smprather/janestreet-blog-serial-protocol-emulator/wiki/concepts/factored-hardware-blocks.md

---
title: Factored Hardware Blocks
created: 2026-09-17
updated: 2026-09-17
type: concept
tags: [architecture, area-budget, protocol]
sources: [raw/transcripts/gemini-asic-competition-discussion-2026-09.md]
confidence: medium
---

# Factored Hardware Blocks
> **What you'll learn here:** which hardware primitives are shared between protocols instead of written once per protocol, and why no line-coding scheme beyond NRZI/Manchester is needed
>
> **You can verify this by:** `tb/tb_pe_crc.v` proves the CRC engine across widths, and `python3 tools/gen/crc_config.py --check` regenerates the constant table this page refers to.

Keep the programmable core small by factoring shared, parameterized primitives between the execution engine and the pin matrix (TX/RX FIFOs + interrupts decouple them). Firmware then works at byte/packet level; bit-level timing lives in hardware. Area figures below are transcript estimates (~130 nm cells) to confirm after first synthesis per [[concepts/competition-overview]].

## Blocks to factor out

- 8x/16x oversampling CDR engine ([[concepts/cdr-oversampling]]): edge-triggered phase counter, majority-vote filtering, clean data-strobe/bit-clock out. Serves 10BASE-T and PS/2. IMPLEMENTED as rtl/pe_dru.v: **116 cells / 2.1k um2** mapped, vs the ~60-cell estimate. Serves 10BASE-T and PS/2 receive; it is NOT needed by UART (which tracks its own start bit from a free-running tick, in firmware — see firmware/uart_echo.pe) and not by USB-LS or CAN (NRZ with stuffing, no guaranteed transition rate to lock a phase counter to).
- Parametric SerDes shift registers (8-32 b, MSB/LSB-first, configurable shift edge): serves every listed protocol; avoids per-bit pin toggling in microcode. IMPLEMENTED as rtl/pe_serdes.v (runtime order/length, bit-placer RX): 539 cells / 11.2k um2 mapped, 17.2k um2 routed @78% util, iverilog PASS + verilator clean.
- Framing/transcoding: NRZI/Manchester transcoder, bit-stuffer/unstuffer (USB: 6 ones; CAN: 5 equal bits), OE/tri-state direction control for I2C ACKs, SWD turnaround, USB SE0. (~15-40 cells each.) IMPLEMENTED as rtl/pe_nrzi.v + rtl/pe_manch.v + rtl/pe_bitstuff.v + rtl/pe_codec_mux.v: nrzi 15 cells, manch 7, bitstuff 99 (runtime run_cfg 1-15), mux 130 — the four files are one tier, one module per file. Config byte muxes any SUBSET of stages in/out; pipeline order fixed (stuff -> line code) as that is the physically correct composition.
- Configurable CRC LFSR (polynomial/seed/bit-reversal masks): CRC-5/16 (USB), CRC-15 (CAN), CRC-32/FCS (Ethernet), CRC-8 (SMBus). ~30 instructions/bit in firmware, i.e. **240 per byte**, against the **48 clocks (and therefore 48 instructions) per byte** that a 10BASE-T byte costs at the locked 60 MHz operating point — so **5.0x** over budget, and this one is hardware by necessity. Both halves of that arithmetic are tabulated in [[concepts/ethernet-scope]] (6 clocks/bit at 60 MHz x 8 bits = 48; 240/48 = 5.0), and the clock is locked by [[decisions/adr-005-60mhz-turbo]]. The 60 MHz choice is what improved it from 7.5x at 40 MHz, so the older 7.5x figure is the pre-turbo number, not a second reading of the same one. IMPLEMENTED as rtl/pe_crc.v: **209 cells / 3.4k um2** mapped, vs the ~120-cell estimate. The overrun is the price of supporting BOTH CRC families without a mode bit — one 32-bit shift-right register serves every polynomial from CRC-5 to CRC-32, so the cell count does not grow with CRC width. Constants for every target: [[reference/crc-config]] (generated, checked against the RevEng catalogue).

## 8b/10b explicitly not needed

None of the targets use it: 10BASE-T is Manchester (8b/10b arrived with 100BASE-TX/1000BASE-T); USB LS is NRZI + stuffing; CAN is NRZ + stuffing; UART/SPI/I2C/JTAG/SWD/PS/2 are raw NRZ with clocks or start/stop framing. Revisit only if chasing gigabit-class protocols.
