smprather/janestreet-blog-serial-protocol-emulator/COLD-START.md

# Cold-start instructions

## Message to the next manager

You are the **Pi Harness & RTL Hardening Steward** for
`/home/mylesp/janestreet-blog-serial-protocol-emulator`.

Start by reading `HANDOFF.md`, `reviews/2026-09-23/PROJECT-REVIEW.md`, and
`wiki/STATUS.md`. Continue the user's persistent task: check the live Pi harness
in the shared tmux window `pi-protocol-worker` every 15 minutes (use window
names, not pane IDs — names survive an OOM or terminal loss), review completed
RTL/hardening work,
and keep the project review and handoff current. The user allows occasional
synthesis and STA screens to catch RTL that cannot be hardened. Slow corner is
also a hold-check corner. Never run physical flow, DRC, or LVS.

The default tmux server and worktree are shared live state. Never kill the tmux
server. Inspect `git status` before editing; substantial uncommitted work is
present. Do not reset, revert, or clean it. Leave Pi at its prompt after each
task. The user delegated ALL project decisions to the manager (2026-09-24):
nothing is waiting on user choices; implement the tasks the manager assigns.
The one boundary: host-controller GUI/bridge work waits for the user's plan
from their separate session.

Interrupt protocol (2026-09-24): as your LAST action before ending any turn,
write `/tmp/pi-worker-interrupt` containing a concise summary of what you did
and its evidence. Mid-task, write `QUESTION: <text>` there (and keep working)
or `BLOCKED: <text>` (and stop at your prompt). The manager deletes the file
before each dispatch and wakes on its appearance.

**WORKLOG rotation + concision (manager ruling 2026-09-25):** the shared log
rotates to `logs/worklog/YYYY-MM-DD[-NN].md` at ~10 MB or day boundaries (the
manager rotates; archives are committed and greppable - the trail never dies).
Log LINES are concise entries (≤ ~500 chars); full reports/evidence live in
`reviews/` and interrupt files - link, do not inline. This rule exists because
the log hit 58 MB and GitHub warned on every push.

## DOCS AUTHORITY (manager ruling 2026-09-26): maps are the ARCHITECTURE
## authority; figures cite the RTL, never a map
`diagrams/project-plan.puml` and `diagrams/project-progress.puml` are the
architecture authority and live on **main**. Two rules follow, and they exist
because the branches began merging into each other and a figure drawn from a map
that later moved becomes a stale claim wearing a figure's clothes:

1. **A protocol figure must cite the RTL, the frozen contracts, or the frozen
   reviews DIRECTLY — and must not restate a map claim as its source. A figure
   quoting a map is a defect in the figure.** Maps may LINK figures; never the
   reverse. So a figure's `Sources:` line points at `firmware/*.pe`, `rtl/*.v` or
   a `reviews/` contract — never at `project-plan`/`project-progress`.
2. **MAP-TRIGGER for the rolling docs review.** When the maps change on **main**,
   re-grep the whole figure set for any claim that PARALLELS map content (the C1
   class: a figure restating a number the map also states) and re-verify each
   against the RTL. A map move then costs a re-grep instead of a rediscovery.

The trigger baseline as of this ruling, so the next reviewer can tell in one
command whether the trigger has fired:

```sh
git rev-parse --short main:diagrams/project-plan.puml      # was aa2554c
git rev-parse --short main:diagrams/project-progress.puml  # was 42d4acc
```

Both were last moved by `3a2fd6a` ("refresh both maps to current reality, and
take the three accuracy corrections"). Checked against this ruling at the time:
**no figure on either docs branch cites a map as its source** — all five
`proto-*.puml` source lines point at the firmware (`firmware/dmx512.pe`,
`i2c_adv.pe`, `midi_xfer.pe`, `spi_mode3.pe`, `uart_flow.pe`), which is exactly
the pattern the ruling wants. The single grep hit, `proto-freqmeter-timing.puml`
saying "the map uses all sixteen bytes", is a MEMORY map and not `project-plan` —
a false positive from the reviewer's own check, recorded because the next
reviewer will hit it too.

**THE TRIGGER HAS FIRED, and its semantics were SHARPENED at the same time
(manager ruling, later on 2026-09-26) — the sharpened form is the one to use:**

1. **A measured ACT result is the FIGURE's claim.** The map **LINKS the owning
   figure and drops its own copy.** The six that triggered this: sr04's 5816 µs
   and 1160 µs, DMX's 12.38 µs mark and 88.06 µs break, the freqmeter's 158 Hz
   and 10 kHz endpoints. The map is architecture and indexes; it is not a second
   data store.
2. **Universal architecture constants MAY stay in the maps** — `I2CTICK` = 1 µs
   and the 260-clock / 4.3333 µs UART half-bit. They are not act measurements,
   and every act that uses or avoids that tick states it independently.
3. **The trigger now checks FIGURES-against-RTL only.** A map-vs-figure overlap on
   a *measured* number is a **DEFECT (a restatement)**, not a candidate to
   triage — which is what pass 9's sweep had to treat as a candidate, by hand,
   with a method it twice got wrong.

The map edit is diag-proto's. The trigger's job on its next fire is therefore
narrower and sharper: re-verify each act figure's measured numbers against the
RTL and its testbench, and report any measured number that also appears in a map
as a defect, with the figure named.

## THE MERGE GATE (manager standing order, 2026-09-25). A merge is not pushed
until `regress/verify_merge.sh` is green, and its output is quoted in the
interrupt. This exists because 5b4731f was pushed with six RED timing acts and
every gate the project owns had been green a minute earlier: R3's new
`dbg_hold`/`dbg_step` inputs never reached the fw branch's testbenches, so their
ports floated to Z, the execute gate went X and six unrelated programs sat at
reset. No gate could catch it — until the merge, the two states did not coexist.
`./regress/verify_merge.sh --list` prints the affected set and runs nothing;
`--self-test` runs the mapper's own 27 checks; exit 1 is red WITH a named case,
3 is a gate error, and **4 is inconclusive (the run died) — which is not a pass
and must not be reported as one**. Full evidence:
`reviews/2026-09-25/MERGE-FORENSICS-5B4731F.md` §5-§6.

**The mutation suites are MAPPED, not skipped** (manager ruling 2026-09-25). A
narrowed gate runs a suite only if one of its `MUTABLE` targets intersects the
merge's changed set, and it PRINTS every suite as RUN or SKIP with the reason —
so a green gate says what it covered and what it did not. Anything unmappable
(no `MUTABLE` line) or an empty selection runs ALL suites; a suite with an EMPTY
`MUTABLE` mutates nothing in the repo and is never narrowed away. The
`MUTATE_ONLY` selector travels as an environment variable, so an ordinary
`./regress/run_all.sh` — the master/nightly gate — is untouched and always runs
everything. `regress/check_mutation_lists.sh` proves each `MUTABLE` list still
covers every file its harness writes, and runs inside the full gate too: a
stale list would make the mapper skip the suite guarding a changed file.

## Continuous work protocol (user standing order 2026-09-25: "I don't want
to come back and find nobody working")

- The queue is the source of work: `wiki/STATUS.md` "Next steps (ordered)",
  the current checkpoint queue in this file, and any dispatch message.
- **CHAIN TASKS — WITHIN THE SAME TURN.** A pi session cannot start its own
  next turn, so chaining MUST happen before you end the turn: when a task is
  done and the queue holds a clearly-scoped next task (inside the
  manager-adopted plans, no new design decision needed), rewrite the
  interrupt file for the finished task and IMMEDIATELY start the next task
  in the same turn, logging `TASK-START` in `WORKLOG.md`. The interrupt file
  is the manager's async review trigger — it is NOT the end of your work.
  ENDING YOUR TURN MEANS STOPPING: only end the turn when the queue is
  empty (`IDLE-QUEUE-EMPTY` in WORKLOG), the next step is ambiguous or
  needs a ruling (`QUESTION:`), or it touches the host-controller boundary
  (`BLOCKED:`). (Root cause, 2026-09-25: workers wrote the interrupt as
  their last action and ended the turn — chaining then never triggered and
  the user found idle TUIs. Same-turn continuation is the fix.)
- STOP chaining and wait for the manager only when: the next step is
  ambiguous or needs a design/ruling decision, it touches the host-controller
  boundary (write `BLOCKED:`), the queue is empty, or the dispatch explicitly
  says stop.
- If your input box contains unexpected text when a turn ends, treat it as a
  possibly-mangled mid-turn dispatch from the manager: surface it in your
  interrupt (`QUESTION:`) instead of ignoring it.
- **BEFORE REPORTING AN ITEM OPEN, CHECK THE OWNER'S LOG (manager rule,
  2026-09-25).** Never report another actor's work as open from your own
  picture of the tree: `grep 'actor | TASK-DONE' WORKLOG.md` for the owning
  actor first. The trap is real and it bit me — I wrote "memory reads are
  EXPECTED to fail until the host fixes B1" into the bring-up runbook, and the
  gui-worker had already fixed B1 and pushed it minutes earlier. A stale
  warning is as harmful as a missing one: it sends a board operator down the
  wrong path and invents work that is already finished.
- Throughput discipline: prefer whole plan tasks per dispatch; keep the tree
  green at every task boundary (mutation harnesses must restore and
  `cmp`-verify before you move on); never reset/revert/clean the shared
  uncommitted worktree.
- **ONE RUN AT A TIME (single-run lock, 2026-09-25).** This worktree is shared,
  so only one mutation-capable run may be in it at once. `regress/run_all.sh`,
  every `regress/mutate_*.sh` and `regress/run_firmware_tests.sh` take
  `flock` on `/tmp/chip-run-all.lock` (via `regress/run_lock.sh`) and **fail
  fast** with exit 75 and a message naming the current holder. The lock is
  process-based, so a killed run releases it automatically — there is no stale
  lock to clear by hand. It is reentrant through `CHIP_RUN_LOCK_HELD`, because
  `run_all.sh` invokes the mutation harnesses as its own children; those skip
  the lock rather than deadlocking their parent. The hazard it closes is real:
  on 2026-09-25 the manager's `run_all_merge` and the worker's `run_all` ran
  CONCURRENTLY, so two harnesses were mutating and restoring the same RTL at
  once. The per-case `cmp` restores held and nothing was corrupted, but a run
  can read a file another run has mutated — precisely the "nonsense result"
  failure the harnesses exist to detect. If you see `REFUSING TO START`, wait
  for the other run; do not retry in a loop.
- **Shared worklog (user standing order 2026-09-25):** append EVERY state
  change to `WORKLOG.md` in the repo root — one line,
  `YYYY-MM-DD HH:MM TZ | protocol-worker | EVENT | detail`, newest at the
  bottom, append-only. Events: `TASK-START`, `TASK-DONE`, `CHAIN`,
  `QUESTION`, `BLOCKED`, `RULING`, `STALL` (+ the exact reason),
  `CONTEXT-NEW` (after a `/new`). The log is the manager's debugging paper
  trail: when work stops, the manager back-traces it here and fixes the
  cause. Log the START of a task the moment you begin it — not only the
  finish — so a stall mid-task is visible.

## Current checkpoint — 2026-09-24 evening (supersedes the checkpoints below)

- The user delegated every project decision to the manager ("no pending my
  authorization at all; drive the project to completion without my
  intervention"). Decisions made and executed: E2-6 fix (CLOSED), readback =
  A1 (verified), SERDES+codec integration = the recorded recommended defaults
  (Task 3, verified), closeout hardening (Task 4, verified), squarer diagram
  layout (Task 5a, verified), hold-screen attribution (Task 5b, verified).
  GUI planning is the user's in a separate session.
- The worker runs in the shared tmux window **`pi-protocol-worker`** (created
  2026-09-24 after a wezterm OOM killed the old `%46` pane). Use window
  names, not pane IDs — names survive an OOM or terminal loss, pane IDs do
  not. Target the worker as `tmux ... -t 0:pi-protocol-worker`.
- Task 1 (E2-6 + R3 checker fixes): DONE and manager-verified — macro harness
  26/26 re-run, identity-logic code review, full regression exit 0. E2-6 and
  R3 are CLOSED; R1/R4/R5 remain recorded observations.
- Task 2 (A1 readback, `uio[4]` echo): DONE and manager-verified —
  `./regress/run_all.sh --fast -j8` 29/29 + 20/20 exit 0; mapped `pe_ctrl` STA
  screen worst setup +8.71/+8.80/+8.86 ns, worst hold −0.12/−0.16/−0.19 ns
  (unchanged from pre-A1), new echo/`spi_miso` max-path groups
  +12.09/+12.19/+12.23 ns. Evidence: `reviews/2026-09-24/`
  (`PE-CTRL-READBACK-REVIEW.md`, `manager-a1-sta/`). Baselines now: `pe_ctrl`
  463 cells / 8,661.30 µm², `pe_soc` 3,571 / 56,816.88 µm², `tt_um_top`
  4,038 / 65,686.27 µm².
- Task 3 (SERDES + codec integration, STATUS item 7): DONE and
  manager-verified (30/30 RTL, 21/21 firmware, ten mutation suites;
  `pe_soc` 4,961 cells / 82,893.77 µm², `tt_um_top` 5,363 / 91,268.06 µm²).
- Task 4 (closeout hardening: SERDES mapped STA refresh + codec mutation
  suite): DONE and manager-verified —
  `reviews/2026-09-24/CLOSEOUT-HARDENING-REVIEW.md`.
- Task 5a (squarer diagram layout, both maps): DONE — plan 3194×2476
  (1.29:1), progress 3681×2493 (1.48:1);
  `reviews/2026-09-24/DIAGRAM-SQUARER-LAYOUT.md`.
- Task 5b (hold-screen attribution + BOARD-assumption STA variants): DONE —
  `reviews/2026-09-24/HOLD-SCREEN-ATTRIBUTION.md`.
- Post-restart progress (2026-09-24 evening): Task 6 (5a/5b docs catch-up)
  DONE; Task 7 (eth-tx plan `wiki/plans/eth-tx-frame-path.md`, eight scope
  groups with defaults) DONE and the manager ADOPTED G1-G8; Tasks 8-9
  reconciled and verified the unrecorded chip-side host-protocol phase R1
  from the separate host-controller session (audited against its
  `HOST-CONTROLLER-PLAN-REVIEW` in the read-only
  `/tmp/opencode/host-controller-gui`; the A1 `uio[4]` echo is retired per
  the R0 pad ruling, its commit-latched/abort semantics live in the framed
  LOAD response; R1 pad map = `uio[4:7]` host row, `uo_out[1]` IRQ_N,
  `ui_in[3:5]` freed, 19/24 committed); lint, full regression (30/30 RTL,
  21/21 firmware, ten mutation suites), the 29/29 ctrl suite and synth are
  green after two manager-authorized behavior-preserving `pe_ctrl` fixes.
  Queue status (manager update 2026-09-25 ~01:55 CDT): plan Tasks 1-5 are
  LANDED and recorded (Manager Tasks 10-11; see the manager section in
  `reviews/2026-09-23/PROJECT-REVIEW.md`). The tree is GREEN (33/33 RTL,
  26/26 firmware, ten mutation suites). The 2026-09-24 18:43 kernel OOM
  (runaway python3, 22 GB) killed sessions mid-task and left an unrestored
  `mutate_i2c_tb.sh` m1 mutant in `rtl/pe_pinmux.v` — restored byte-exact
  from the harness snapshot. Next: plan Task 6 (eth_tx mutation suites),
  then plan Task 7 (STA + closeout), then final closeout. A RAM watchdog
  (`tools/manager/mem_monitor.sh` -> `/tmp/pi-mem-interrupt`) now guards the
  box; manager standing orders: always stay in the interrupt loop, and on a
  MEM interrupt debug and fix. The SDD ledger
  .superpowers/sdd/eth-tx-frame-path/progress.md is the task-level record.
  OPEN FINDING (a): the P3 heartbeat
  liveness gap — the heartbeat pad is gone and the R1 STATUS layout omits
  timer/pc/a/x/y, so nothing shows liveness until the R2 read path. STATUS
  item 8 GUI implementation awaits the user's plan.

## Checkpoint archive — 2026-09-23 evening (historical, superseded above)

- Pi pane `%46` returned to its prompt; last checked at 22:55 CDT, with the
  next 15-minute check due around 23:10 CDT. `wiki/STATUS.md` has no ungated
  implementation task: item 8 awaits acceptance; the readback and SERDES plans
  still need the user's choices; E2-6 awaits a decision to authorize its fix.
- Pi's draft for the Linux demo-host GUI is in `wiki/plans/demo-host-gui.md`
  (STATUS item 8 remains TODO pending user acceptance). It describes the Linux
  PC → RP2040 Pico on the Tiny Tapeout dev board → ASIC path. The Pico/RP2040 is
  the user's selected controller. PC-to-board USB/serial/HID transport remains
  hypothetical until verified. The loader SCLK cap follows `clk/6`, so 10 MHz
  is valid only at the 60 MHz operating point; the plan retains the
  sky130-framed clock-spec caveat. The seven generated-document checks passed
  explicitly by name in this session. The source/claim audit is complete and
  recorded in `reviews/2026-09-23/PROJECT-REVIEW.md` and `HANDOFF.md`.
- Pi independently exercised the E2 macro-flow checker with synthetic
  fixtures. The mutation harness reports 20/20, but this does not close the
  residual observations R1–R5 in the project review. The false pass is tracked
  as **E2-6 / R2**:
  macro type `RM_IHPSG_FAKE_B` has a 100×100 LEF and is placed at (20, 0) in a
  50×50 die, but its config points to type A's 10×10 LEF. The checker measures
  the configured file's `SIZE` without verifying that its `MACRO` declaration
  matches the configured macro type, so it accepts the invalid placement.
  Other confirmed gaps: stale PDN entries for absent instances are ignored
  (R1); wildcard liberty coverage and corner-key/file mismatches pass (R3);
  supply-pin names are hard-coded (R4); and legal alternate instance regex
  spellings are rejected (R5, fail-closed). A `-grid stdcell` PDN-connect
  probe is correctly rejected. No E2 fix was applied.
- Do **not** report E2 as fully closed. Pi recorded the GUI-plan audit and E2
  findings in `HANDOFF.md` and `reviews/2026-09-23/PROJECT-REVIEW.md`. A
  suggested next fix is to match each LEF's `MACRO` name to its configured type
  and add a regression mutation. Keep all E2 findings open until corrected and
  independently verified.
- Existing E1 evidence is recorded in
  `reviews/2026-09-23/E1-PUBLISHED-OWNERSHIP-REVIEW.md` and
  `reviews/2026-09-23/e1-published-ownership/`. Prior notes report the full fast
  regression and 30/30 MAC mutation results, plus mapped Yosys/OpenSTA screens;
  these are not physical signoff. At 22:53 CDT, mapped synthesis and three
  corner OpenSTA were rerun: synthesis counts unchanged, setup 0.00 ns, hold
  −0.87/−0.61/−0.48 ns slow/typ/fast. Fresh STA output was byte-identical to the
  recorded exact-source reports. Logs: `/tmp/e1-refresh-20260923/`.

## Pasteable short prompt

> Continue as the Pi Harness & RTL Hardening Steward. Read `COLD-START.md`,
> `HANDOFF.md`, `reviews/2026-09-23/PROJECT-REVIEW.md`, and `wiki/STATUS.md`.
> The user delegated all project decisions to the manager; implement the tasks
> the manager assigns and CHAIN into the next scoped queue item without
> idling (see the Continuous work protocol below), and
> write `/tmp/pi-worker-interrupt` (summary, or
> `QUESTION:`/`BLOCKED:` + text) as your last action before ending a turn.
> Preserve the shared uncommitted worktree. You run in the tmux window
> `pi-protocol-worker` (use window names, not pane IDs). Tasks 1-5b are
> landed and manager-verified (E2-6/R3 fixes, A1 readback, SERDES+codec
> integration, closeout hardening, diagram layout, hold attribution); the
> current queue is in `COLD-START.md`'s checkpoint. Synthesis/STA screens are
> allowed; physical flow, DRC and LVS are prohibited.
