smprather/janestreet-blog-serial-protocol-emulator/diagrams/proto-dht11-frame.png

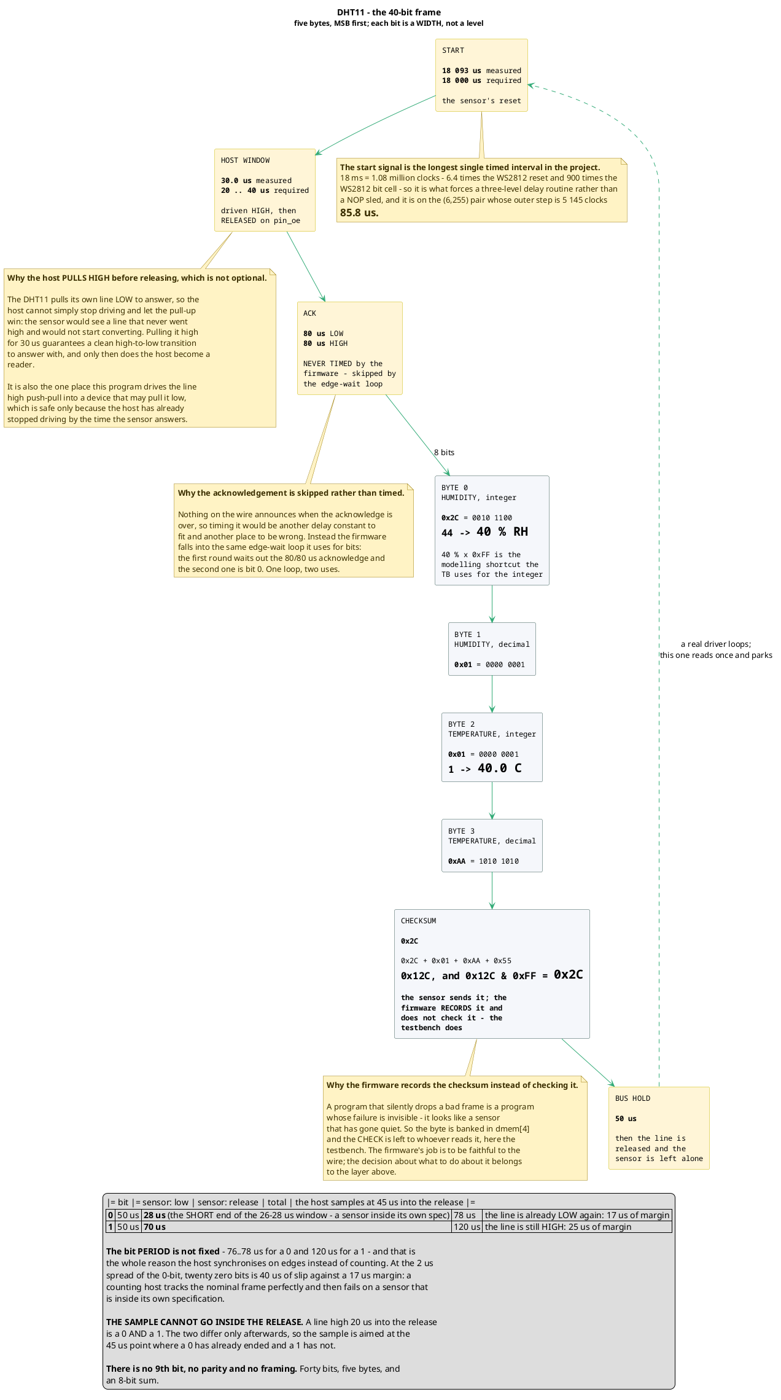
diagrams/proto-dht11-frame.png
