smprather/janestreet-blog-serial-protocol-emulator/diagrams/proto-dht11-timing.png

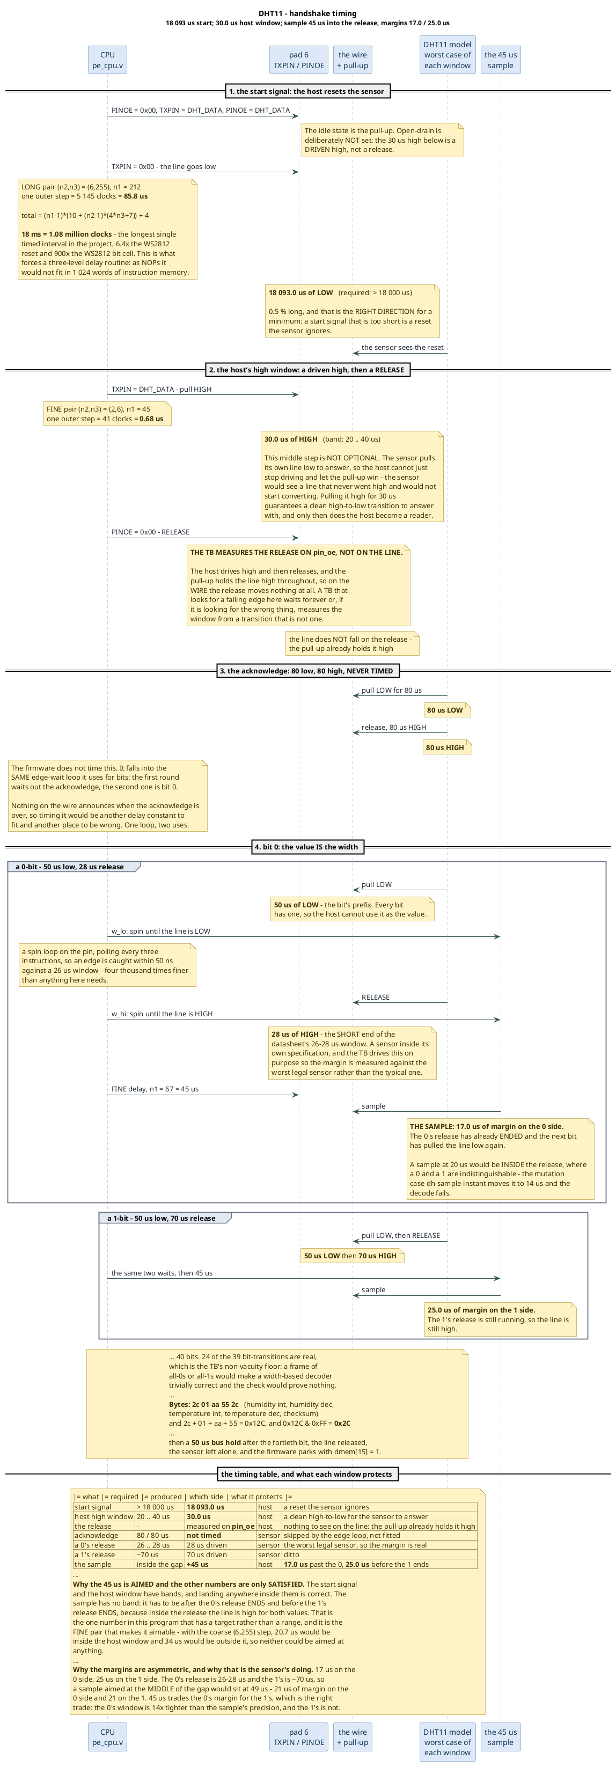
diagrams/proto-dht11-timing.png
