smprather/janestreet-blog-serial-protocol-emulator/diagrams/proto-dht11.png

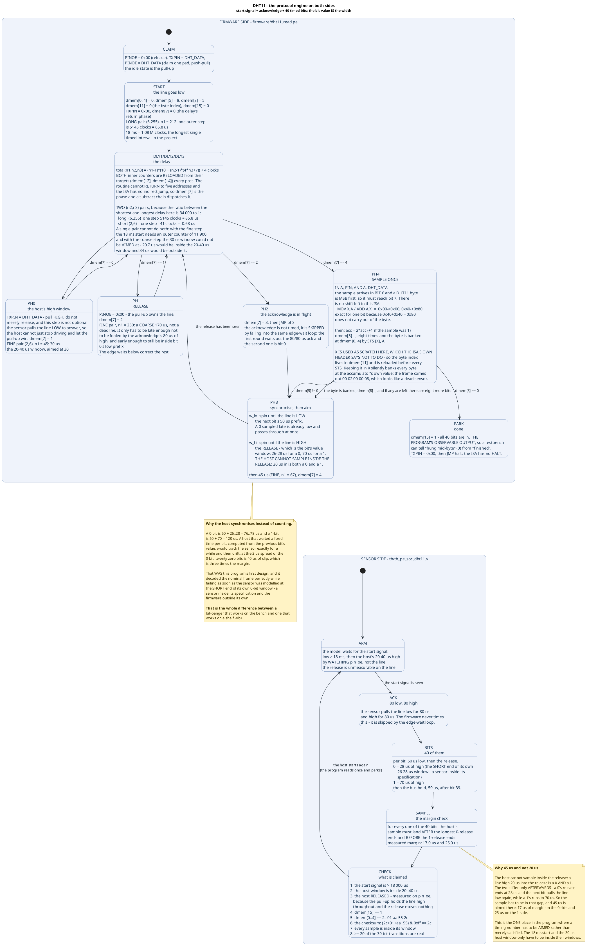
diagrams/proto-dht11.png
