smprather/janestreet-blog-serial-protocol-emulator/diagrams/proto-dmx512.png

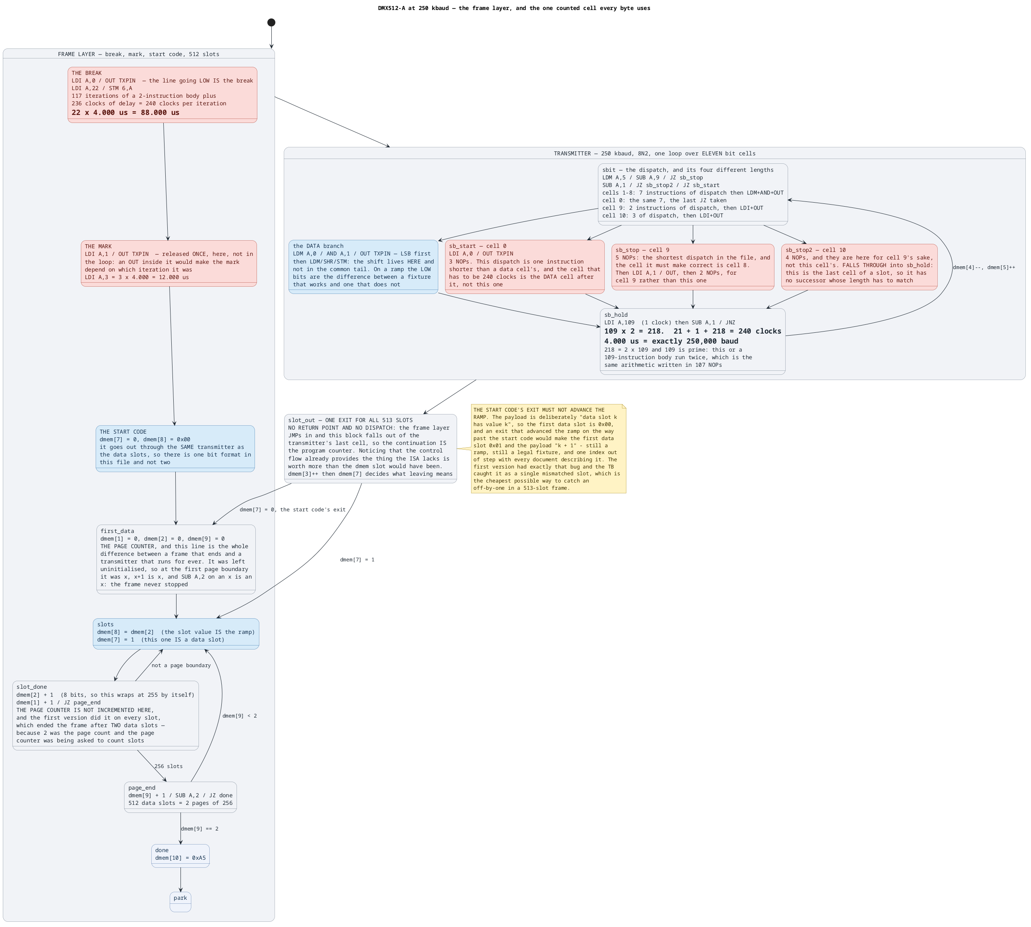
diagrams/proto-dmx512.png
