smprather/janestreet-blog-serial-protocol-emulator/diagrams/proto-dmx512_001.png

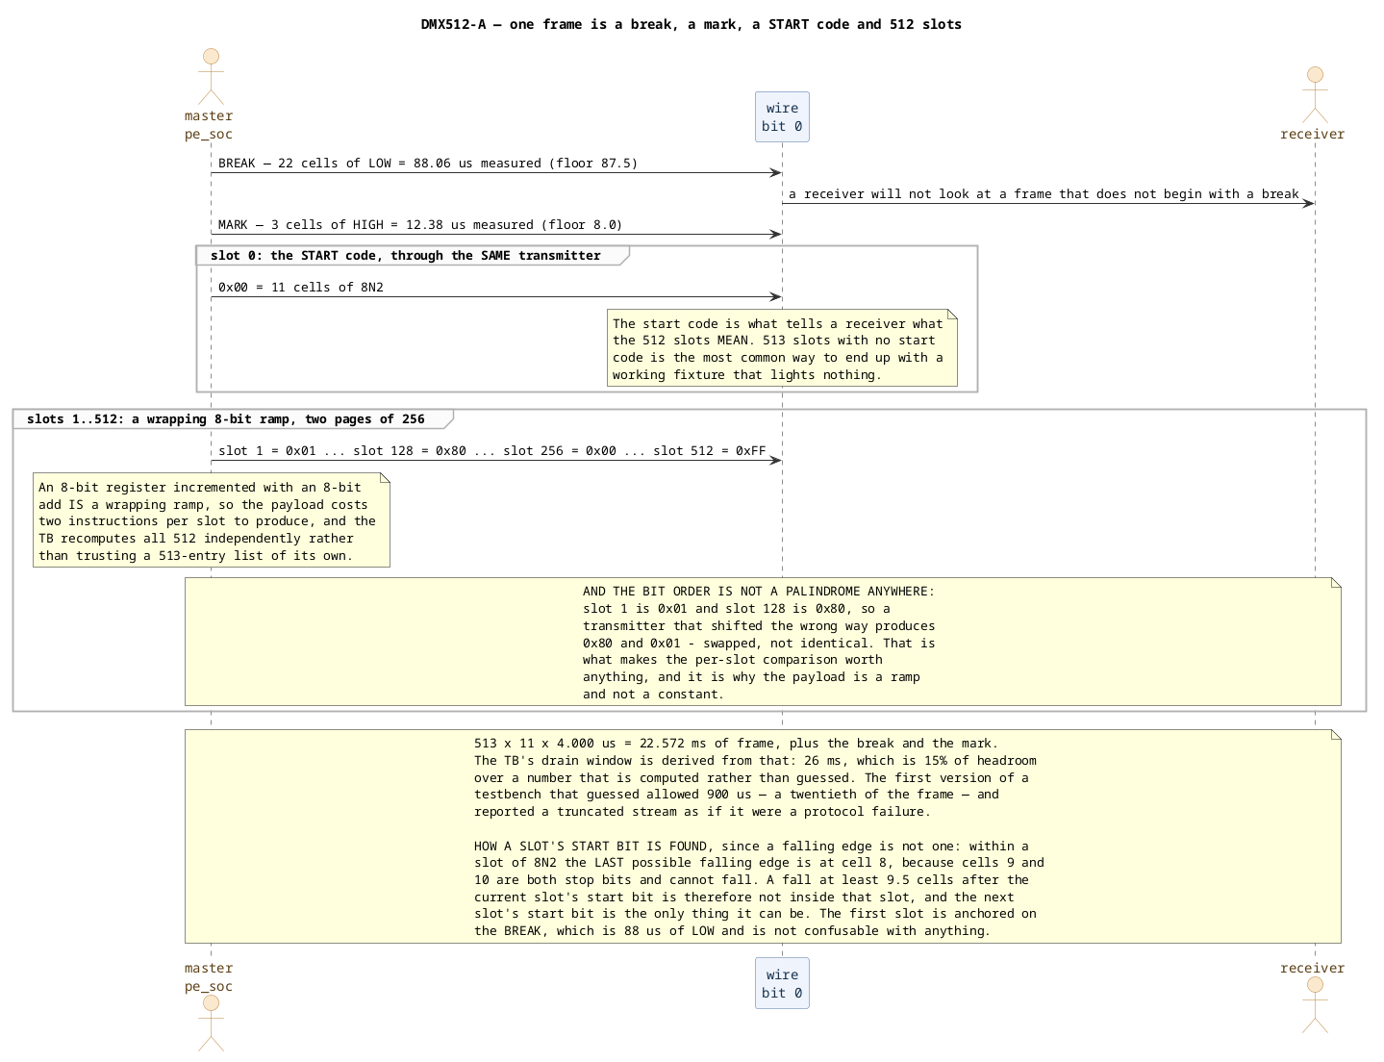
diagrams/proto-dmx512_001.png
