smprather/janestreet-blog-serial-protocol-emulator/diagrams/proto-dmx512_002.png

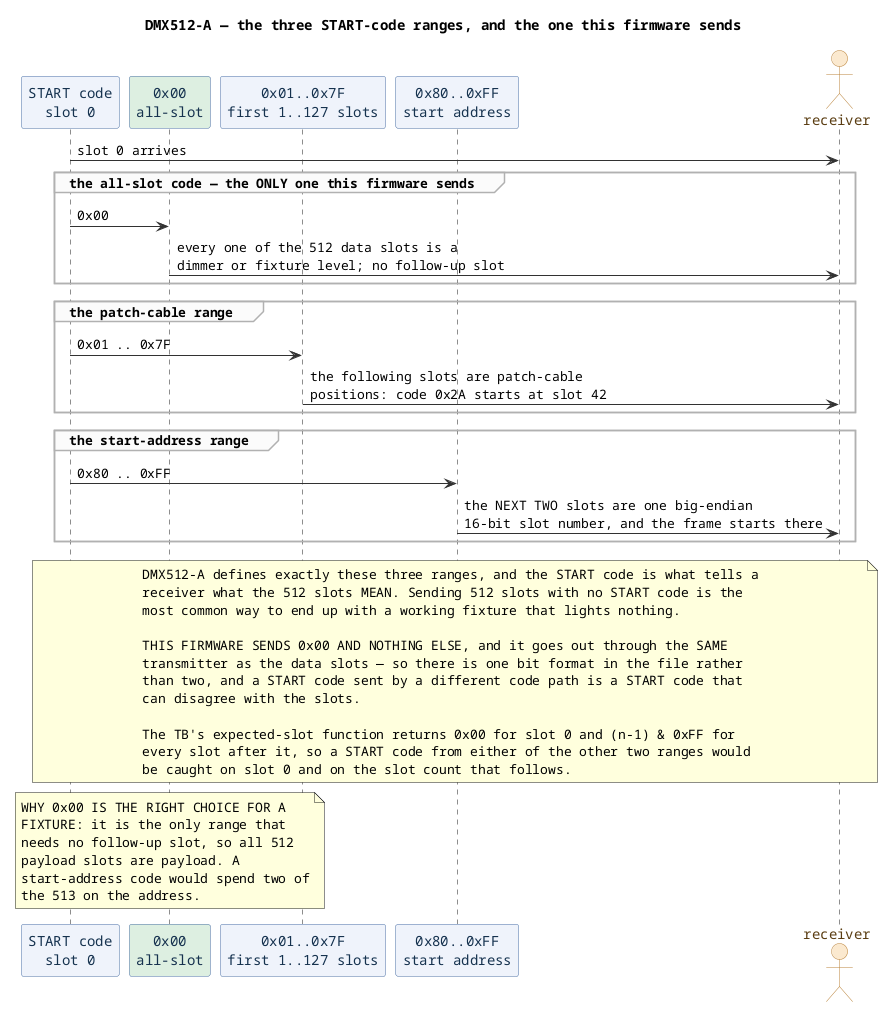
diagrams/proto-dmx512_002.png
