smprather/janestreet-blog-serial-protocol-emulator/diagrams/proto-dmx512_003.png

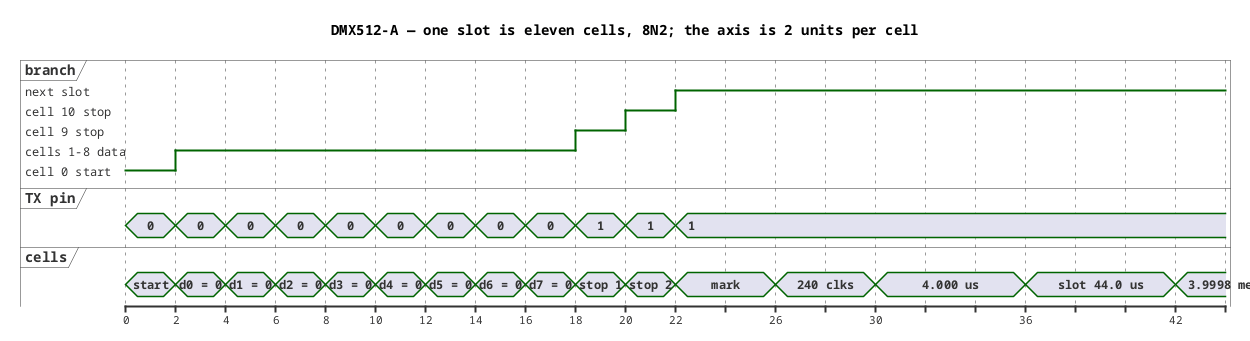
diagrams/proto-dmx512_003.png
