smprather/janestreet-blog-serial-protocol-emulator/diagrams/proto-dmx512_004.png

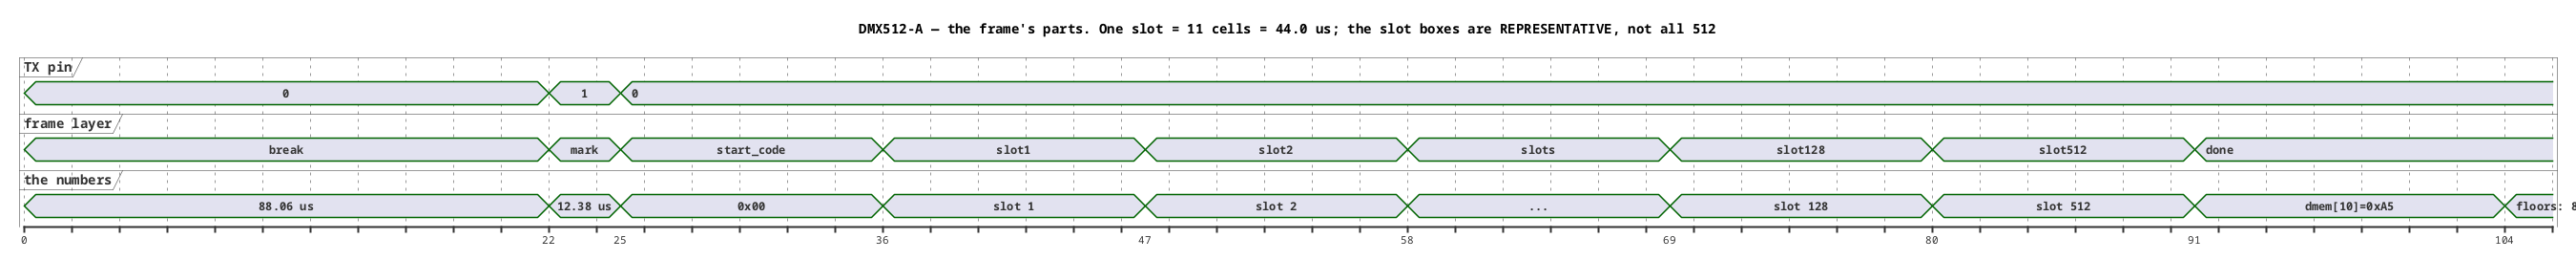
diagrams/proto-dmx512_004.png
