smprather/janestreet-blog-serial-protocol-emulator/diagrams/proto-ds18b20-frame.png

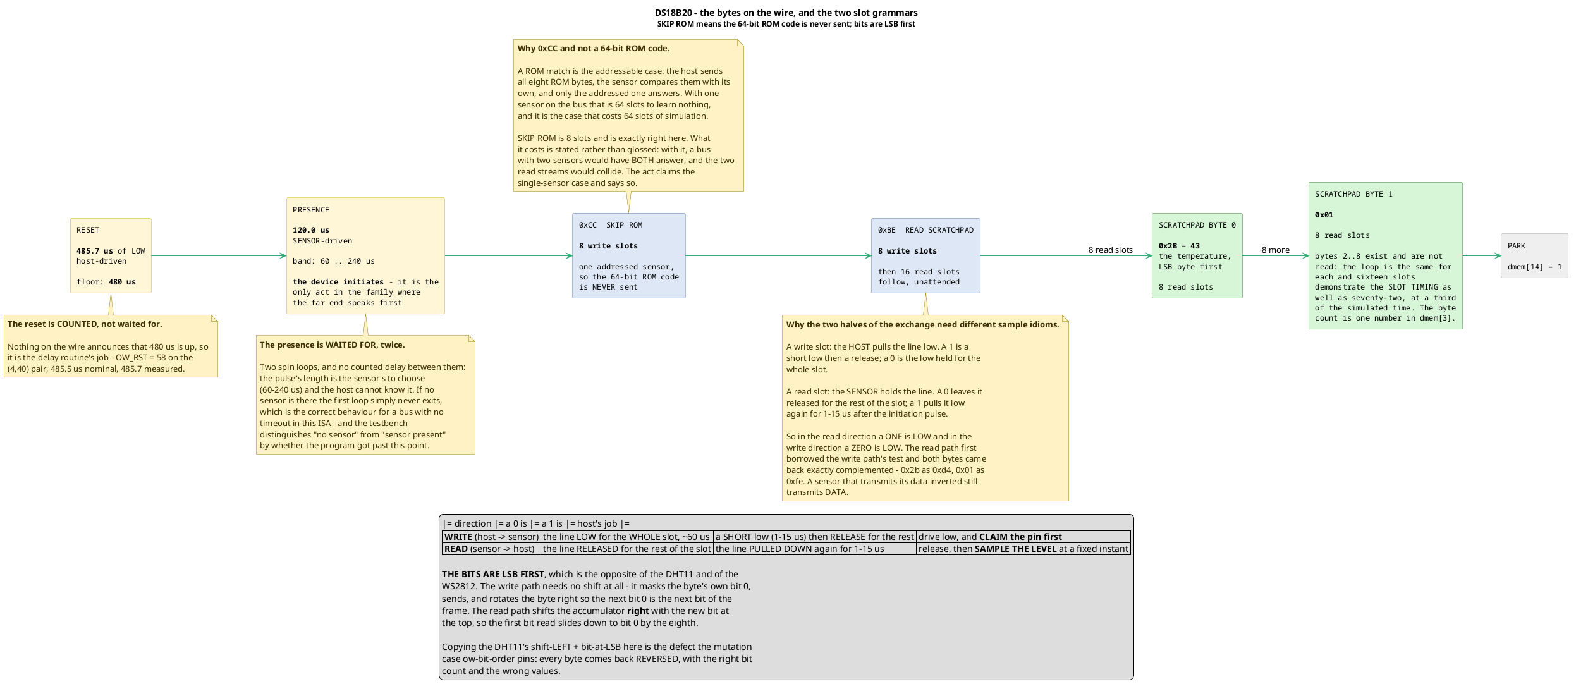
diagrams/proto-ds18b20-frame.png
