smprather/janestreet-blog-serial-protocol-emulator/diagrams/proto-ds18b20-timing.png

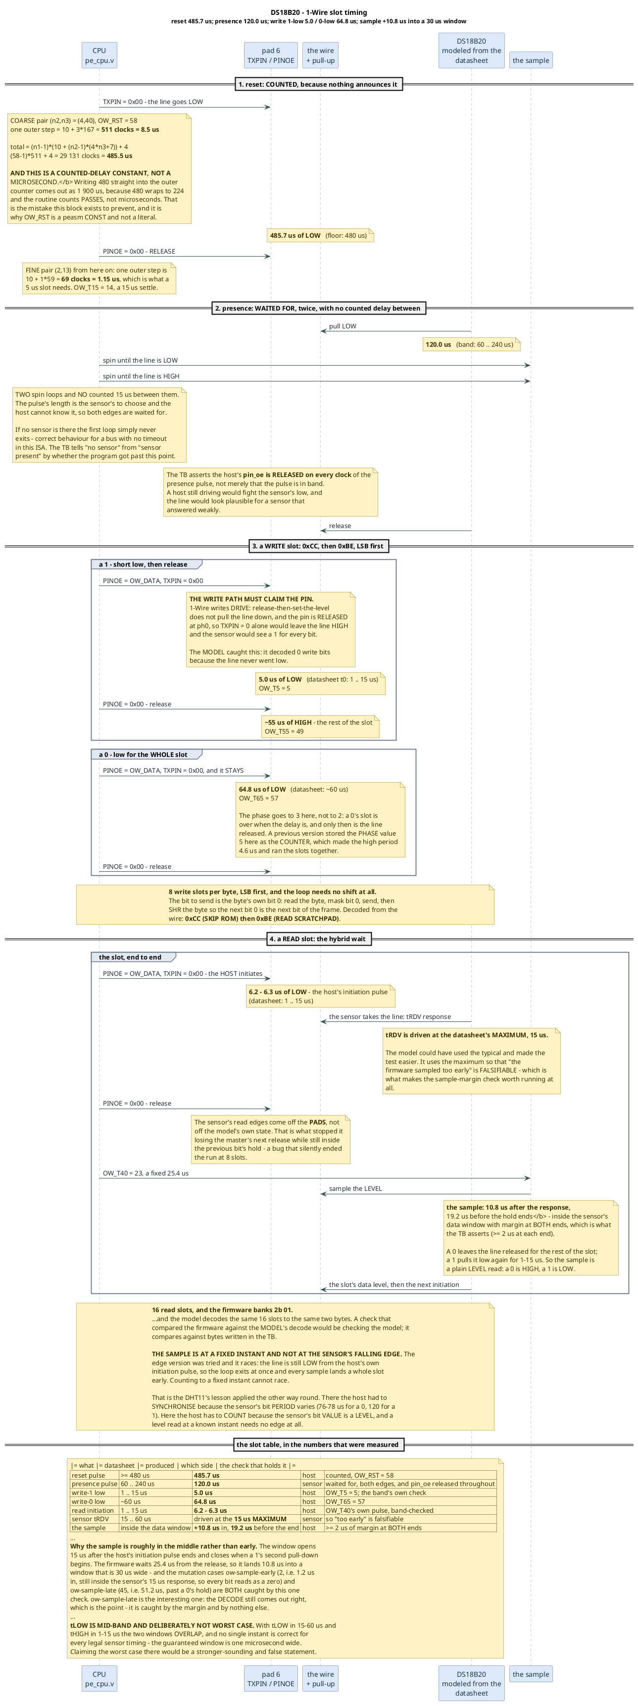
diagrams/proto-ds18b20-timing.png
