smprather/janestreet-blog-serial-protocol-emulator/diagrams/proto-fm-biphase-frame.png

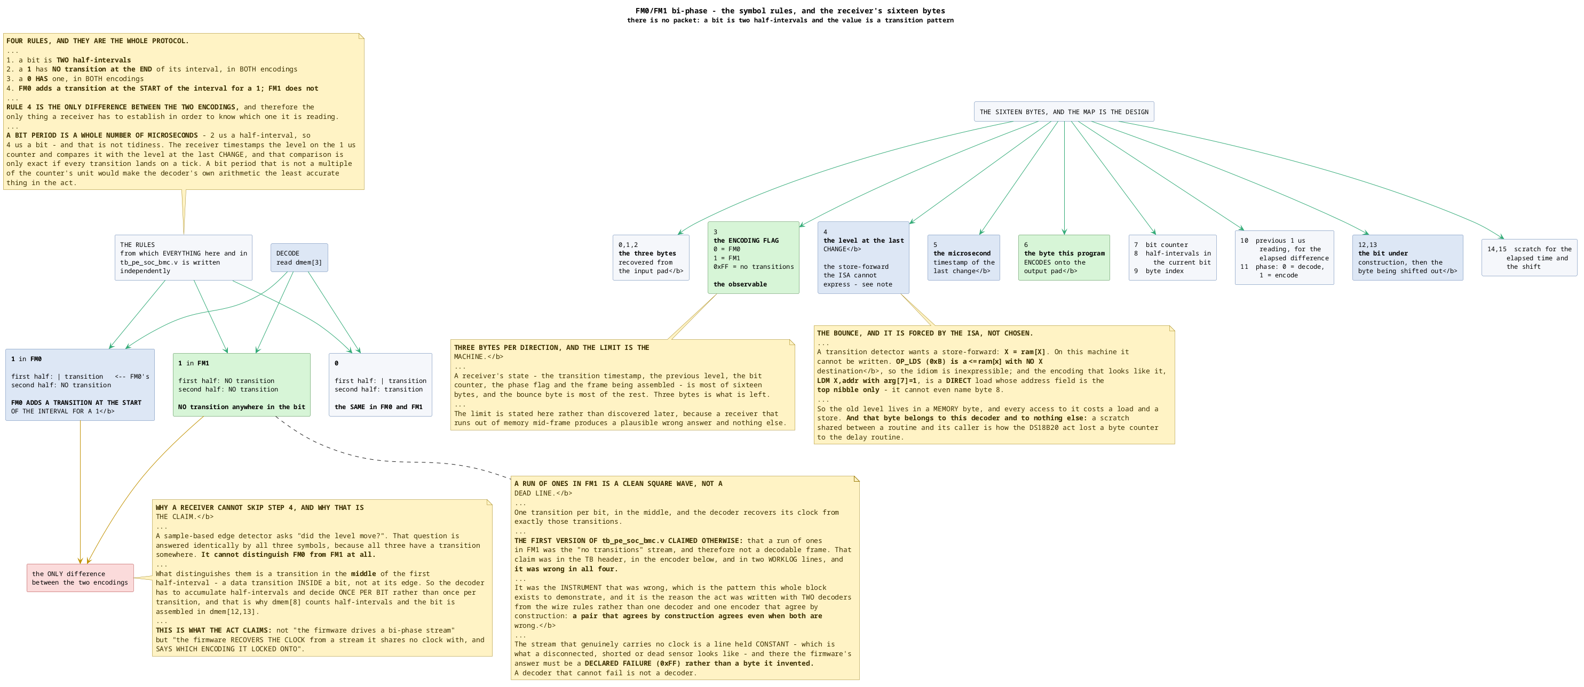
diagrams/proto-fm-biphase-frame.png
