smprather/janestreet-blog-serial-protocol-emulator/diagrams/proto-fm-biphase-timing.png

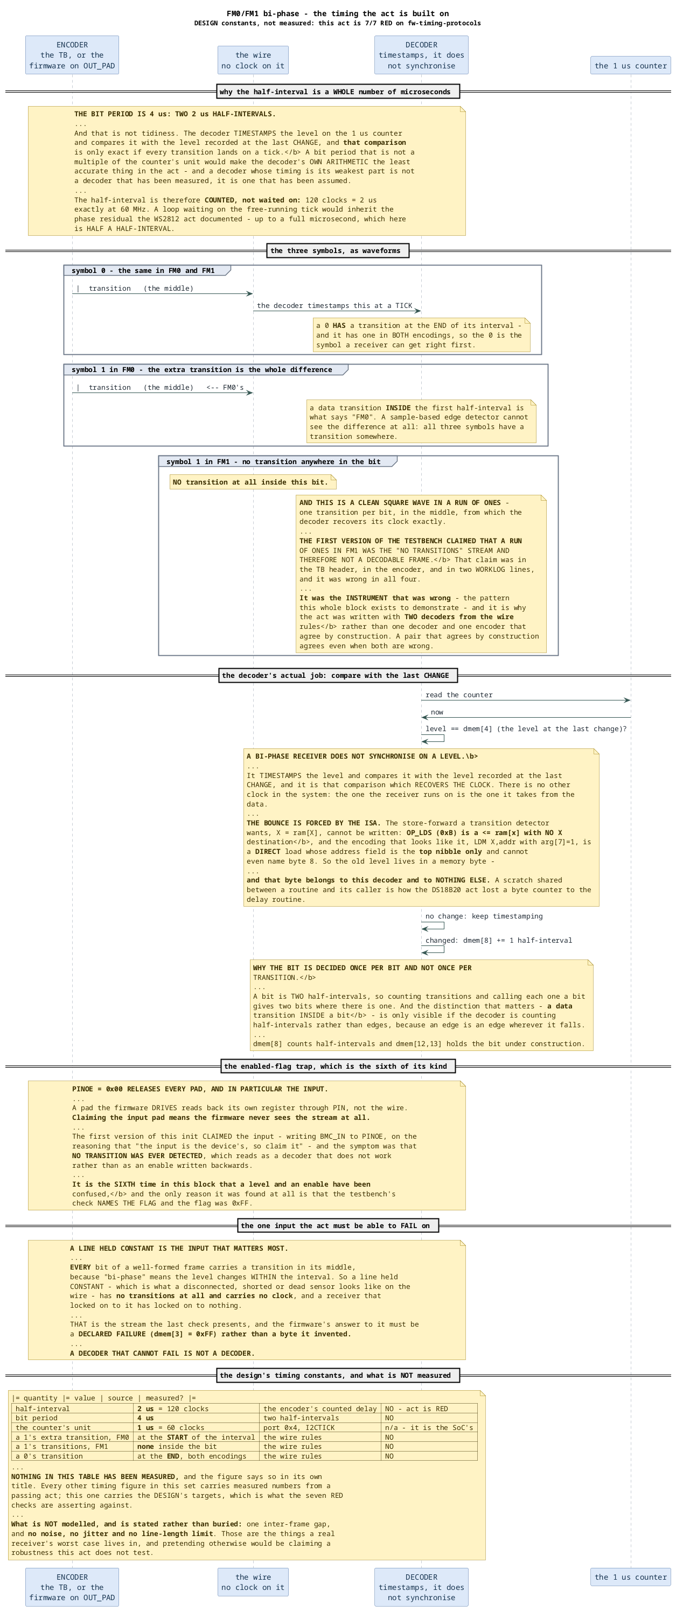
diagrams/proto-fm-biphase-timing.png
