smprather/janestreet-blog-serial-protocol-emulator/diagrams/proto-fm-biphase.png

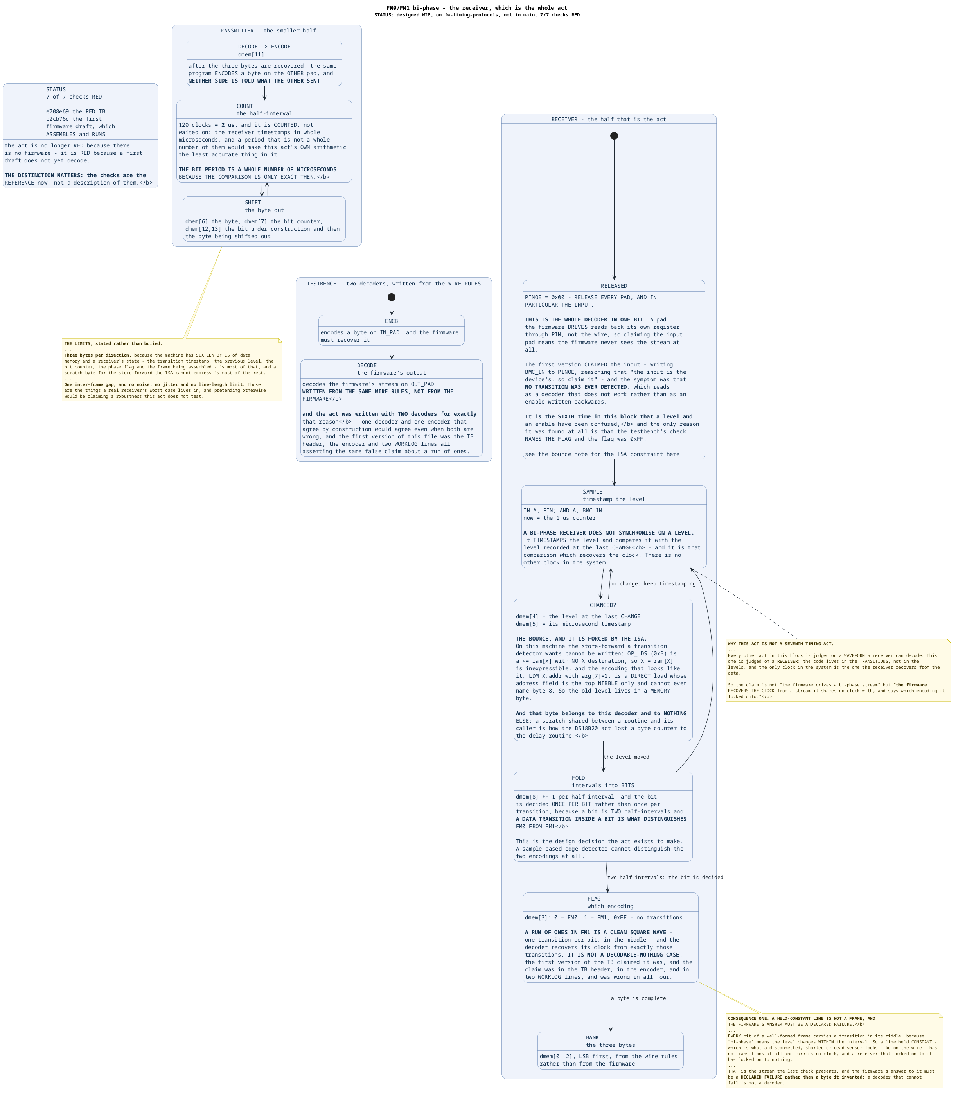
diagrams/proto-fm-biphase.png
