smprather/janestreet-blog-serial-protocol-emulator/diagrams/proto-freqmeter-frame.png

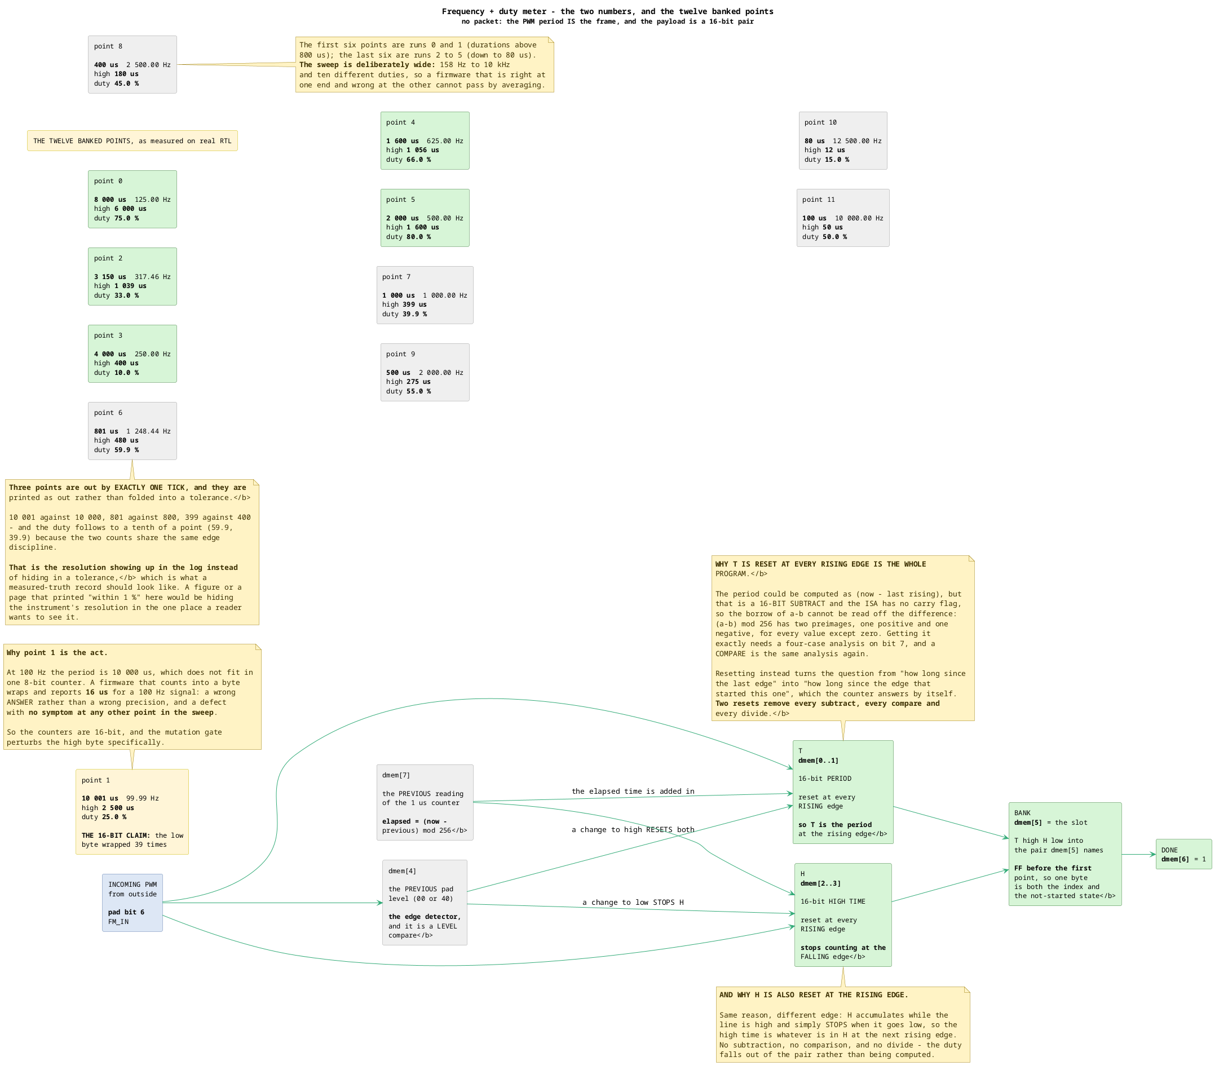
diagrams/proto-freqmeter-frame.png
