smprather/janestreet-blog-serial-protocol-emulator/diagrams/proto-freqmeter-timing.png

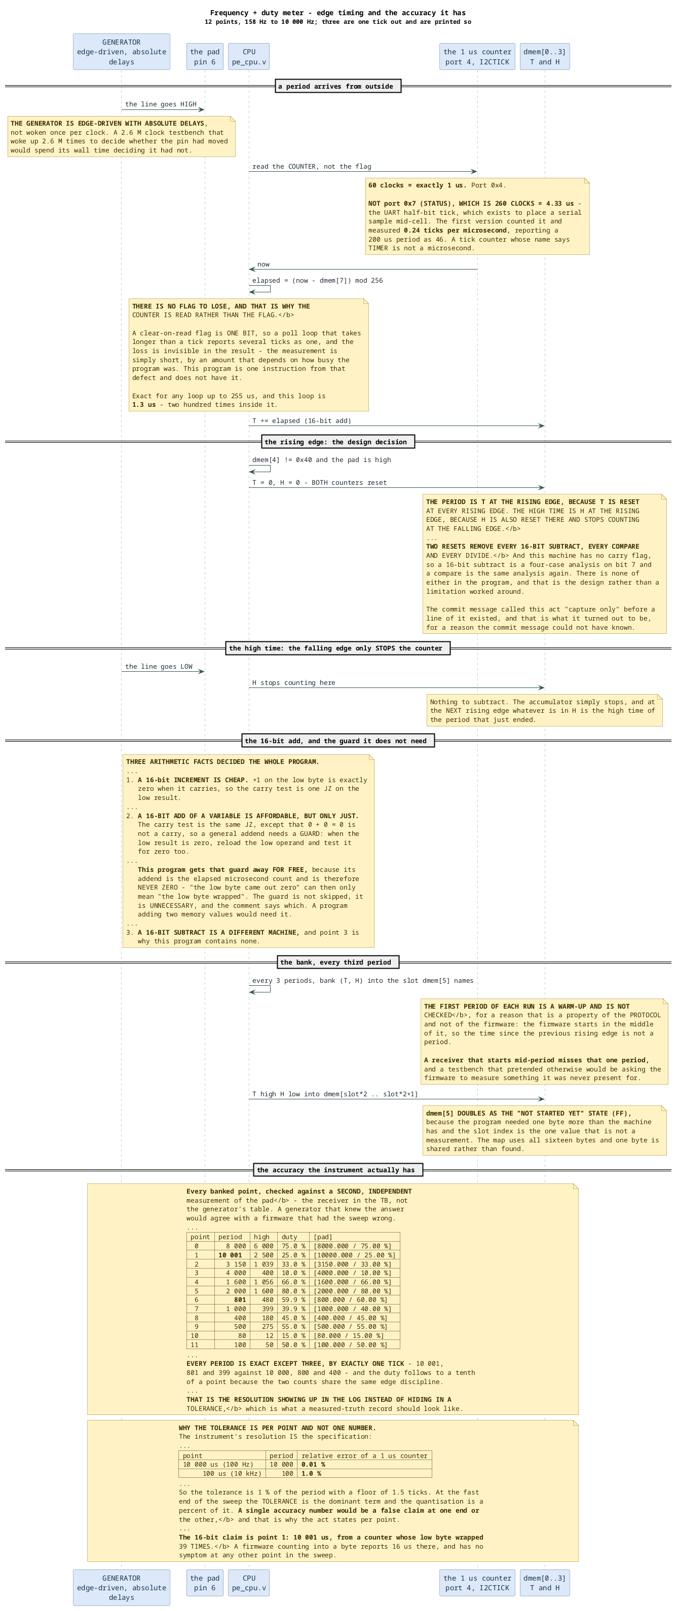
diagrams/proto-freqmeter-timing.png
