smprather/janestreet-blog-serial-protocol-emulator/diagrams/proto-freqmeter.png

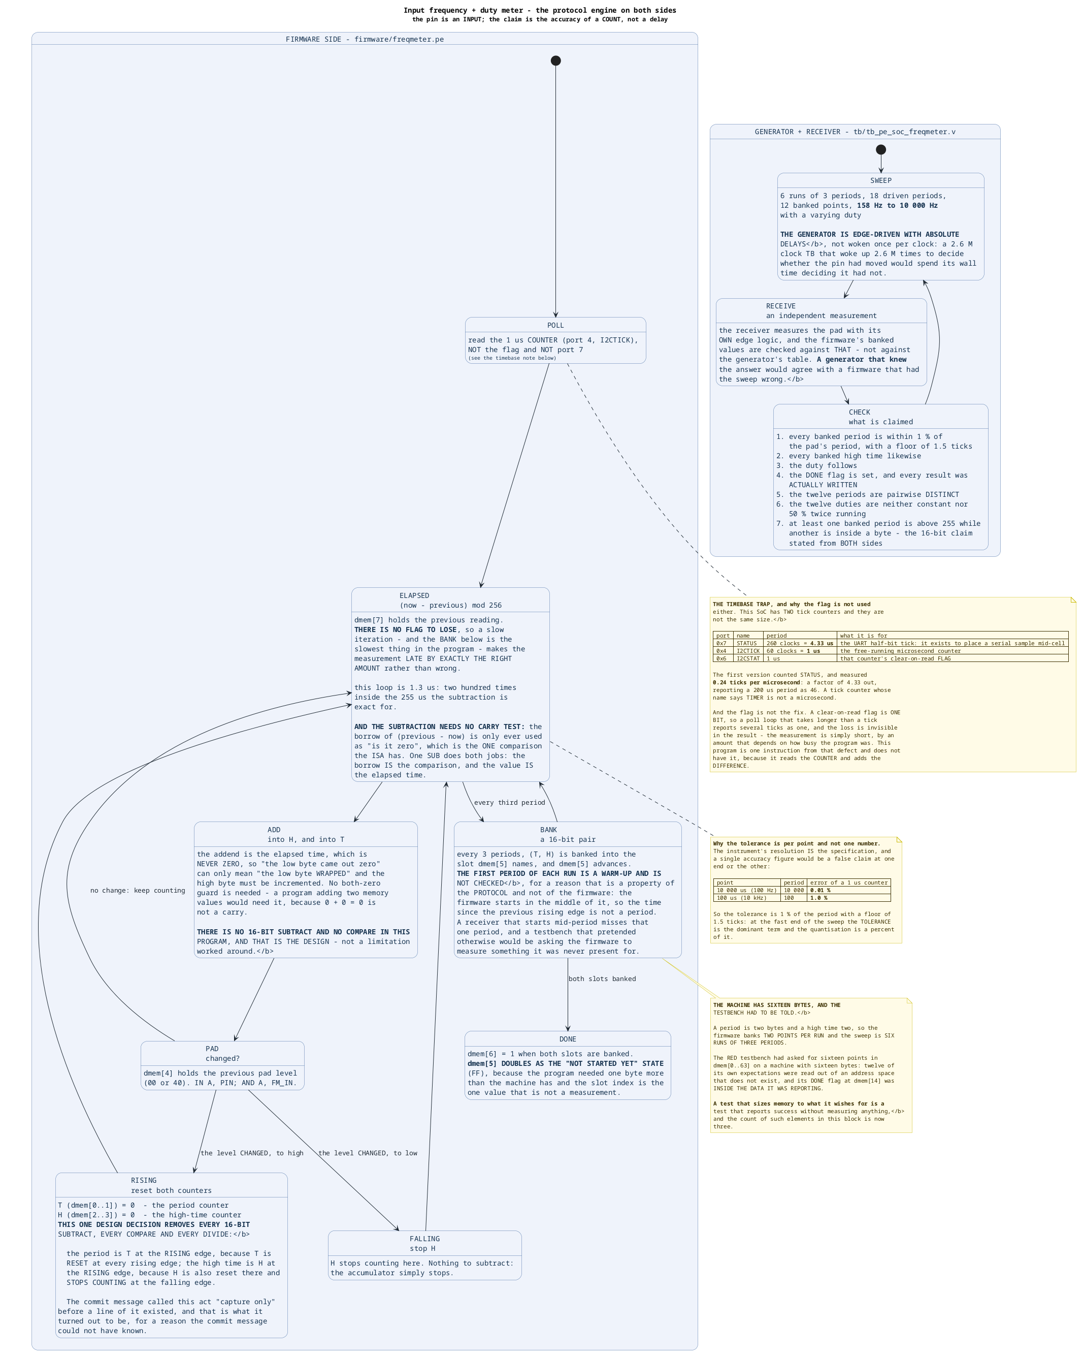
diagrams/proto-freqmeter.png
