smprather/janestreet-blog-serial-protocol-emulator/diagrams/proto-i2c-adv.png

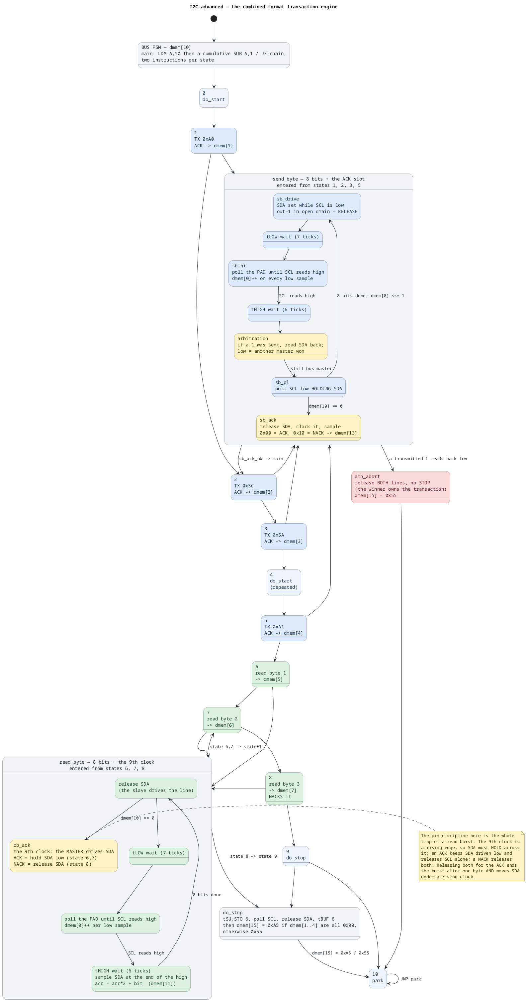
diagrams/proto-i2c-adv.png
