smprather/janestreet-blog-serial-protocol-emulator/diagrams/proto-i2c-adv_004.png

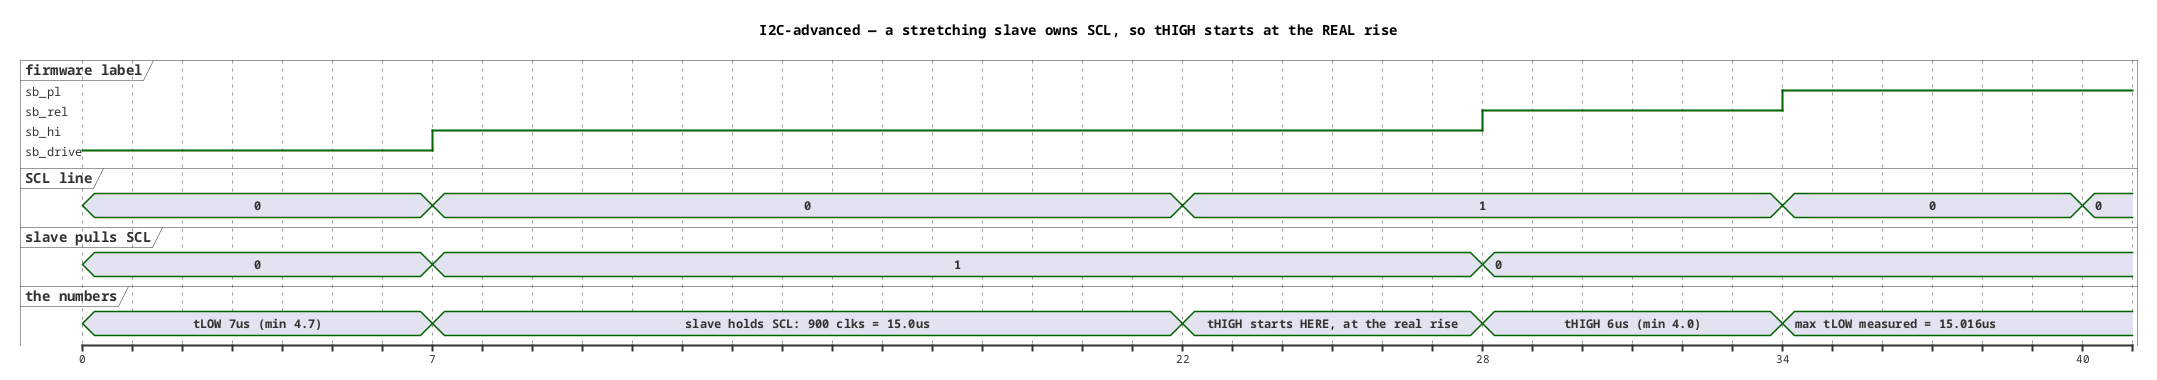
diagrams/proto-i2c-adv_004.png
