smprather/janestreet-blog-serial-protocol-emulator/diagrams/proto-midi.png

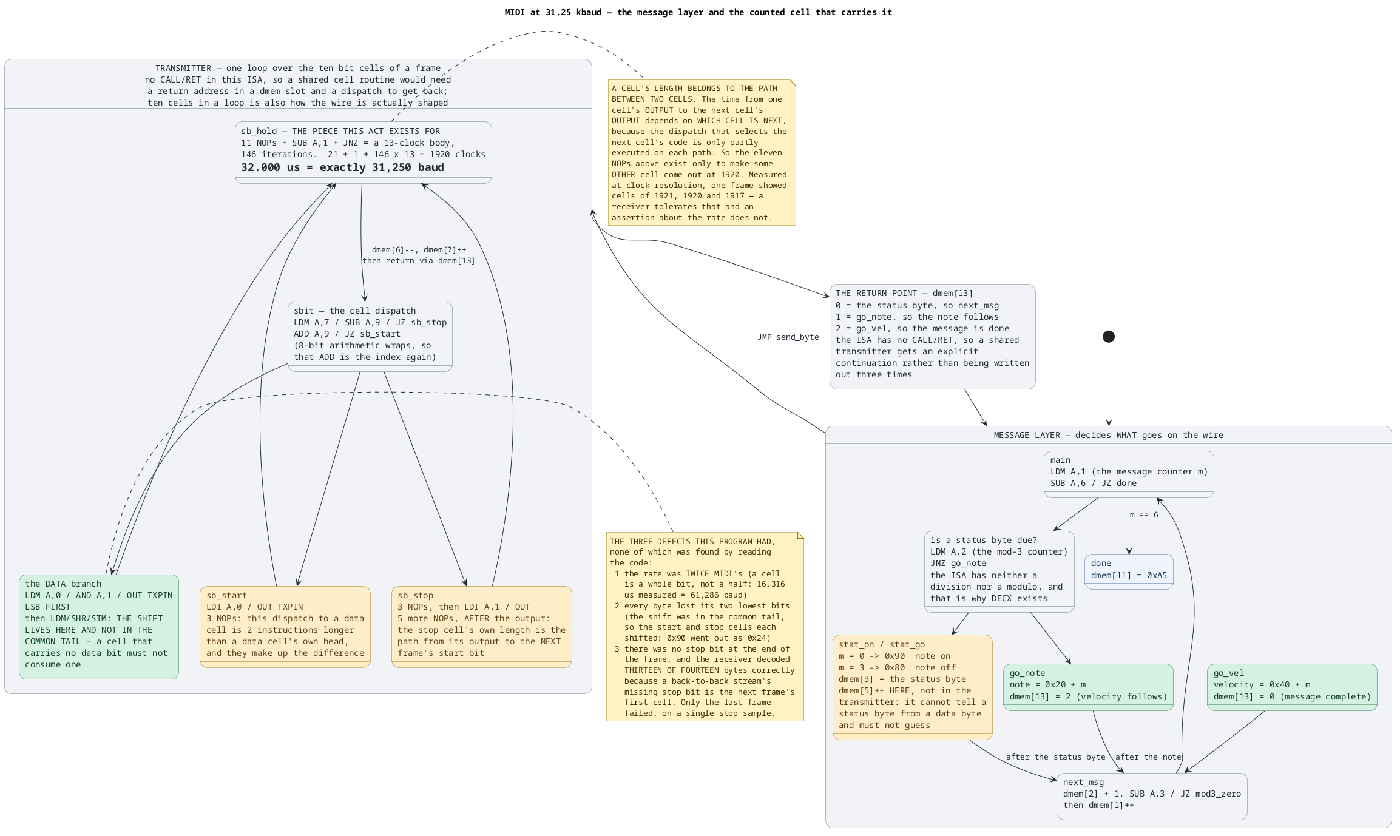
diagrams/proto-midi.png
