smprather/janestreet-blog-serial-protocol-emulator/diagrams/proto-midi_001.png

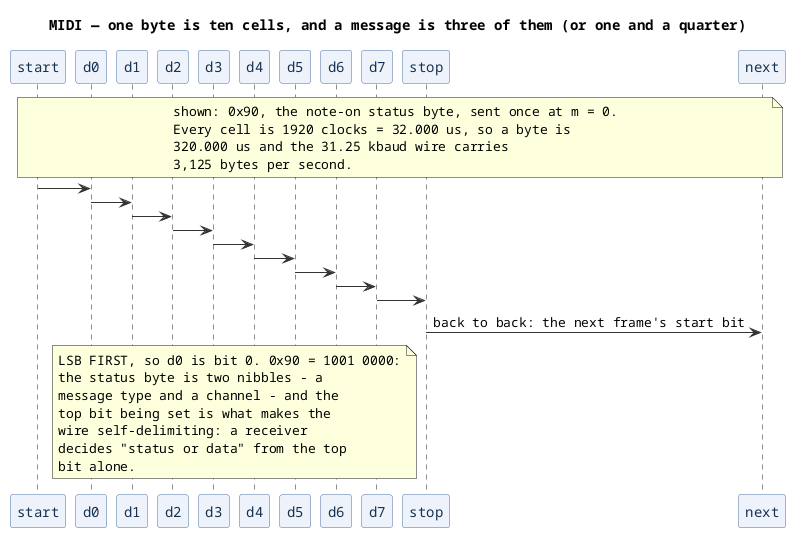
diagrams/proto-midi_001.png
