smprather/janestreet-blog-serial-protocol-emulator/diagrams/proto-midi_002.png

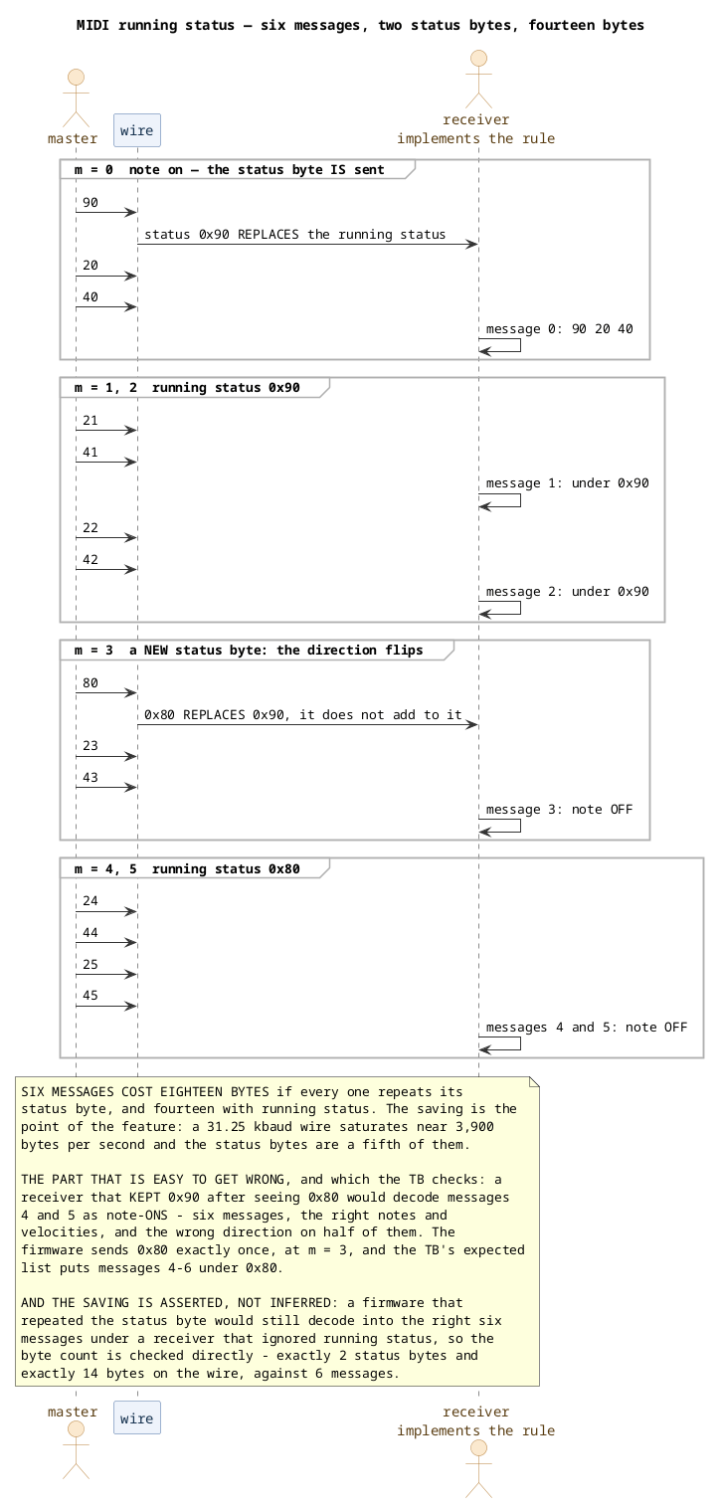
diagrams/proto-midi_002.png
