smprather/janestreet-blog-serial-protocol-emulator/diagrams/proto-midi_003.png

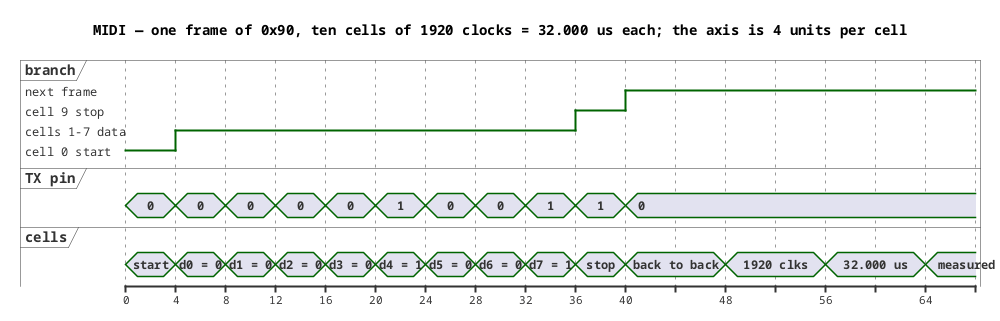
diagrams/proto-midi_003.png
