smprather/janestreet-blog-serial-protocol-emulator/diagrams/proto-midi_004.png

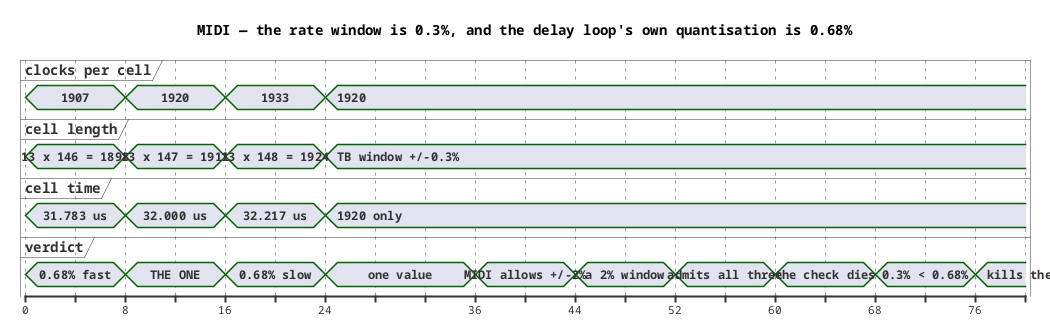
diagrams/proto-midi_004.png
