smprather/janestreet-blog-serial-protocol-emulator/diagrams/proto-nec-ir-frame.png

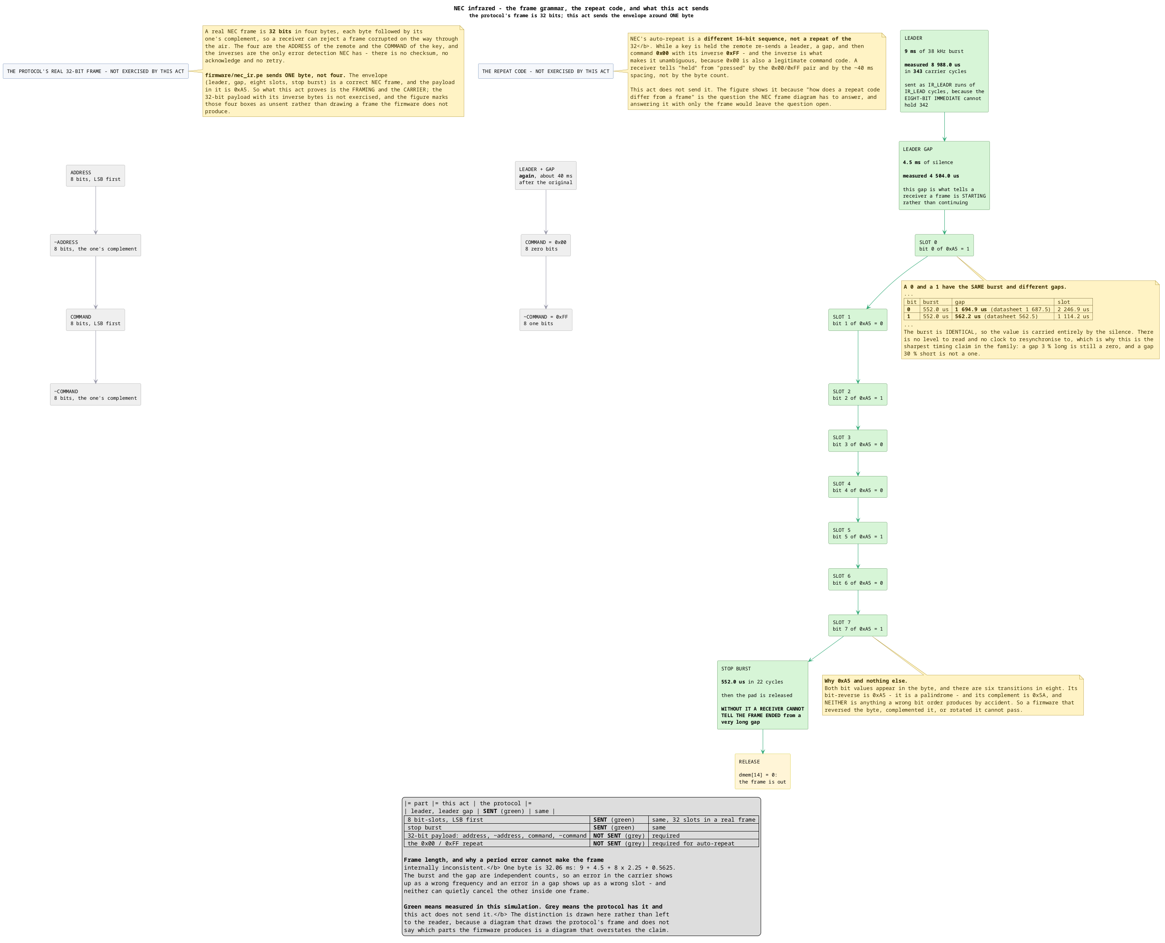
diagrams/proto-nec-ir-frame.png
