smprather/janestreet-blog-serial-protocol-emulator/diagrams/proto-nec-ir-timing.png

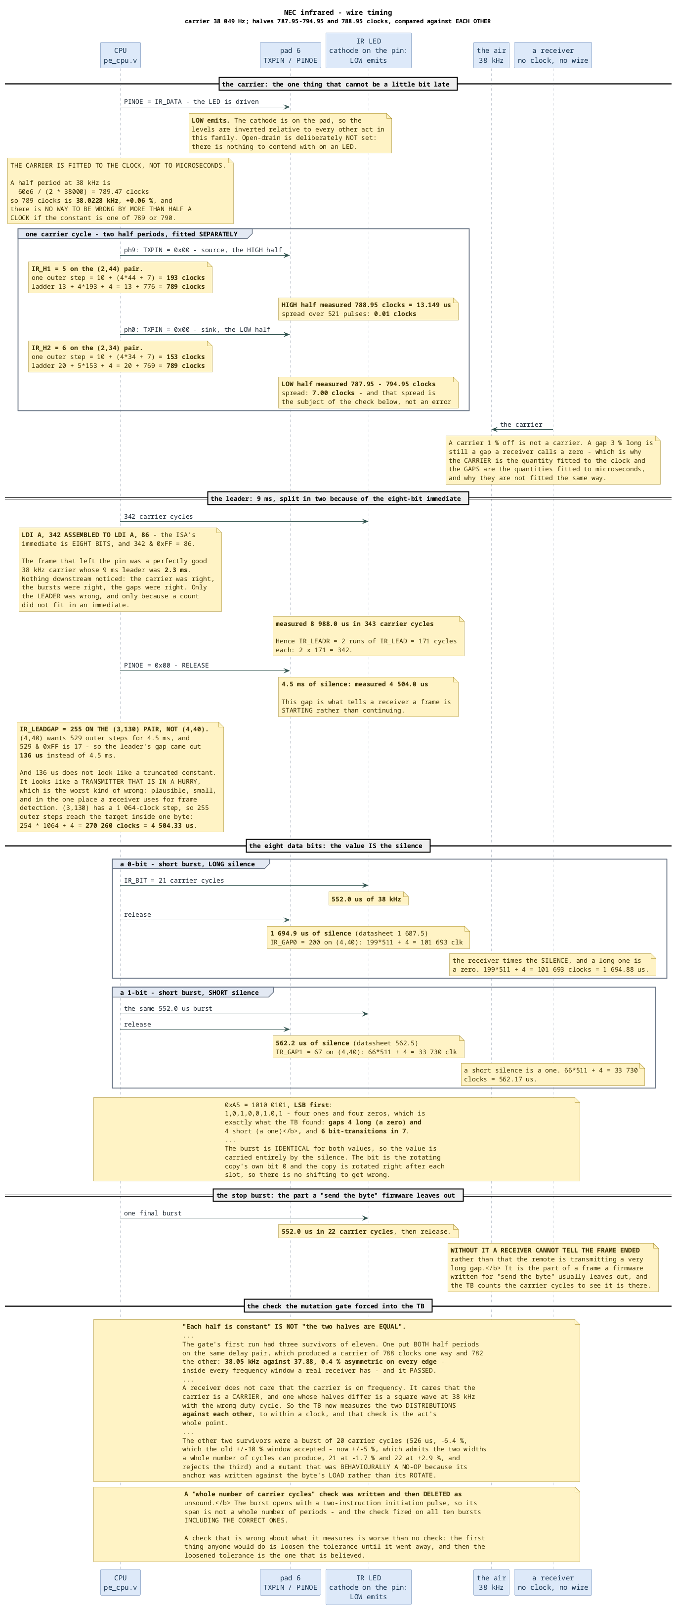
diagrams/proto-nec-ir-timing.png
