smprather/janestreet-blog-serial-protocol-emulator/diagrams/proto-nec-ir.png

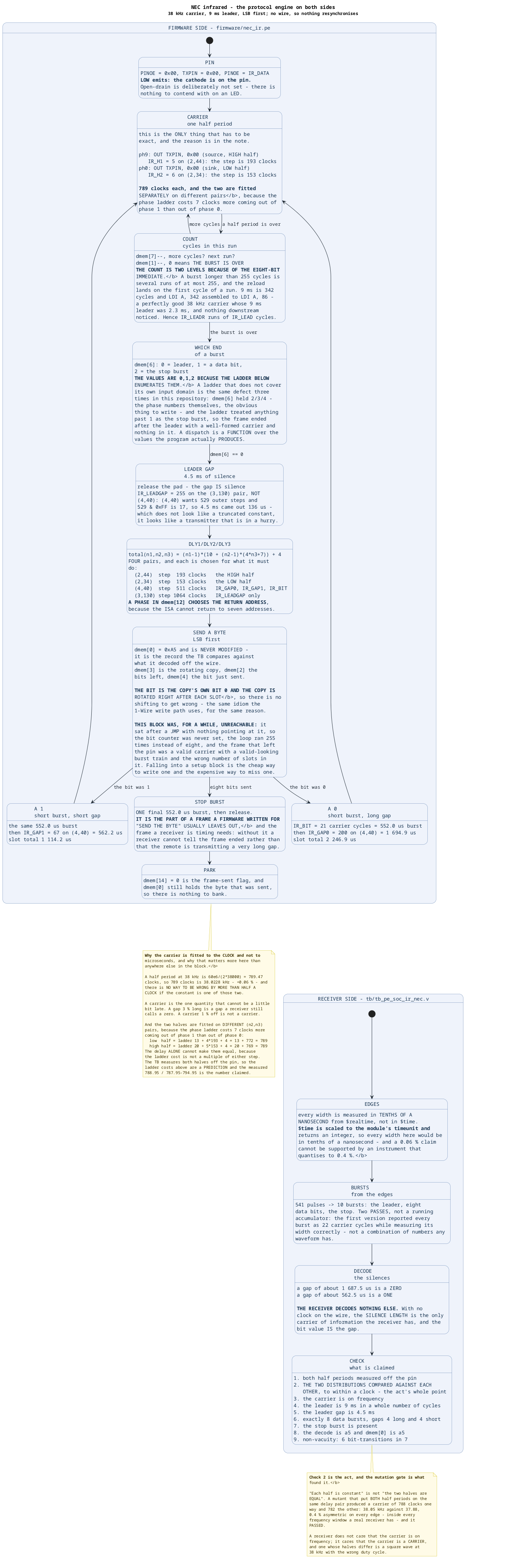
diagrams/proto-nec-ir.png
