smprather/janestreet-blog-serial-protocol-emulator/diagrams/proto-servo-frame.png

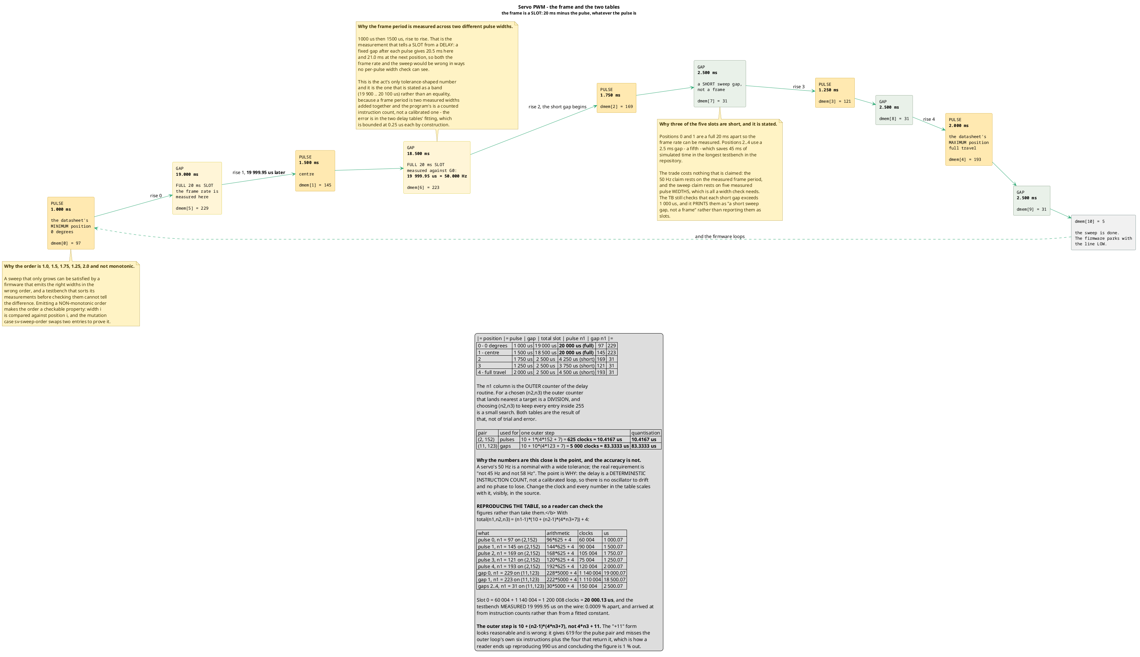
diagrams/proto-servo-frame.png
