smprather/janestreet-blog-serial-protocol-emulator/diagrams/proto-servo-timing.png

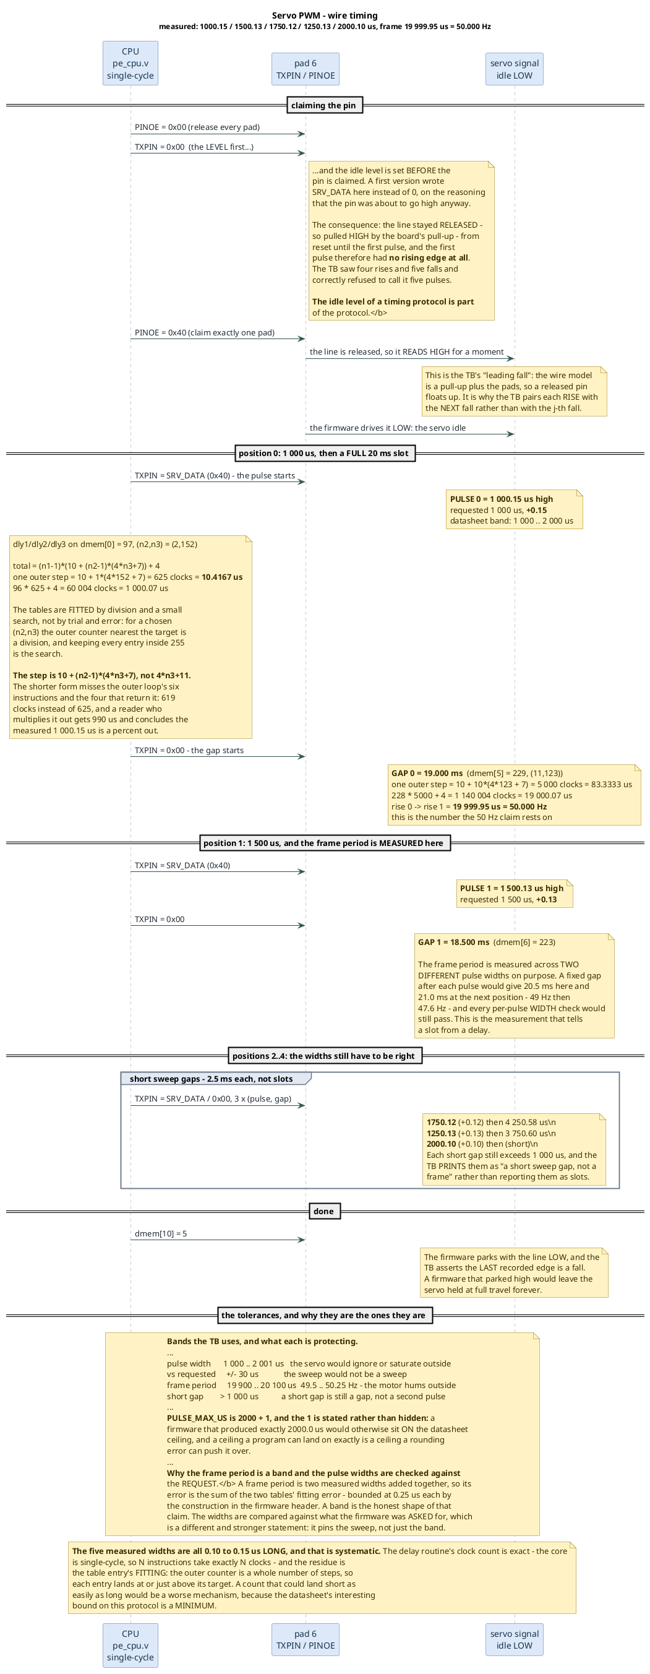
diagrams/proto-servo-timing.png
