smprather/janestreet-blog-serial-protocol-emulator/diagrams/proto-servo.png

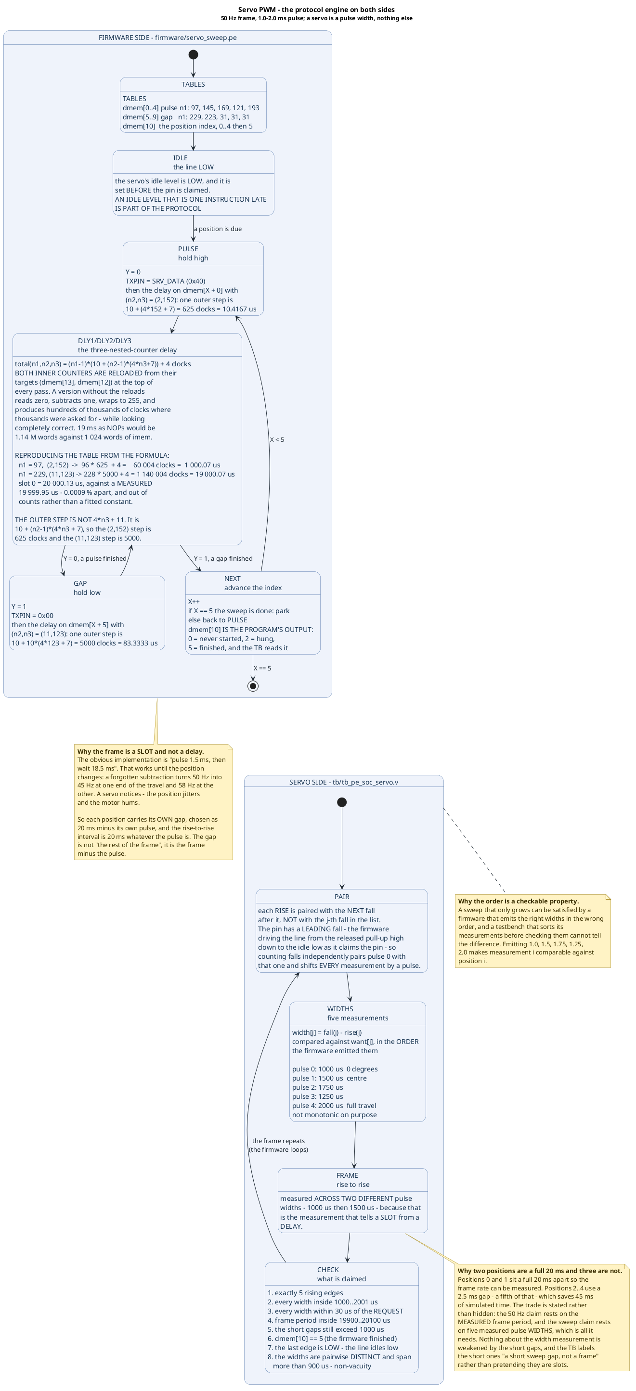
diagrams/proto-servo.png
