smprather/janestreet-blog-serial-protocol-emulator/diagrams/proto-spi3-crc.png

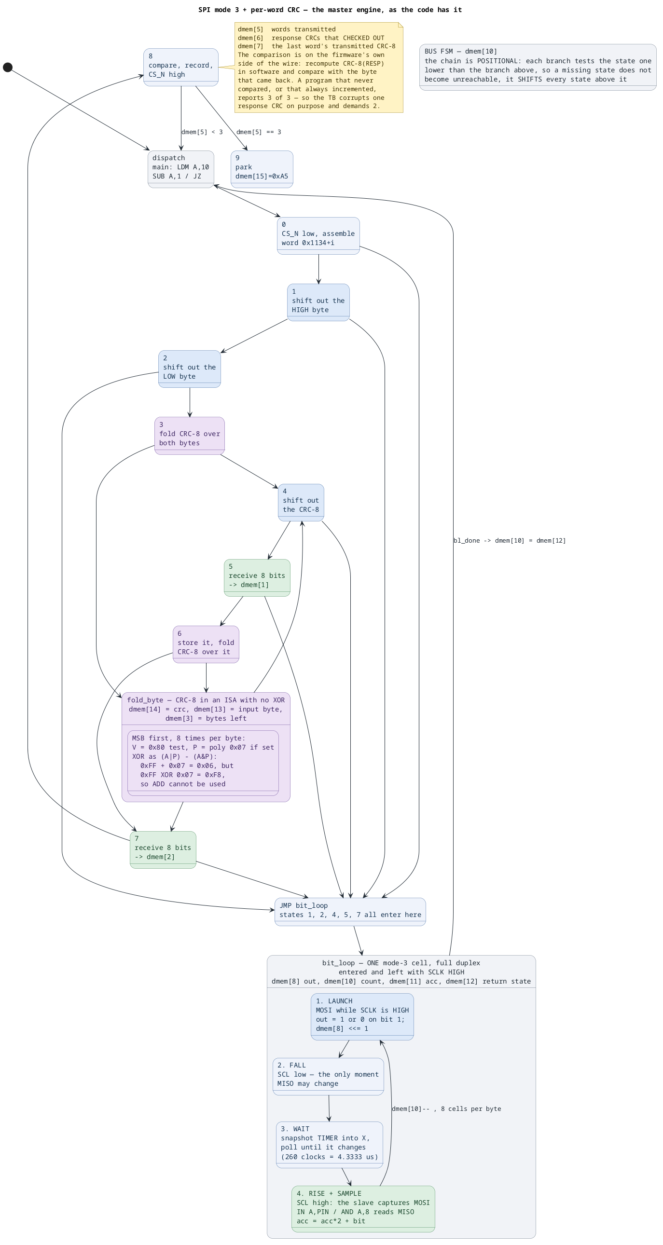
diagrams/proto-spi3-crc.png
