smprather/janestreet-blog-serial-protocol-emulator/diagrams/proto-spi3-crc_001.png

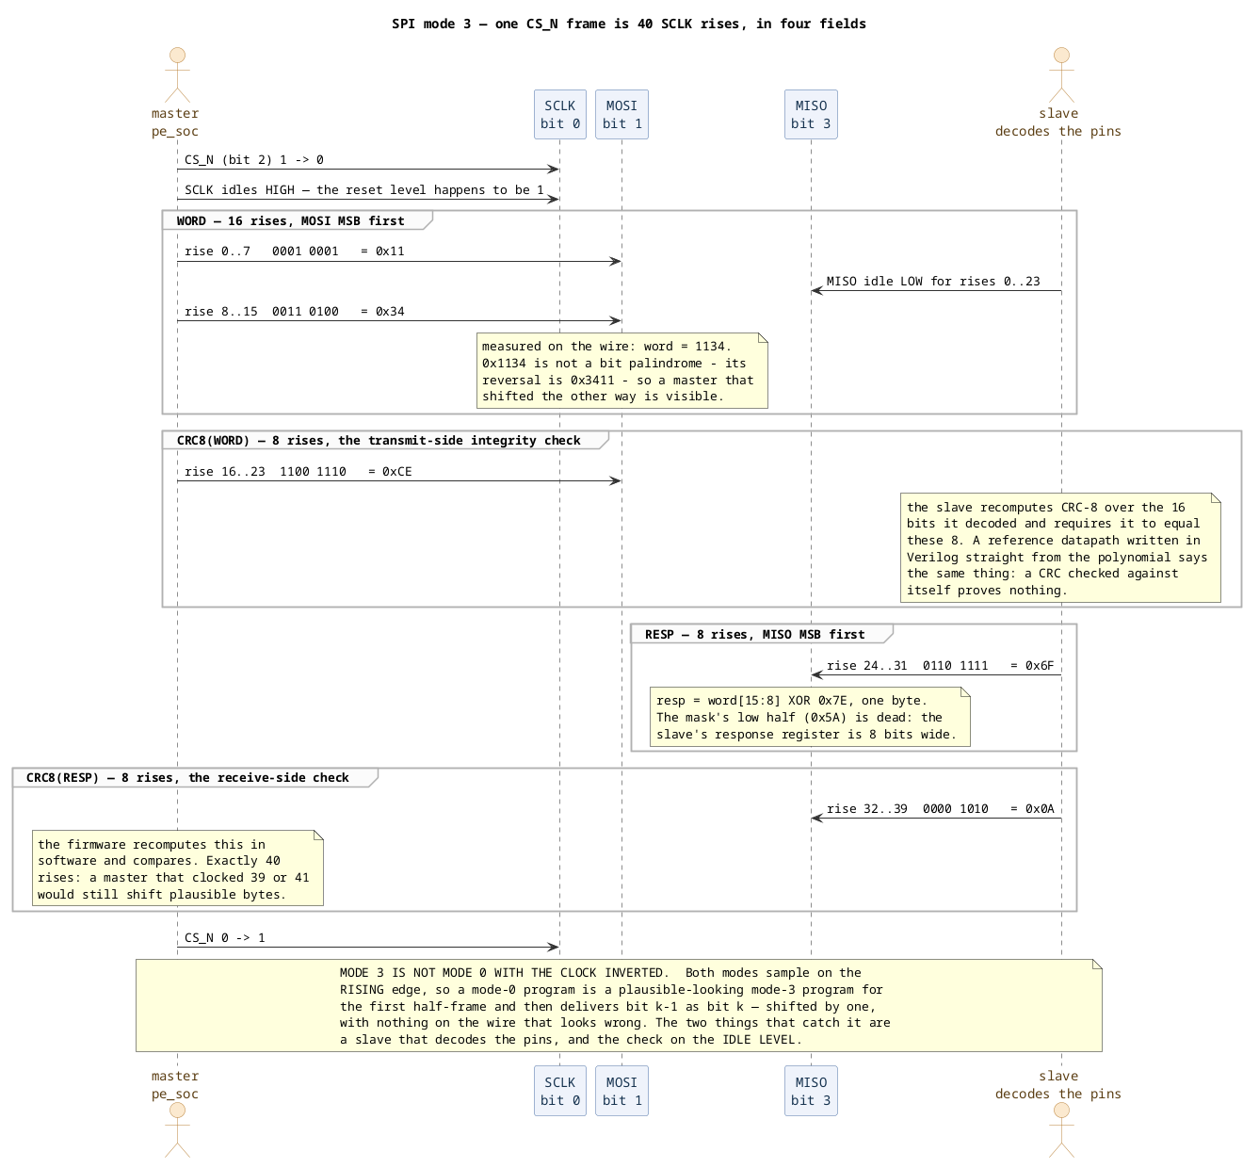
diagrams/proto-spi3-crc_001.png
