smprather/janestreet-blog-serial-protocol-emulator/diagrams/proto-spi3-crc_004.png

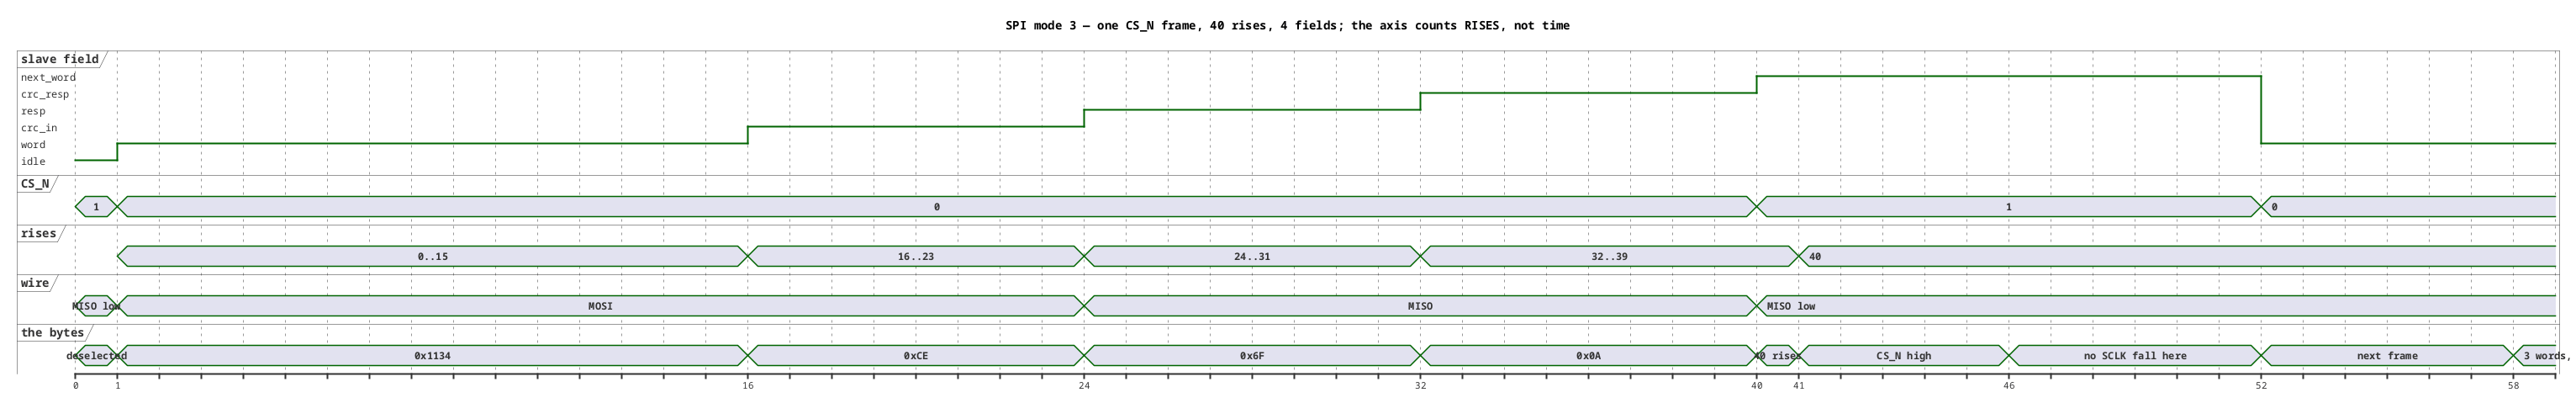
diagrams/proto-spi3-crc_004.png
