smprather/janestreet-blog-serial-protocol-emulator/diagrams/proto-sr04-frame.png

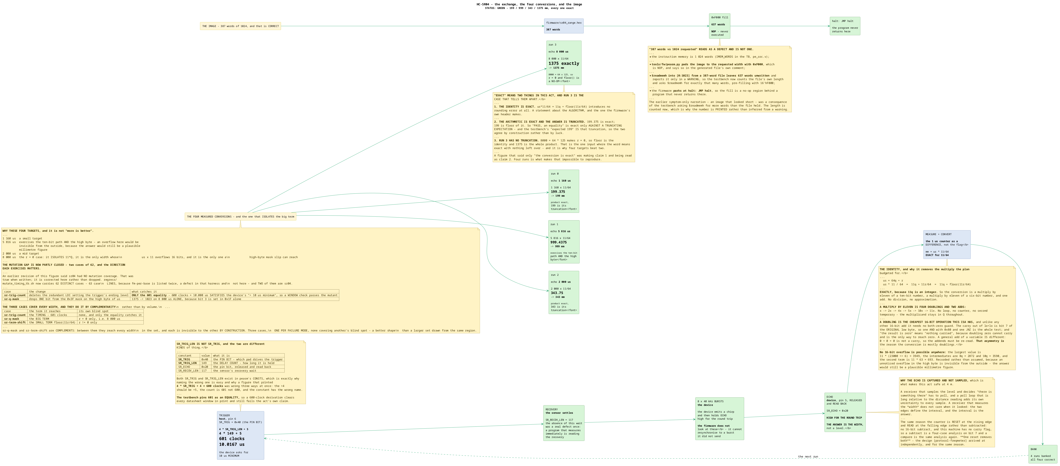
diagrams/proto-sr04-frame.png
