smprather/janestreet-blog-serial-protocol-emulator/diagrams/proto-sr04-timing.png

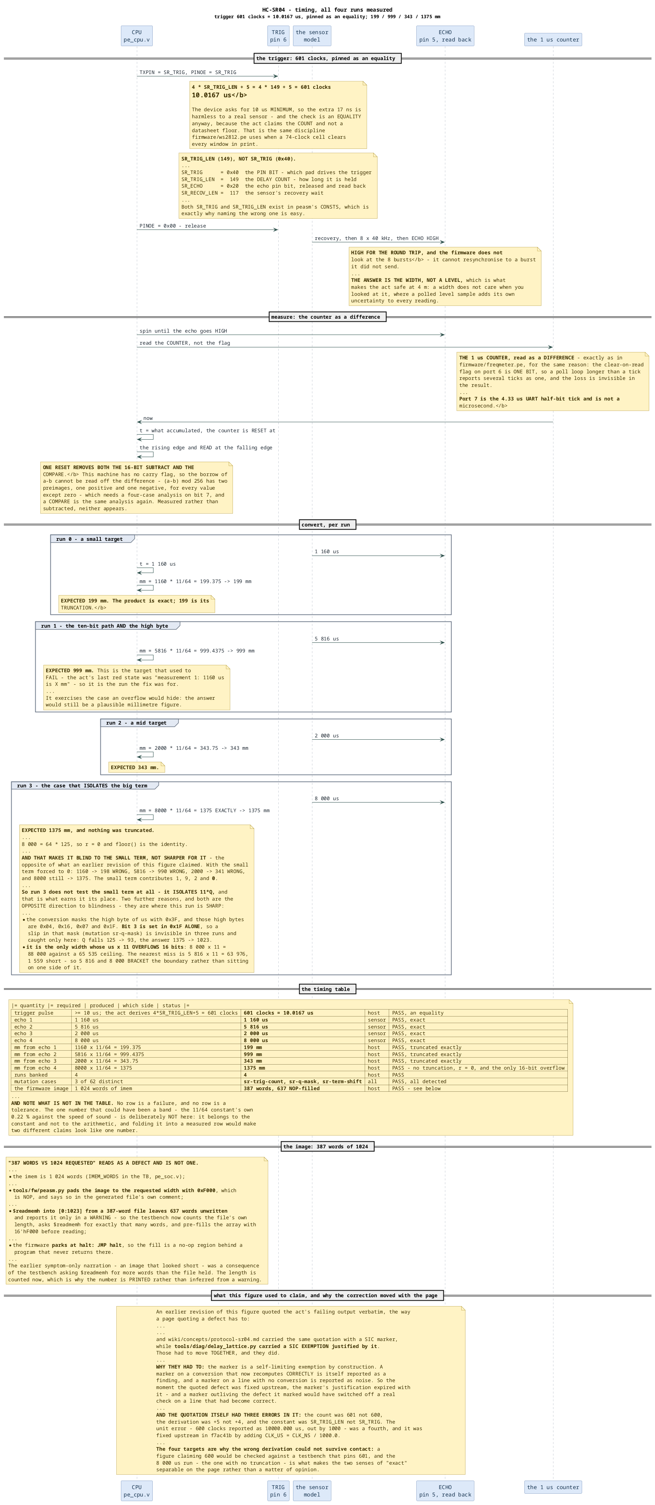
diagrams/proto-sr04-timing.png
