smprather/janestreet-blog-serial-protocol-emulator/diagrams/proto-sr04.png

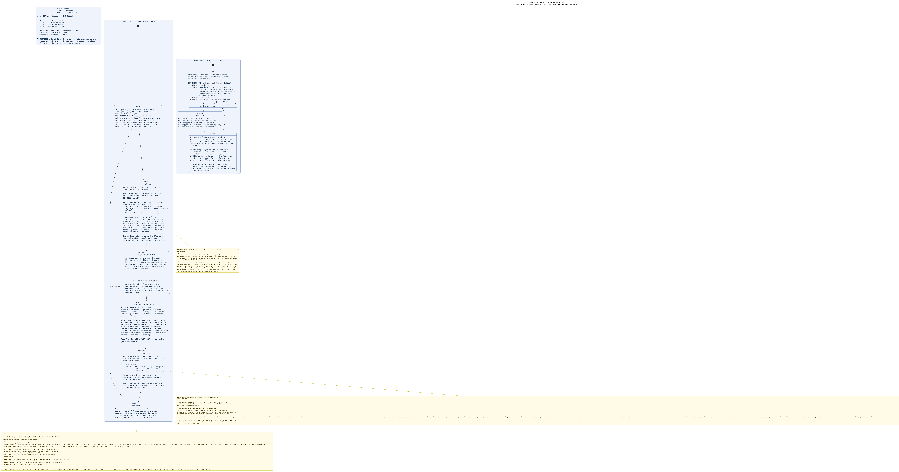
diagrams/proto-sr04.png
