smprather/janestreet-blog-serial-protocol-emulator/diagrams/proto-uart-flow.png

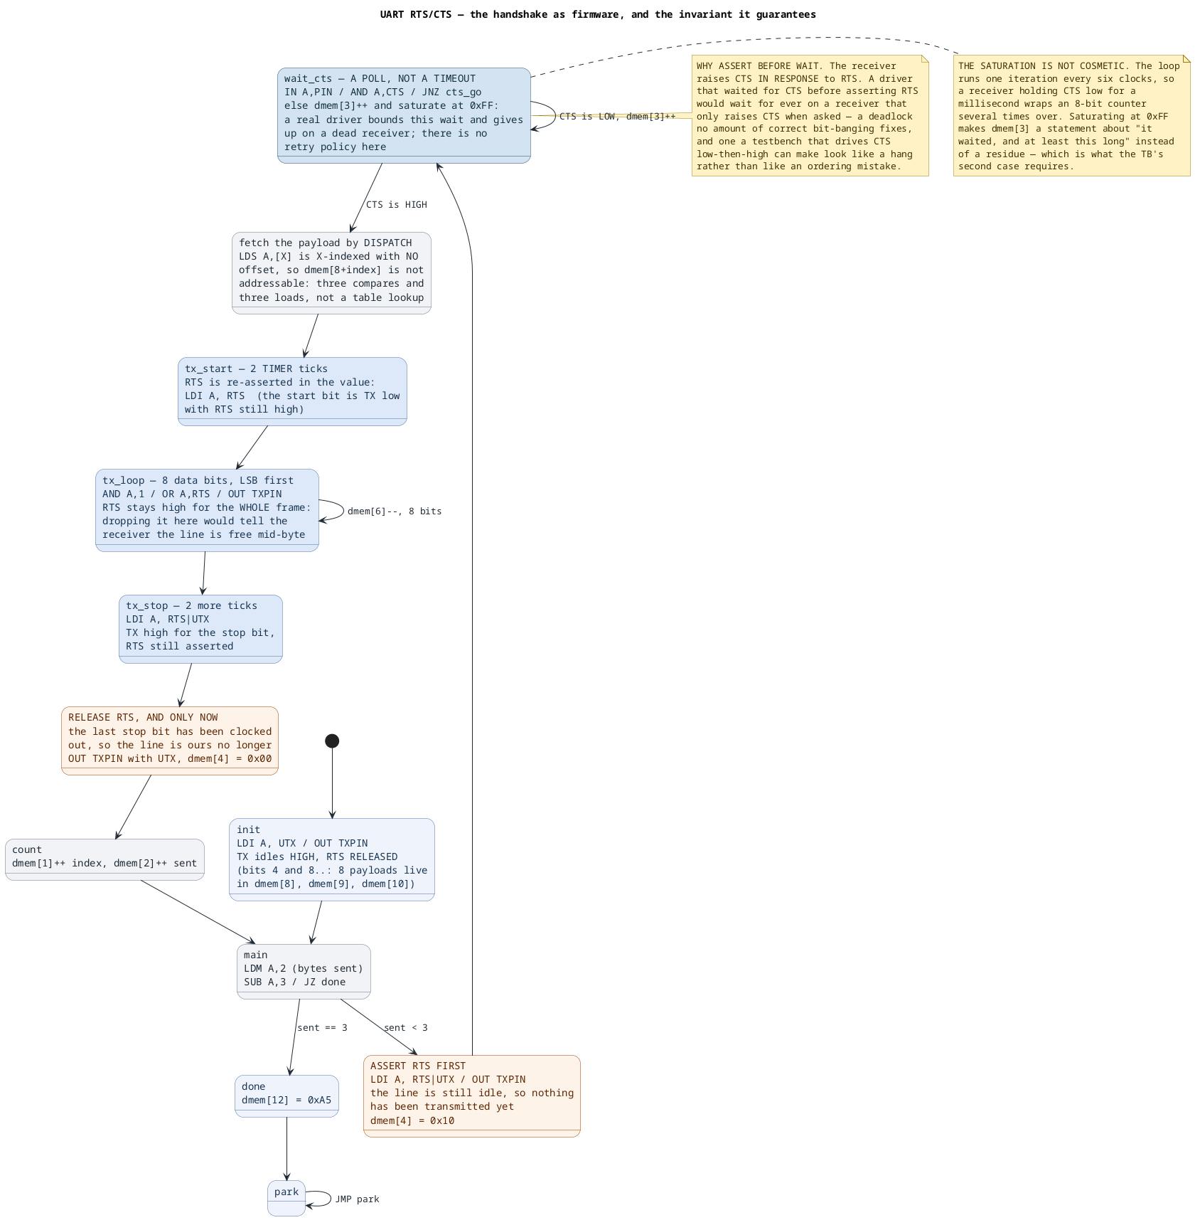
diagrams/proto-uart-flow.png
