smprather/janestreet-blog-serial-protocol-emulator/diagrams/proto-uart-flow_001.png

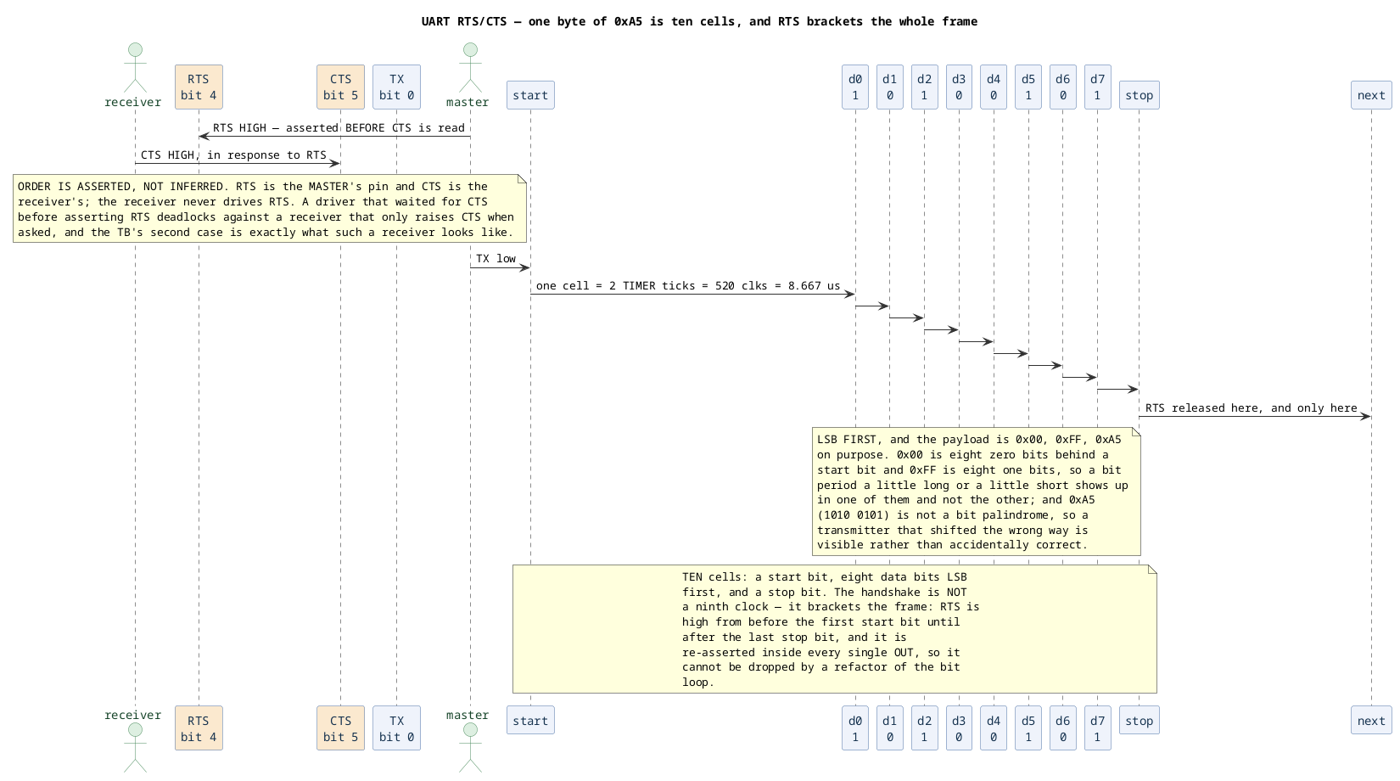
diagrams/proto-uart-flow_001.png
