smprather/janestreet-blog-serial-protocol-emulator/diagrams/proto-uart-flow_002.png

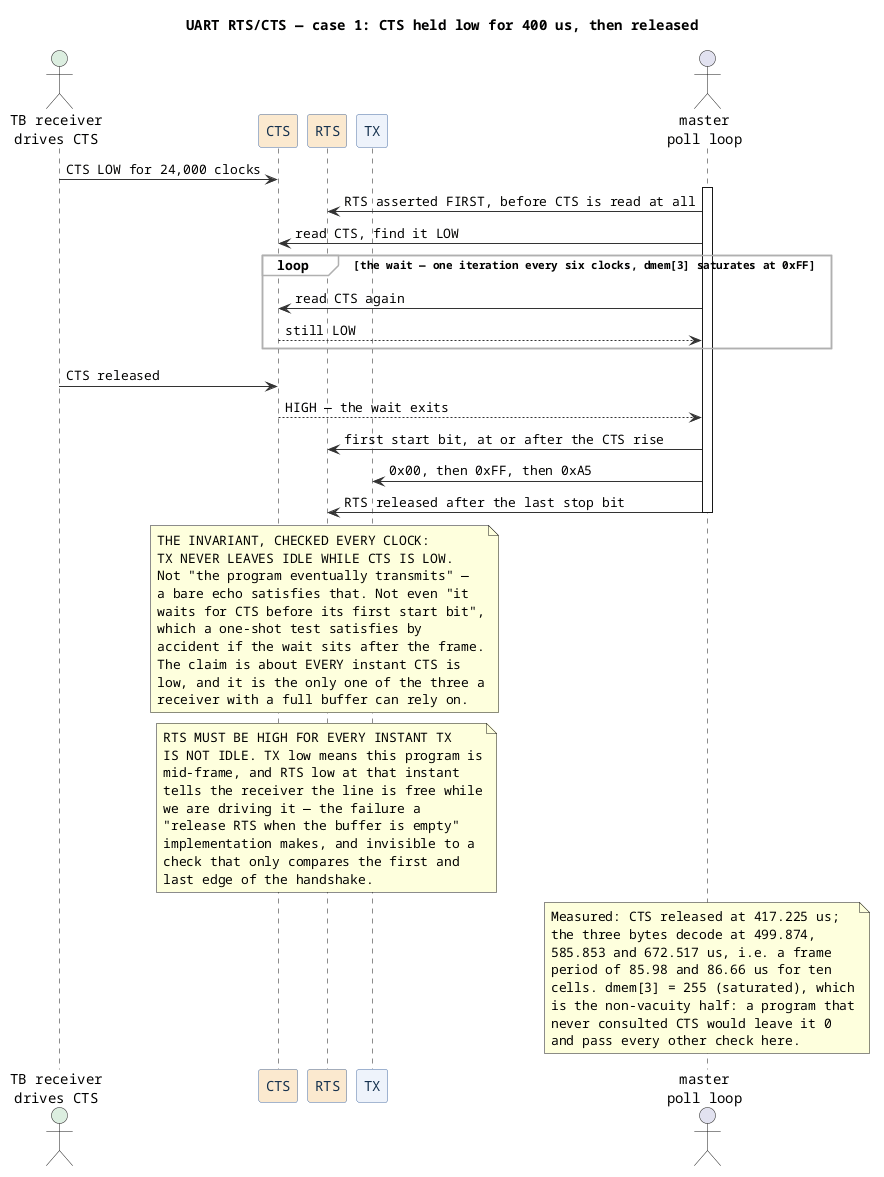
diagrams/proto-uart-flow_002.png
