smprather/janestreet-blog-serial-protocol-emulator/diagrams/proto-uart-flow_003.png

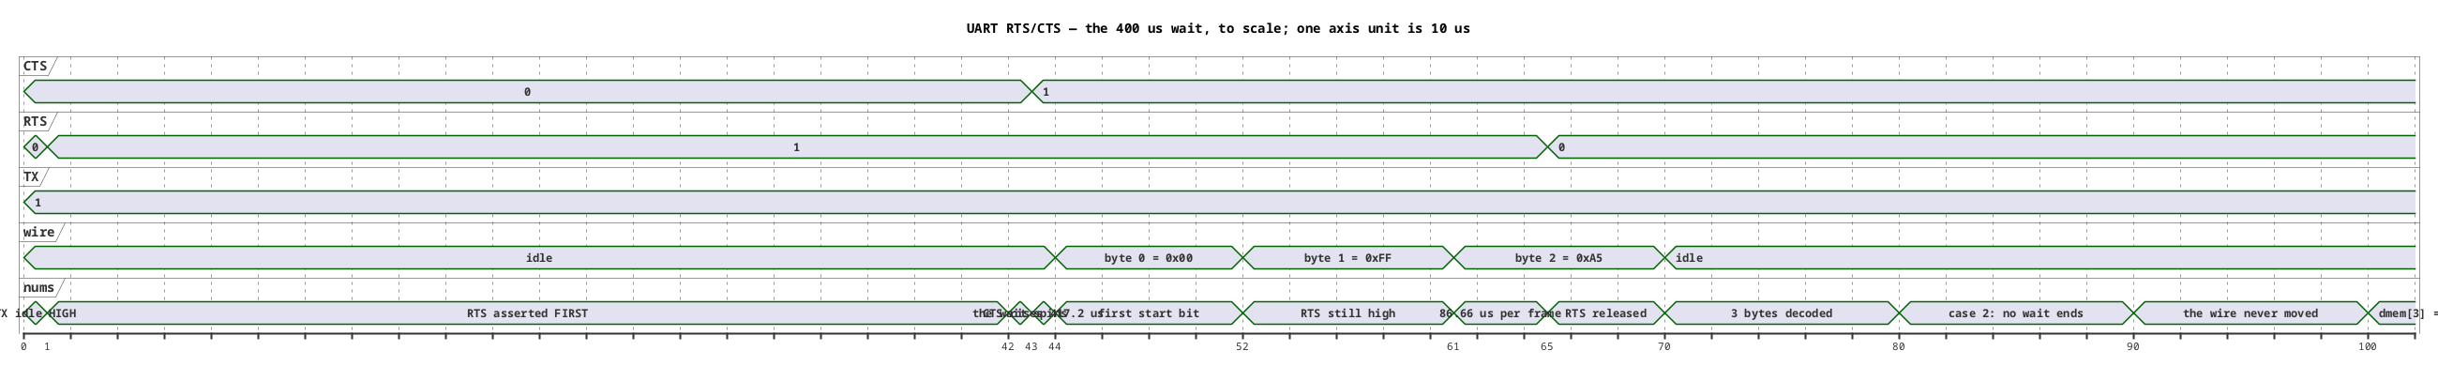
diagrams/proto-uart-flow_003.png
