smprather/janestreet-blog-serial-protocol-emulator/diagrams/proto-uart-flow_004.png

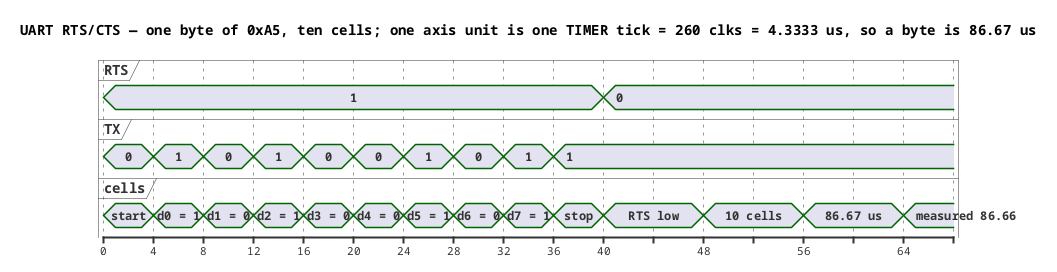
diagrams/proto-uart-flow_004.png
