smprather/janestreet-blog-serial-protocol-emulator/diagrams/proto-ws2812-frame.png

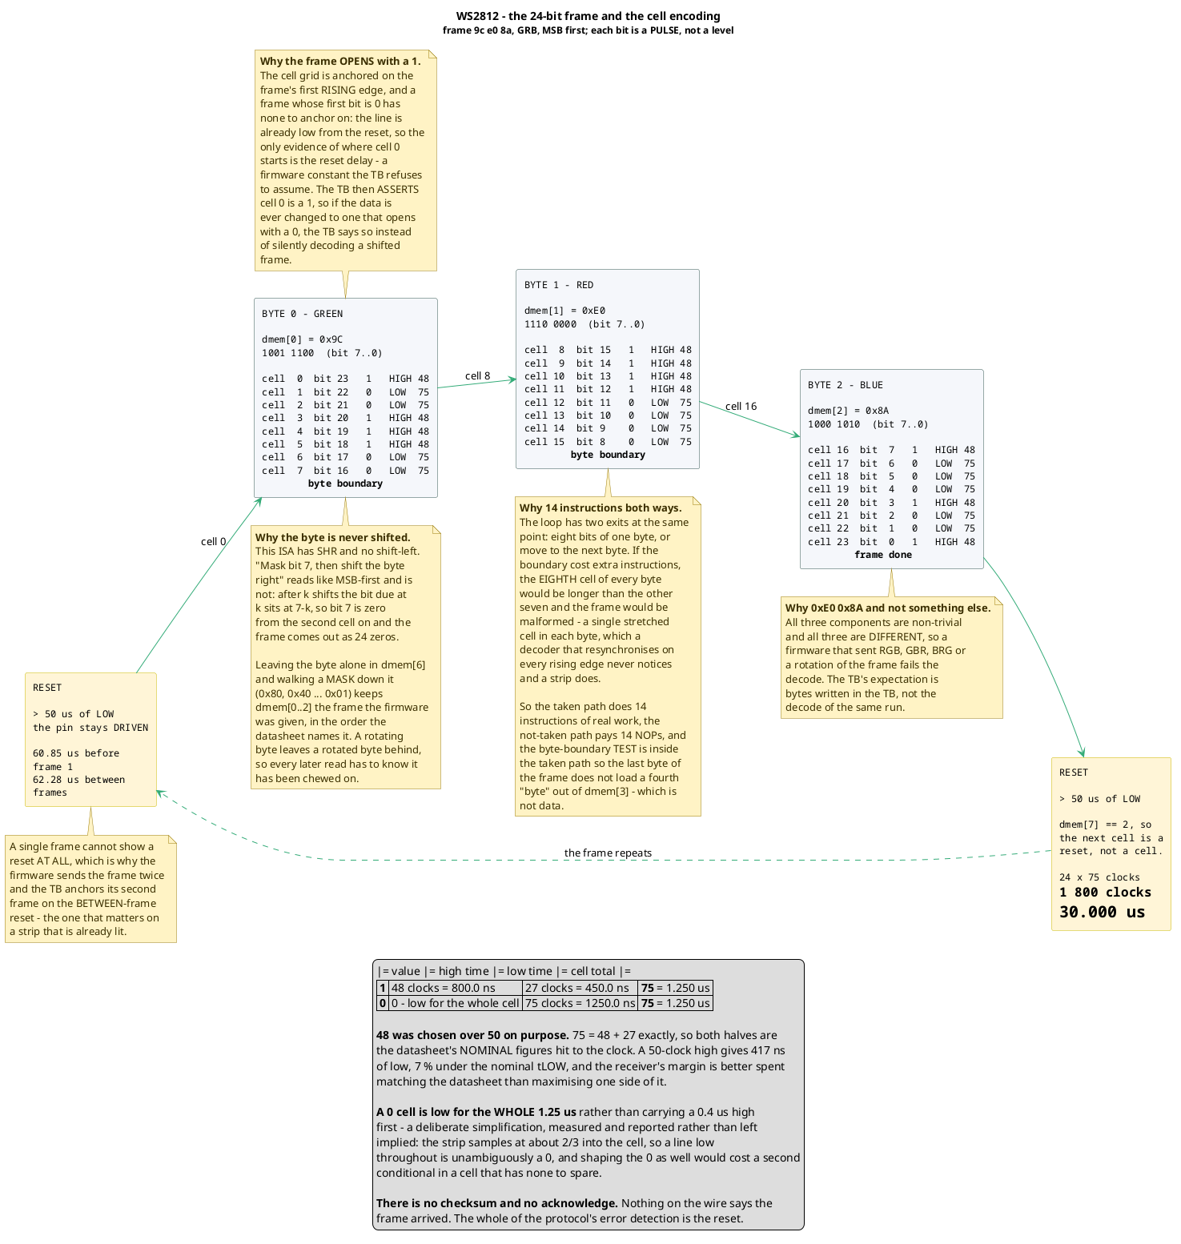
diagrams/proto-ws2812-frame.png
