smprather/janestreet-blog-serial-protocol-emulator/diagrams/proto-ws2812-timing.png

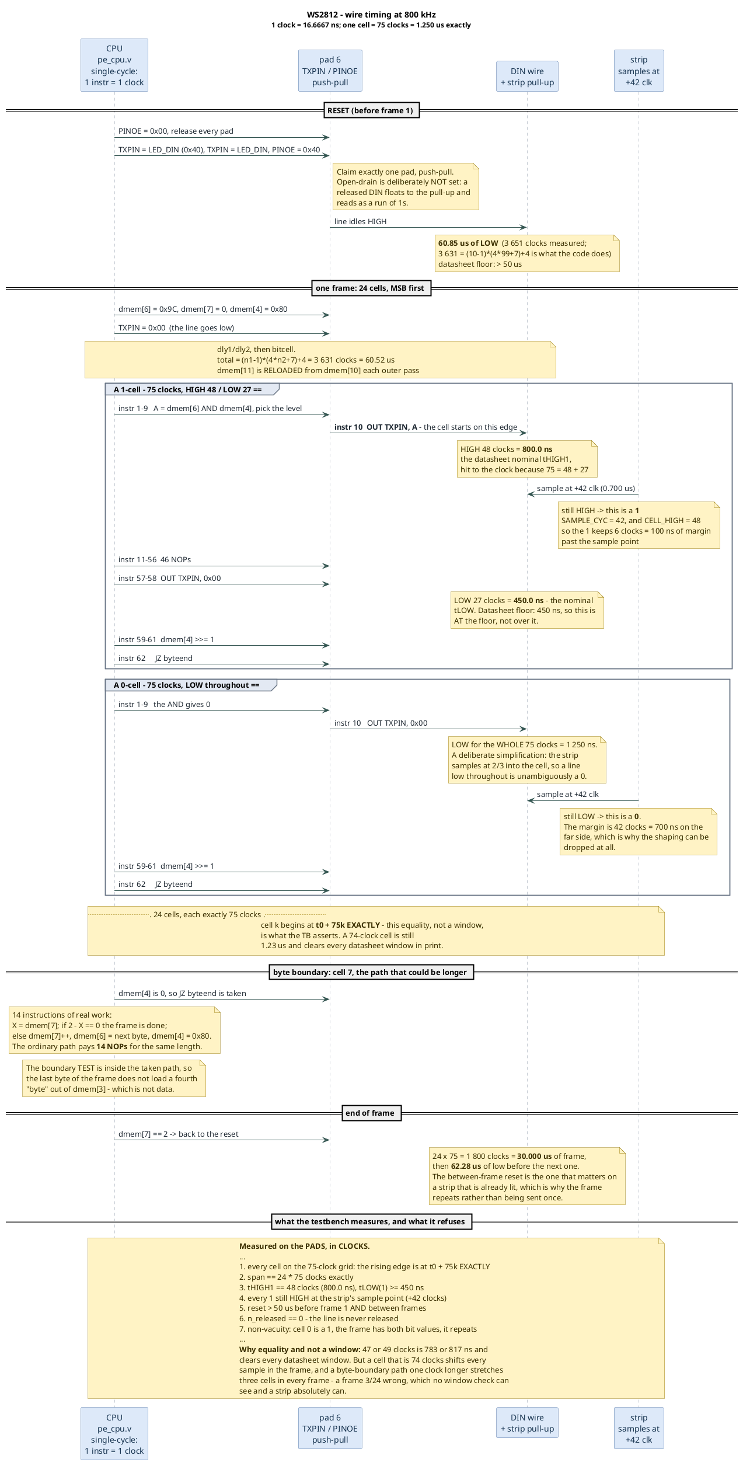
diagrams/proto-ws2812-timing.png
