smprather/janestreet-blog-serial-protocol-emulator/diagrams/proto-ws2812.png

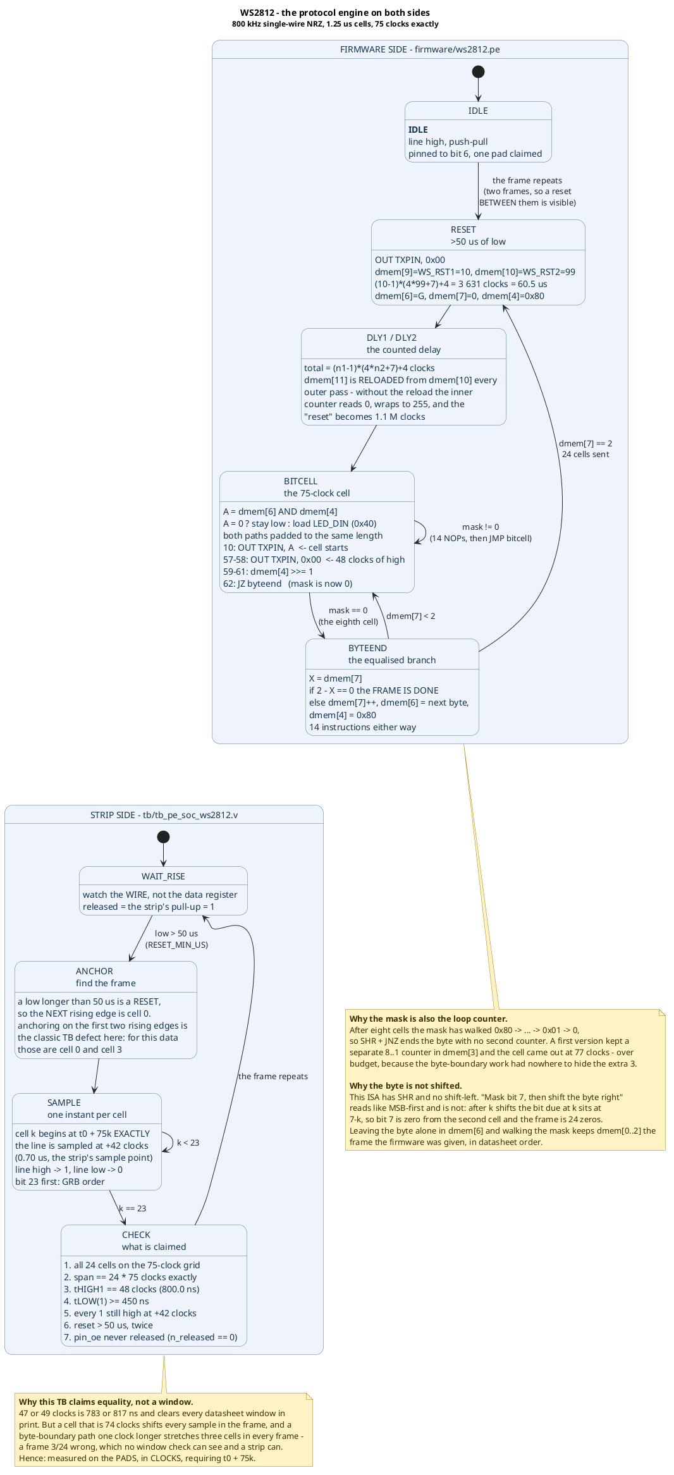
diagrams/proto-ws2812.png
