smprather/janestreet-blog-serial-protocol-emulator/reviews/2026-09-25/R2-READ-VERIFICATION.md

# R2 read-path verification package (host contract; chip-confirmed in simulation)

This is the **R2 acceptance spec** for the chip side, handed over by the
gui-worker so the protocol worker can wire `tb_pe_host.v` (and the R2 RTL in
`pe_ctrl.v` / `pe_soc.v` / `pe_imem.v` / `pe_cpu.v`) against exact golden
values instead of re-deriving the contract.

- **`R2-READ-VERIFICATION.json`** — the vectors. Every step carries the exact
  framed request bytes (`request_hex`), the request payload words, the response
  bytes (`response_hex`), the response payload words, the status code, and the
  model's fault bits after the step.
- **`r2-hex/`** — the **$readmemh export** for Verilog testbenches: 44 `.hex`
  files (one request + one response per golden step, one byte per line so
  `$readmemh` fills an 8-bit array from address 0 in wire order — 22 steps × 2,
  plus `imem.hex`/`dmem.hex`) plus `manifest.json`
  (vector → step → files → expected status, response payload words, sticky
  fault register) and a short `README.md`. The chip TBs consume these directly
  — no translation step — and `--check` proves every hex file is byte-identical
  to the JSON frame it came from.
- Regenerate / drift-check:
  `python3 -m tools.host_gui.r2_vectors --write`, `--hex` and `--check`.
  The checked-in JSON and the hex export must match a fresh build (tests
  enforce this), so the artifacts can never silently disagree with the host
  model.

## Status: chip-confirmed in simulation (2026-09-25)

**The 18 R2 read-path steps are complete, and their bytes are unchanged.** All
18 carry `"chip_confirmed": true` together with a `chip_evidence` citation.
The evidence
is the chip repo's `tb/tb_pe_ctrl_r2.v`, which reports per-vector PASS for all
18 steps — byte-exact including CRC, with the model image loaded per vector
and the session's opening 3-word LOAD replayed as a real framed frame. The
chip-side record is `reviews/2026-09-25/R2-READ-PATH-REVIEW.md` (section
"Conformance"), which names every step. That run also found
and fixed three real RTL defects (a dropped trailing dmem byte, a response
launch that never fired, and an X on the MISO pad before the first frame).

**The four held-core steps are now confirmed too.** R3's
debug work gave the chip two more ways to be stopped, and R2's `STATUS` carries
the same 2-bit state word — so states 2 (`DEBUG_HOLD`, a step-pause) and 3
(`BP_HIT`, a live hit) are reachable, and nothing in this package exercised
either. A chip right on the boot stop and the free-running core, and wrong on
both held states, passed 18/18. The `status_while_step_paused` and
`status_while_bp_hit` vectors close that gap. Their expectations are read off
the frozen contract (the `dbg_state` encoding, `run` being the strap rather
than the state, and `DUMP_CORE` being gated on the strap), they ship
`chip_confirmed: false`, and their per-step bytes, the exact pre-states and the
steps a chip has to take to confirm them are in
**`R2-HELD-STATUS-BYTES.md`**. The package-level `chip_confirmed` is therefore `true`: 22 of 22, and the notice
is GENERATED from those numbers rather than written beside them, because a notice that
claimed the whole package was the F1 defect the R3 review found in the R3
package.

What is **not** claimed: the real-board acceptance run — a Pico over USB CDC
with a physical shuttle — has not been executed. The host probes in
`r2_reads.py` still run against the `FakePE` model; what the chip confirms is
that the RTL matches these same expectations.

## Manager RULINGs encoded (2026-09-25)

1. **An out-of-range READ answers `RANGE` (3) _and_ latches sticky
   `FAULT_RANGE` (0x4).** `CLEAR_FAULT` with mask `0x4` clears it. See the
   `read_range_fault_lifecycle` vector: `bad_read_answers_range` →
   `status_shows_sticky_fault` (faults=`0x0004`) → `clear_fault_clears_the_bit`
   (faults=`0x0000`).
2. **READ payload is low-word-first, ascending**, matching LOAD's stream:
   `READ_IMEM(1, 2)` returns `status, 0x1001, 0x4002` in that order;
   `READ_DMEM(0, 4)` returns `status, 0x0A0B, 0x0C0D` (bytes packed
   big-endian per word).
3. **The R2 readback reports the debug state, and the run word is the strap.**
   The `state` word is `dbg_hold ? (bp_hit ? 3 : 2) : (run ? 1 : 0)`, a hit
   holds the core without dropping the strap (so state 3 arrives with
   `run=1`), and `DUMP_CORE` is gated on the raw run strap. The two held
   vectors encode exactly this; see `R2-HELD-STATUS-BYTES.md`.

## Wire contract the frames assume

- 16-bit words, MSB-first on the wire, `CS_N` low for a frame; sync `16'hA55A`;
  header `{version[3:0]=1, opcode[7:0], target[3:0]=0}`; sequence; 16-bit
  payload length; CRC-16/CCITT-FALSE (poly `0x1021`, init `0xFFFF`, no
  reflection, no final XOR) over all preceding words.
- Responses set bit 7 of the opcode, echo the sequence and target, and carry the
  status as the first payload word: `0=OK, 1=BUSY, 2=BAD_FRAME, 3=RANGE,
  4=FAULT, 5=UNSUPPORTED, 6=NOT_READY`.
- Memory sizes: IMEM 1024 words, DMEM 16 bytes. Past-the-end reads are `RANGE`,
  never wrapped (the `range_never_wraps` vector: `READ_IMEM(1023,1)` reads the
  last word; `READ_IMEM(1023,2)` and `READ_DMEM(15,2)` are `RANGE`).

## The model image the vectors assume (manager ruling, 2026-09-25)

Without the memory contents, a data-path read proves only the **framing**,
not the data. The package therefore ships the exact model image for every
vector, and every step names the image it assumes:

- `model_images[<id>].imem` — 1024 words: a sparse `{address: word}` map plus
  a `fill` default (the demo image holds `0x0041, 0x1001, 0x4002` at words
  0-2 and zero elsewhere).
- `model_images[<id>].dmem` — 16 bytes, same sparse-map shape.
- `model_images[<id>].state` — the architectural register/timer state the
  STATUS and DUMP_CORE vectors assume: `pc, a, x, y, insn, timer, run, faults,
  words_written, selected_target`.
- Each step carries `model_image_id` pointing at its image.

The images come from the same `build_package()` that produces the frames, and
`load_model_from_image()` is its exact inverse, so a test can rebuild the
model from the shipped image and replay a vector to get the shipped bytes
back. A test does exactly that (steps replayed **in order**, because the
lifecycle vector's first step latches the fault its second step observes).

### Loading it in a Verilog testbench

`r2-hex/` ships the full images as `$readmemh` files:

```verilog
initial begin
  $readmemh("imem.hex", imem);   // logic [15:0] imem [0:1023]
  $readmemh("dmem.hex", dmem);   // logic [7:0]  dmem [0:15]
end
```

`imem.hex` is one 16-bit word per line in ascending address order; `dmem.hex`
is one byte per line. Preload the registers from `model_images[].state` in
`manifest.json` for the vector under test, then drive the step's
`request_file` and compare the response against `response_file`.

## Register widths (ISA is the source of truth)

Manager ruling (2026-09-25): **the ISA is the source of truth and no field may
lie.** These widths mirror `rtl/pe_cpu.v`:

| Field | Width | RTL evidence |
|---|---|---|
| `pc` | **10 bits** | `logic [PCW-1:0] pc;` with `PCW = max(8, IAW)`; the SoC instantiates `IMEM_WORDS=1024` so `IAW=10` |
| `a`, `x`, `y` | **8 bits** | `logic [7:0] a, y, x;` |
| `insn` | **16 bits** | the instruction word is `logic [15:0]` (`imem_rdata`) |

"Full width" in the R2 obligation means *every bit the ISA has* — R2 must not
truncate the PC to 8 bits the way the current `dbg_pc = pc[7:0]` does. It does
**not** mean wider than the ISA. The host `FakePE` now masks every register to
these widths so the model can never emit a field the hardware could not hold,
and `tools/host_gui/tests/test_r2_reads.py` pins the constants against the
RTL text itself. (An earlier package encoded `a=0x1FFF`, 13 bits — a field no
chip can produce; it is corrected here.)

## The obligations, in vector form

| Vector | Obligation the chip must satisfy |
|---|---|
| `read_imem_bounded` | `READ_IMEM` returns the requested `address..address+count` words, ascending. |
| `read_dmem_bounded` | `READ_DMEM` returns the requested byte range packed big-endian per word. |
| `dump_core_header` | `DUMP_CORE` while stopped equals the `STATUS` register header. |
| `read_cpu_non_halting` | `READ_CPU` answers while `run=1` and exposes full-width `pc/a/x/y/insn` (R2 removes the 8-bit `dbg_pc`/`dbg_a` truncation). |
| `full_width_debug_regs` | The register header, ISA-native: `pc` 10 bits, `a`/`x`/`y` 8, `insn` 16 (the anti-truncation vector). |
| `read_while_running_rejected` | `READ_IMEM`/`READ_DMEM`/`DUMP_CORE` answer `NOT_READY` (6) while `run=1` (chip-side rejection, not just the Pico). |
| `range_never_wraps` | Past-the-end reads are `RANGE` (3), never wrapped. |
| `read_ceiling_and_zero_count` | A count over `MAX_READ_WORDS=15`, or a zero count, is `RANGE` (3) so the host splits; the model enforces the chip's own ceiling. |
| `read_range_fault_lifecycle` | A bad read latches sticky `FAULT_RANGE`; `STATUS` shows it; `CLEAR_FAULT` clears it. |
| `status_while_step_paused` | `STATUS`/`DUMP_CORE` while the core is held in state 2 (`DEBUG_HOLD`): the state word says so, the run strap is still low, and `DUMP_CORE` still answers the identical header. |
| `status_while_bp_hit` | `STATUS`/`DUMP_CORE` while the core is held in state 3 (`BP_HIT`): the hit holds the **core**, not the strap, so `run` is still 1 — and `DUMP_CORE`, gated on that strap, is `NOT_READY`. |

## How to consume it in a Verilog testbench

Each `steps[].request_hex` is a full frame in hex; feed its bytes to the PE
SPI slave (or capture the Pico's `host_spi_transfer` input) and assert the
returned bytes equal `response_hex` — or assert the decoded
`response_payload_words` word for word. `model_faults` is the expected sticky
fault register after the step, which is how the lifecycle vector pins the
latch/clear behaviour. `opcode_name` gives the plan opcode (e.g. `OP_READ_IMEM`
= `0x13`).

Related records: `HOST-GUI-R2-PREP.md` (the host-side prep this package is
exported from), `R2-HELD-STATUS-BYTES.md` (the four held-core steps, their
bytes, pre-states and confirmation steps for the chip), `R3-VECTOR-BYTES.md`
(the R3 debug package), `wiki/plans/host-controller-gui.md` Tasks 3-5, and
`reviews/2026-09-24/HOST-CONTROLLER-PLAN-REVIEW.md` rows P16/P17.
