smprather/janestreet-blog-serial-protocol-emulator/reviews/2026-09-23/codec-results.txt

INDEPENDENT USB/CAN WIRE MODEL cases=524 cells=4822 errors=0
reviews/2026-09-23/codec_model.v:579: $finish called at 106950000 (1ps)
