smprather/janestreet-blog-serial-protocol-emulator/tb/tb_pe_soc_bmc.v

// tb_pe_soc_bmc.v -- FM0/FM1 bi-phase coding, ENCODE AND DECODE through the
// pins in loopback. RED: there is no firmware yet.
//
// WHAT THIS ACT IS, and why it is not a seventh timing act. Every other act in
// this block is judged on a waveform a receiver can decode. This one is judged
// on a RECEIVER: the code lives in the TRANSITIONS, not in the levels, and the
// only clock in the system is the one the receiver recovers from the data.
// So the claim is not "the firmware drives a bi-phase stream" but "the
// firmware RECOVERS THE CLOCK from a stream it shares no clock with, and says
// which encoding it locked onto".
//
// THE WIRE RULES, from which everything here is written:
//   * a bit is TWO half-intervals;
//   * a '1' has NO transition at the END of its interval, in both encodings;
//   * a '0' HAS a transition at the end, in both encodings;
//   * FM0 adds a transition at the START of the interval for a '1'; FM1 does
//     not -- which is the ONLY difference between the two encodings.
// CONSEQUENCE ONE, and it is the best check in the file: EVERY bit of a
// well-formed frame carries a transition in its middle, because "bi-phase"
// means the level changes WITHIN the interval. So a line held CONSTANT --
// which is what a disconnected, shorted or dead sensor looks like on the
// wire -- has no transitions at all and carries no clock, and a receiver that
// locks on to it has locked on to nothing. THAT is the stream the last check
// presents, and the firmware's answer to it must be a DECLARED FAILURE rather
// than a byte it invented: a decoder that cannot fail is not a decoder.
//
// (THE FIRST VERSION OF THIS FILE CLAIMED THAT A RUN OF ONES IN FM1 WAS THAT
// STREAM. IT IS NOT. A run of ones is a clean square wave -- one transition
// per bit, in the middle -- and the decoder recovers its clock from exactly
// those transitions. The claim was in this header, in the encoder below and in
// two WORKLOG lines, and it was wrong in all four. It was the instrument that
// was wrong, which is the pattern this whole block exists to demonstrate, and
// the reason the act was written with two decoders from the wire rules rather
// than one decoder and one encoder that agree by construction.)
//
// CONSEQUENCE TWO, which is why the bit period is a whole number of
// microseconds: the receiver timestamps the level on the 1 us counter and
// compares it with the level recorded at the last CHANGE, and that comparison
// is only exact if every transition lands on a tick. A bit period that is not
// a multiple of the counter's unit would make the decoder's own arithmetic
// the least accurate thing in the act.
//
// BOTH DIRECTIONS, and NEITHER SIDE IS TOLD WHAT THE OTHER SENT: the
// testbench encodes a byte on IN_PAD and the firmware must recover it; the
// firmware encodes on OUT_PAD and the testbench's decoder, written from the
// same wire rules above rather than from the firmware, must recover it.
//
// THE LIMITS, stated rather than buried: three bytes per direction, because
// the machine has SIXTEEN BYTES of data memory and a receiver's state -- the
// transition timestamp, the previous level, the bit counter, the phase flag and
// the frame being assembled -- is most of that, and a scratch byte for the
// store-forward the ISA cannot express is most of the rest (see
// firmware/../WORKLOG.md, 13:20). One inter-frame gap, and no noise, no
// jitter and no line-length limit: those are the things a real receiver's
// worst case lives in, and pretending otherwise would be claiming a
// robustness this act does not test.

`timescale 1ns / 1ps

`ifndef BMC_HEX
  `define BMC_HEX "../firmware/bmc_frame.hex"
`endif

module tb_pe_soc_bmc;

  localparam int IMEM_WORDS = 1024;
  localparam int IAW = $clog2(IMEM_WORDS);
  localparam int DMEM_BYTES = 16;
  localparam int BAUD = 115_200;
  localparam real CLK_NS = 1e9 / 60_000_000;

  localparam int IN_BIT  = 5;        // the testbench drives this one
  localparam int OUT_BIT = 6;        // the firmware drives this one
  // THE HALF-INTERVAL IS COUNTED IN CLOCKS, AND THE MICROSECOND FIGURE IS
  // DERIVED FROM IT. This was declared as 2 and commented "in whole
  // microseconds", and then compared against a counter that increments once
  // per CLOCK -- so the stimulus drove a half-interval every two or three
  // clocks, about 40 ns, while the firmware under test emits 120 clocks = 2 us.
  // A constant asserted in one domain and consumed in another is this block's
  // recurring defect, and the point of deriving the figure is being unable to
  // write the mistake rather than having written it once.
  localparam int HALF_CLOCKS = 120;  // 2 us at 60 MHz, and the firmware's own
                                     // figure: it counts half-intervals on
                                     // I2CTICK, the free-running 1 us counter,
                                     // so a 2 us half-interval is 120 clocks
  localparam real HALF_US = HALF_CLOCKS * CLK_NS / 1000.0;   // derived, not asserted
  localparam int NBITS   = 24;       // three bytes
  // THE PREAMBLE GOES ON THE WIRE BEFORE THE FRAME, and it is EIGHT ZEROS
  // THEN EIGHT ONES. It is not a courtesy: a bi-phase stream carries no
  // polarity information, and the interval sequence of the two encodings of
  // one frame is byte-for-byte IDENTICAL (property 4 of the self-check), so a
  // receiver that has not been told the polarity decodes a well-formed frame
  // into its complement. The preamble is the only thing on the wire that can
  // tell it.
  //
  // WHY THIS SHAPE, and it is the run structure rather than the values:
  // adjacent bits EQUAL means a boundary transition exists, so the intervals
  // run 2 us, 2 us; adjacent bits DIFFER means no boundary, so there is one
  // 4 us gap. Eight zeros then eight ones therefore puts EXACTLY ONE four-
  // microsecond gap in the middle, with 2 us either side of it. That single
  // gap is the phase, and the eighth recovered bit -- the first one of the
  // second run -- is the polarity: the receiver assembles it as 0x80 under FM0
  // and 0x00 under FM1.
  localparam int PRE_BITS  = 16;
  localparam int PRE_HALF  = 8;      // eight of each
  localparam int TOT_BITS  = NBITS + PRE_BITS;
  localparam int TOL_US  = 1;        // the counter's own quantisation

  // The firmware's map, named because this file READS those bytes: dmem[0..2]
  // is the three bytes the firmware recovered from the input pad, dmem[3] is
  // the encoding flag (0 = FM0, 1 = FM1, 0xFF = "this stream had no
  // transitions and I am not going to invent a byte for it"), and dmem[6] is
  // the byte the firmware ENCODED, for this testbench's decoder to recover.
  localparam int F_RX   = 0;
  localparam int F_FLAG = 3;
  localparam int F_TX   = 6;

  logic clk = 0, rst_n;
  logic           host_we, host_imem_sel, run;
  logic [IAW-1:0] host_addr;
  logic [15:0]    host_wdata;
  wire [7:0] pin_out_bus, pin_oe_bus;
  logic [7:0] pin_in_bus;

  logic in_line = 1'b1;             // idle high
  // THE STIMULUS GOES ON IN_BIT, AND IT IS PLACED THERE *BY* IN_BIT. It was
  // not: the bus was built as {1'b1, in_line, 1'b0, 5'b11111}, which puts
  // in_line on bit 6 and hardwires bit 5 to ZERO. Bit 5 is IN_BIT and
  // BMC_IN, the bit firmware/bmc_frame.pe reads; bit 6 is OUT_BIT, the bit the
  // firmware encodes onto. So the stream was being driven into the chip's own
  // output pad while the firmware sampled a constant, and the firmware's
  // correctly-written `AND A, BMC_IN` could never see a transition however the
  // stimulus moved. IN_BIT was declared at the top of this file and used NOWHERE
  // else, which is why nothing complained: a constant that is asserted in one
  // place and consumed in another, and this block now has six of them.
  //
  // The base is 8'h9F: bit 7 high as before, bits 4..0 high, and BOTH bit 5 and
  // bit 6 low so the stimulus cannot drive the pad the firmware drives. The
  // stream is then OR'd in through IN_MASK, which is derived from IN_BIT, so
  // the two cannot drift apart again -- the failure mode was a literal in a
  // concatenation disagreeing with a constant three declarations away.
  localparam logic [7:0] IN_MASK = 8'h01 << IN_BIT;
  assign pin_in_bus = 8'h9F | (in_line ? IN_MASK : 8'h00);

  wire out_line = pin_out_bus[OUT_BIT];
  wire out_oe   = pin_oe_bus[OUT_BIT];

  logic [9:0] dbg_pc;
  logic [7:0] dbg_a, dbg_timer;

  pe_soc #(
    .IMEM_WORDS(IMEM_WORDS), .DMEM_BYTES(DMEM_BYTES), .BAUD(BAUD)
  ) dut (
    .clk(clk), .rst_n(rst_n),
    .host_we(host_we), .host_imem_sel(host_imem_sel),
    .host_addr(host_addr), .host_wdata(host_wdata), .run(run),
    .dbg_rd_req(1'b0), .dbg_rd_dmem(1'b0), .dbg_rd_addr(16'h0000),
    .dbg_rd_data(), .dbg_rd_valid(),
    .pin_in(pin_in_bus), .pin_out(pin_out_bus), .pin_oe(pin_oe_bus),
    .dbg_pc(dbg_pc), .dbg_a(dbg_a), .dbg_timer(dbg_timer),
    .dbg_hold(1'b0), .dbg_step(1'b0)
  );
  always #(CLK_NS/2) clk = ~clk;

  integer errors = 0;

  // THE FIRMWARE'S OWN INTERVAL HISTOGRAM, MEASURED. firmware/bmc_frame.pe's
  // header claims dmem[8] "is 2 or 4 and nothing else -- measured, not
  // assumed: the write-hook counts 18 twos and 13 fours over one frame and no
  // six." **That claim was UNCHECKED for the whole life of the act: no
  // write-hook existed, and the failure message in this file CLAIMED the
  // firmware's write-hook was graded against these numbers, which was itself
  // false.** This is the hook, and it is a gate rather than a probe so the
  // claim cannot go stale the way the comment did.
  //
  // IT WATCHES THE CPU'S DATA-STORE PORT, so it counts STORES and not samples
  // of a memory that may legitimately hold a stale value. A change-detector
  // would be the obvious cheaper thing and would be WRONG: it cannot see two
  // identical intervals in a row, and on this wire most intervals repeat, so
  // it would undercount by roughly half and still look plausible.
  integer fw_iv_2 = 0, fw_iv_4 = 0, fw_iv_6 = 0, fw_iv_gap = 0, fw_iv_n = 0;
  always @(posedge clk) begin
    if (rst_n && dut.u_cpu.dmem_we && (dut.u_cpu.dmem_addr == 8)) begin
      case (dut.u_cpu.dmem_wdata)
        8'd2: fw_iv_2 = fw_iv_2 + 1;
        8'd4: fw_iv_4 = fw_iv_4 + 1;
        8'd6: fw_iv_6 = fw_iv_6 + 1;   // a THREE-half gap: the ambiguous one
        default: fw_iv_gap = fw_iv_gap + 1;
      endcase
      fw_iv_n = fw_iv_n + 1;
    end
  end
  task automatic check(input bit c, input string m);
    if (!c) begin $display("FAIL: %s @%0t", m, $time); errors++; end
  endtask

  integer i;
  logic [15:0] prog [0:IMEM_WORDS-1];
  task automatic load_firmware();
    for (i = 0; i < IMEM_WORDS; i++) prog[i] = 16'hF000;
    $readmemh(`BMC_HEX, prog);
    for (i = 0; i < IMEM_WORDS; i++) begin
      @(posedge clk); #1;
      host_we = 1'b1; host_imem_sel = 1'b1;
      host_addr = i[IAW-1:0]; host_wdata = prog[i];
    end
    @(posedge clk); #1; host_we = 1'b0;
  endtask

  // ---- THE TESTBENCH'S ENCODER, from the wire rules ---------------------
  integer enc_byte [0:2];
  integer enc_fm0 = 1;               // 1 = FM0, 0 = FM1
  integer enc_idx = 0, enc_bit = 0, enc_half = 0;
  logic   enc_active = 0;

  // THE BIT VALUE, taken out of the frame the way the checks below want it.
  //
  // `enc_bitval` USED TO TAKE A BIT NUMBER AND ANSWER "is it bit zero?", which
  // is not the same question. The stimulus passed the BIT NUMBER 0..23, so
  // every bit of A5 3C 96 except bit 0 encoded as a '1': the testbench sent a
  // 24-bit RUN OF ONES, which under the old rules is a CONSTANT LINE. Measured
  // on the wire: `in_line` changed THREE TIMES in a 3.9 ms run of a 24-bit
  // frame, and the firmware's write-hook saw two intervals. The firmware was
  // being handed a dead line and was answering correctly.
  //
  // A function whose parameter is named `b` and means "bit index" while its
  // callers read it as "the bit" is this block's seventh constant-that-lies,
  // and it hid because the self-check below called it with 7 for "a one" and 0
  // for "a zero" -- the only two arguments for which "is it bit zero" and
  // "what is the bit" give the same answer. A check written through the same
  // lying function cannot find it. The check is now written against the
  // LEVELS, and the bit value is carried explicitly.
  function automatic bit enc_bitval(input integer b);
    enc_bitval = ((b & 1) != 0);
  endfunction

  // THE LEVEL IN A GIVEN HALF-INTERVAL, written from the CORRECTED wire
  // rules -- the three that survived the second correction, and not from the
  // first two versions, which are both wrong and both of which produced an
  // encoder that ran and looked plausible:
  //
  //   1. EVERY BIT CARRIES A TRANSITION IN ITS MIDDLE. Always. Both encodings.
  //      This is what makes the stream self-clocking, and it is the entire
  //      reason the encoding exists.
  //   2. THE DATA IS THE LEVEL OF THE FIRST HALF-INTERVAL.
  //   3. FM0 MARKS A ONE HIGH, FM1 MARKS A ONE LOW. That is the WHOLE
  //      difference between the two encodings.
  //
  // WHICH MEANS h1 = ~h0 IN EVERY CASE, and there is no `carry`.
  //
  // THE `carry` IS GONE, and its removal is the finding: the old encoder
  // threaded a `carry` through every half-interval and the whole self-check was
  // written around a "run of ones is a constant line under FM0" property that
  // needed it. That property was an ARTEFACT OF THE SUPERSEDED RULES. Under
  // the corrected ones the encoding is STATELESS -- the level of half k
  // depends on the bit and the polarity and on nothing that came before -- so
  // the statefulness that the file spent a paragraph defending was a
  // consequence of a rule that had already been thrown out.
  //
  // fm0 IS READ IN THE BODY, which has been true since the version that
  // declared the parameter and never read it. THE PARENTHESES ARE NOT
  // DECORATION: `return a ? b : c` parses as `return (a) ? b : c` and Icarus
  // will not have it.
  function automatic bit enc_level(input integer b, input integer half,
                                   input integer fm0);
    bit h0;
    h0 = (fm0 != 0) ? enc_bitval(b) : ~enc_bitval(b);  // rule 2 + rule 3
    if (half == 0) return h0;
    else           return ~h0;                         // rule 1, unconditionally
  endfunction

  // THE LEVEL AT HALF-INDEX k OF THE FRAME, which is what the stimulus walks.
  // k/2 is the bit, k%2 is the half. One function, so the stimulus and the
  // self-check cannot encode a frame differently -- the two of them sharing an
  // implementation is fine HERE because neither is the thing under test: the
  // firmware is, and it has never read this file.
  //
  // AND THE FIRST VERSION OF THIS FUNCTION WAS WRONG IN EXACTLY THE WAY THE
  // FUNCTION IT REPLACED WAS WRONG, which is worth recording: it took a HALF
  // index and indexed the frame with it (`by = k/8, bi = k%8`), so half-index
  // 9 was read as bit 9 of byte 1 when it is bit 4 of byte 1. The wire then
  // carried 17 level changes where the self-check derives 33, and the only
  // reason it was found in one minute is that the probe counts the testbench's
  // OWN output and compares it with the derivation. Two errors, four commits
  // apart, both of them "an index computed in the wrong domain, in a function
  // whose name says the domain". A name that says which index it takes is
  // worth more than a comment that says it.
  function automatic bit enc_frame_lev(input integer k, input integer fm0,
                                       input integer fb0, input integer fb1,
                                       input integer fb2);
    integer bitno, by, bi;
    bit d;
    bitno = k / 2;                 // the BIT this half belongs to
    by    = bitno / 8;
    bi    = bitno % 8;
    d     = ((by == 0 ? fb0 : (by == 1 ? fb1 : fb2)) >> bi) & 1;
    enc_frame_lev = enc_level(d, k % 2, fm0);
  endfunction

  // THE LEVEL AT HALF-INDEX k OF THE WHOLE TRANSMISSION: the preamble first,
  // then the frame. ONE function, so the preamble and the payload cannot be
  // encoded by two different pieces of code that agree only by inspection.
  //
  // THE FRAME GOES ON THE WIRE HIGH BIT FIRST, and that is a wire rule now
  // written in three places -- here, in the firmware's header, and in the
  // decoder below -- because a rule that lives in one place is a rule that goes
  // stale when its input moves. The reason is the receiver's shift-in, which
  // is a doubling with the arriving bit in at the LOW end, so the first bit to
  // arrive ends up in the HIGH position. The alternative, low bit first, would
  // have assembled every byte of A5 3C 96 as 79 4A FF -- the model caught it,
  // and it is the only fault this step has produced that no other check could
  // have: with the phase broken, the bits never arrived in any order at all.
  function automatic bit enc_wire_lev(input integer k, input integer fm0,
                                      input integer fb0, input integer fb1,
                                      input integer fb2);
    integer bitno, p;
    bit d;
    bitno = k / 2;
    if (bitno < PRE_BITS)
      d = (bitno < PRE_HALF) ? 1'b0 : 1'b1;          // eight 0s then eight 1s
    else begin
      p = bitno - PRE_BITS;
      d = ((((p < 8 ? fb0 : (p < 16 ? fb1 : fb2)) >> (7 - (p % 8))) & 1) != 0);
    end
    enc_wire_lev = enc_level(d, k % 2, fm0);
  endfunction
  // ---- THE ENCODER CHECKS ITSELF AGAINST THE PROMISED PROPERTIES ----------
  //
  // Written against the CORRECTED wire rules and against a DERIVATION, never
  // against the encoder above. That distinction is the whole point and it is
  // this block's sharpest finding: the previous four properties were all
  // evaluated THROUGH enc_level, so they could only ever confirm that
  // enc_level agreed with enc_level. They passed, and the frame that was
  // actually put on the wire was twenty-four ones.
  //
  // A property is only worth having if the check and the thing under test were
  // derived INDEPENDENTLY. Here the derivation is arithmetic on the frame: the
  // level sequence, the transition positions, the intervals, the histogram.
  // The expected histogram (16 one-half intervals, 15 two-half, for
  // A5 3C 96) was computed by hand from the three rules and is asserted as a
  // NUMBER, so if the encoder and the rules ever part company the check says
  // which one moved. **It said 18 and 14 here until this session, which is
  // this block's most repeated mistake wearing a second hat: 18 and 14 is the
  // LOW-bit-first count, it was superseded when the bit order moved, and the
  // assert twelve lines below has said 16 and 15 ever since. It is also
  // ARITHMETICALLY IMPOSSIBLE as written -- 18 + 14 is 32 intervals, and a
  // 24-bit frame in isolation can only ever yield 31, because the transition
  // into the first half-interval is outside the window. A figure that cannot
  // be true is the cheapest kind to catch and this one sat here for the whole
  // life of the act, in the same file, describing an assert that contradicts
  // it.** (Note also the scope difference, which is NOT a discrepancy: the
  // numbers here and in the assert cover the 24 PAYLOAD bits. The firmware's
  // own header counts a WHOLE frame, preamble included, so its dmem[8]
  // histogram is a different measurement and is not expected to match.)
  integer enc_fail = 0, ei, eh, ek, kk;
  bit   sc_bit  [0:NBITS-1];
  bit   sc_lv0  [0:2*NBITS-1];
  bit   sc_lv1  [0:2*NBITS-1];
  integer sc_iv0 [0:2*NBITS-1];
  integer sc_iv1 [0:2*NBITS-1];
  integer sc_b0 = 8'hA5, sc_b1 = 8'h3C, sc_b2 = 8'h96;
  integer n_iv0, n_iv1, n_mid_bad, n_data_bad, n_comp_bad, n_iv_bad;
  integer n_iv1_half, n_iv2_half, n_bnd_eq, n_bnd_ne, n_prev, n_tr;
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
