smprather/janestreet-blog-serial-protocol-emulator/(commit log)

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2026-09-18 pe_serdes review fixes: cfg snapshot, delayed RX completion (-40 cells)
    - cfg_lsb_first snapshotted at tx_load/rx_start: core can rewrite the
    config mid-transfer without corrupting an in-flight word (bug)
    - restart-on-final-cell race closed; len>MAXLEN documented unclamped;
    MAXLEN>=2 elaboration guard added
    - RX completion delayed one cycle past final strobe, deleting the 32b
    variable-shift forward path: 623 -> 583 cells, 11.5k -> 11.2k um2
    - TB updated for the documented one-cycle rx_valid latency; PASS +
    verilator lint clean; fresh VCD
    [pe_serdes.v, tb_pe_serdes.v]
2026-09-18 Add per-protocol testbenches: all 9 targets PASS around pe_serdes
    UART (8N1, both directions), SPI (mode 0 full duplex, 8/16/32b),
    I2C (7-bit addr, write/read/repeated-start, ACK model), JTAG (TAP
    walk, Capture/Shift-DR, BSR model), SWD (req/ACK/32b data + parity,
    turnaround), PS/2 (11-bit frame, odd parity, host inhibit), CAN
    (classic frame, bit stuffing + on-the-fly destuff, CRC-15, ACK),
    USB-LS (NRZI + stuffing, SYNC/PID/EOP), 10BASE-T (Manchester, full
    frame, CRC-32 FCS model).
    TB lessons encoded: sticky event flags for single-cycle pulses;
    SERDES words <= 32b (SWD parity + CAN/USB/ETH payloads chunked);
    JTAG needs explicit 5xTMS TAP reset; CAN receiver must skip stuff
    bits after 5-run,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
    [tb_pe_can.v, tb_pe_eth.v, tb_pe_i2c.v, tb_pe_jtag.v, tb_pe_spi.v, tb_pe_swd.v, tb_pe_uart.v]
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2026-09-19 Add Tier-1 line-code codecs + config-driven pipeline mux (14/14 TBs pass)
    rtl/pe_line_codec.v:
    - pe_nrzi: TX level register + SEPARATE sampled RX level (a receiver
    cannot see TX state); decode is XNOR (transition=0, hold=1). 12 cells.
    - pe_manch: explicit half_phase input (SM/timing owns half-UI cadence);
    RX decodes from DRU half-cell samples, flags missing mid-bit edge. 5 cells.
    - pe_bitstuff: runtime run_cfg (5=CAN, 6=USB, 1-15 general); TX emits the
    real bit then consumes a FOLLOWING strobe for the stuff bit (previous
    version corrupted data by replacing the run's last bit); RX flags the
    stuffed slot and errors if the post-run bit is not complementary.
    84 cells (runtime run_cfg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
    [pe_codec_mux.v, tb_pe_codec_mux.v, tb_pe_line_codec.v]
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2026-09-19 live-canvas: zoom & pan for rendered slides
    Wide diagrams (gen_vcd_view emits 4210px for the UART timeline) were unreadable
    squeezed into a ~740px pane.
    - toolbar: -/+ step zoom (25%-800%), 100% = authored pixel size, Fit; live figure
    - Ctrl/Cmd + wheel zooms in the diagram; drag pans at any zoom but Fit
    - text slides zoom by font size so the type reflows instead of scaling
    - coming out of Fit, + steps from wherever Fit landed rather than lurching to 100%
    - HTML slides get no viewer injected (they are the author's own document)
    Two bugs found while building this, both from verification not inspection:
    1. An SVG with width+height+viewBox scales its CONTENT to fit the box it is
    given (pr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
2026-09-19 Add an SRAM budget: the die's shape, not its area, is the constraint
    Answers "how much SRAM fits" from the PDK LEFs rather than from bit counts.
    - wiki/reference/sram-budget.md: all 30 sg13g2 SRAM macros with real W x H,
    area and bits/um2, parsed by tools/gen_sram_budget.py
    - TT tile notation is WIDTH x HEIGHT, so 8x4 at the ttihp template's 167x108 um
    tile is 1336x432 um -- a 3.1:1 die of 0.577 mm2. (The blog's 200x150 would
    give 1600x600 / 0.96 mm2; the discrepancy is an open risk in STATUS, and the
    page reports both.)
    - Consequence: the two densest macro classes do not fit at all. 8192x32 is
    1520x618 (wider than the die even rotated) and 2048x64 is 784x627 (too tall
    in both o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
2026-09-20 Review pass: four defects the green regression could not see, plus the TT top level
    The regression was 16/16 green and every headline number in STATUS checked out.
    All four defects below are ones a passing testbench structurally cannot catch,
    because a testbench only ever observes the simulator's resolution of illegal RTL
    — never the synthesiser's.
    Defects
    - tick_flag had TWO always_ff drivers. Icarus raced it (50 of 100 ticks dropped
    by a two-instruction poll loop) and yosys resolved the driver-driver conflict
    to a CONSTANT 0, so the STATUS port worked in simulation and was dead in the
    netlist. Now one process, set-beats-clear.
    - dbg_pc/dbg_a were hierarchical references. yosys dec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
    [pe_codec_mux.v, pe_cpu.v, pe_serdes.v, peasm.py, peemu.py, tb_pe_codec_mux.v, tb_pe_line_codec.v]
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2026-09-20 Re-fetch the blog verbatim: the allocation is 6x4, not 8x4
    The repo held only a hand-written summary of the competition blog, and that
    summary got the headline constraint wrong. The blog says 6x4 three times:
    "Set the tile size in info.yaml to 6x4", "The current maximum area is 6x4 tiles
    per design", and "An 6x4 allocation is 24 tiles ... about 0.7 mm2". 8x4 appears
    only as a possibility being worked on, worth ~30% more area, to be announced by
    a page update and an email to sign-ups.
    Keep the root reference
    wiki/raw/articles/janestreet-competition-blog-fulltext.md is the full verbatim
    text with a sha256 of the fetched HTML. The 2026-09-17 summary is left untouched,
    since raw sources are imm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
2026-09-21 CRC/DRU blocks, the SRAM swap, and the 60 MHz clock decision
    Three bodies of work, all verified against real tools.
    1. CRC LFSR (rtl/pe_crc.v) and DRU (rtl/pe_dru.v).
    One 32-bit shift-right datapath serves every target polynomial from CRC-5
    to CRC-32 with no mode bit and no width port, because the high bits
    provably stay zero. Constants are DERIVED and checked against the RevEng
    catalogue on every run (tools/gen_crc_config.py --check); the TB asserts
    both check and residue, so a transcription error fails the build. The DRU
    needs no state machine: a Manchester cell's halves always differ, so
    well_formed = (rx_first != rx_second), and a phase-3*SPB/4 capture is
    always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
    [pe_cpu.v, pe_crc.v, pe_dru.v, pe_imem.v, peasm.py, peemu.py, tb_pe_crc.v, tb_pe_dru.v]
2026-09-21 Switch the whole project to the 60 MHz operating point
    60 MHz stops being a "turbo" and becomes the design point (ADR-005 amended),
    per "redesign everything around 60MHz".
    Switched:
    - pe_uart_soc CLK_HZ default 40e6 -> 60e6; tt_um top instantiation -> 60 MHz
    - pe_dru SPB default 8 -> 12 (60 MHz DDR grid = 12 samples/bit, 8.33 ns)
    - info.yaml clock_hz -> 60000000
    - peemu.py CLK_HZ + tick table; 260 ticks/half-bit, +0.160% (was +0.353%)
    - TBs: tb_pe_uart_soc, tb_pe_tick_status, tb_pe_dru, tb_tt_um_protocol_emulator,
    tb_pe_cpu, tb_pe_imem clock/grid params
    - firmware/uart_echo.pe timing comments; flow/pe_serdes.json signoff comment
    No RTL restructuring and no firmware edit were required --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
    [pe_dru.v, peemu.py, tb_pe_cpu.v, tb_pe_dru.v, tb_pe_imem.v, tb_tt_um_protocol_emulator.v, tt_um_protocol_emulator.v]
2026-09-22 SPI as firmware, and the full-SoC signoff: two flow fixes
    SPI (baseline protocol #2). firmware/spi_xfer.pe is a mode-0 master in 70
    words of pe_cpu code: no shift register, no baud generator, no bit counter in
    RTL. It runs on the SAME 8-bit port and the SAME PIN_IN_MASK as the UART, so
    nothing in the hardware knows which protocol is active -- that is the project
    thesis, now demonstrated for two of the blog's three baseline protocols.
    The port change that enabled it (single pin -> 8-bit port, "outputs low,
    inputs high", PIN_IN_MASK = 8'hF8) landed here too, along with the shared
    UART/SPI pin map.
    tools/peemu.py gains a mode-0 slave model (poll_spi_slave) and --spi-slave, so
    the firmware is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
    [peemu.py, tt_um_protocol_emulator.v]
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2026-09-22 plan: mark SPI-as-firmware done (step 4b), note the missing spi SoC TB
2026-09-22 flow: final state 57/80 -- PDN fix confirmed, next blocker is the PDK GDS layer name
    RUN_2026-09-22_00-33-59 (both flow fixes) reaches 57 of 80 steps:
    - detailed routing 0 DRC violations (from 1160)
    - setup +1.143 ns / hold +0.121 ns, 0 violating paths, all 3 corners
    - SRAM in-context A_CLK -> A_DOUT = 7.635 ns
    - IR drop 0.30% (3.56 mV of 1.20 V)
    - flow gates: routing DRC clear, power grid violations clear,
    disconnected pins clear, lint warnings clear
    The PDN fix is confirmed end to end: PSM-0040 (all shapes connected) now
    appears in both the pdngen and IR-drop steps and PSM-0069 appears nowhere.
    The IR-drop step that previously aborted the flow now completes.
    Third blocker f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
2026-09-22 Pin matrix: runtime per-pin direction, open-drain, read-back
    rtl/pe_pinmux.v is plan step 4 -- the last hardware the baseline tier needs.
    Everything after it (I2C, PS/2, SWD, USB) is firmware.
    Four registers per pin: OUT, OE, IN (read-only), OD.
    The OD bit is the load-bearing one: pad_oe is oe AND NOT(od AND out), so in
    open-drain mode a pin holding a 1 is RELEASED rather than driven high.
    That makes the bus-contention state unreachable rather than merely
    discouraged -- and it means the same firmware sends bits in both modes
    (out=1 for a 1, out=0 for a 0), which is what "swap the program, gates
    unchanged" actually requires. Without it open-drain firmware has to toggle
    oe instead of out, an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
    [pe_pinmux.v, tb_pe_pinmux.v]
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2026-09-22 flow reaches 76/80; the last blockers are both inside the vendor macro
    RUN_2026-09-22_00-48-35 ran 76 of 80 steps: past the Magic PR-boundary
    abort, through GDS streamout, KLayout XOR (clear), Magic DRC, KLayout DRC,
    LVS, all four timing checkers, to reportmanufacturability. It then quit on
    DEFERRED errors -- 1113909 Magic DRC and 2672 KLayout DRC.
    Investigated rather than assumed, because wiki/entities/tiny-tapeout says TT
    accepts custom macros only when DRC/LVS-clean:
    Magic 1113909 of 1113909 inside the macro footprint (parsed every
    coordinate against the placed bbox; 0 outside). Rules are
    library-internal: Cnt.c (880232), LU.b (104724), Gat.c (104737),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
2026-09-22 plan: the full-SoC flow state -- 4 blockers, 3 flow-config, 2 open
    Three of the four flow blockers were config and are fixed + verified
    (resizer uncertainty split, GRT_ADJUSTMENT 0.0, custom PDN_CFG for the
    macro's Metal4 supplies, MAGIC_MACRO_STD_CELL_SOURCE for the PR boundary).
    What is left is NOT flow config:
    1. max-slew/max-cap violations, GATED by steps 74-75 in all three corners,
    on SRAM pins some of which sit outside the macro's .lib characterization
    (OpenROAD extrapolates silently; repair_design resizes nothing because
    it runs with -slew_margin 20 -cap_margin 20).
    2. 1113909 Magic + 2672 KLayout DRC, 100% inside the vendor macro; the
    PDK's deck fires 4 of 17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
2026-09-22 STATUS gotchas 39-43: the checkers fire, the DRC is all macro-internal, LVS passes
    39: the flow GATES on max-slew/max-cap -- steps 72-75 are
    Checker.{Setup,Hold,MaxSlew,MaxCap}Violations and the last two FIRE in all
    three corners. Gated failure, not a warning.
    40: 1113909 Magic + 2672 KLayout DRC errors, 100% inside the vendor SRAM,
    established by parsing every coordinate and every cell name.
    41: MAGIC_GDS_FLATGLOB is the sanctioned route and is unset.
    42: LVS PASSES -- 'Circuits match uniquely', 1926 devices / 1939 nets both
    sides. Independent evidence the DRC is geometric false-positive.
    43: the test that distinguishes PDK-vs-ours is the PDK deck on the macro ALONE,
    and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
2026-09-22 Macro DRC is the PDK's, not ours -- proved by the macro-alone diff
    Ran the PDK's own run_drc.py on the SRAM macro ALONE (--run_mode deep, the
    mode LibreLane uses) and diffed rule-by-rule against the full SoC:
    rule macro alone full SoC verdict
    Sdiod.d 1136 1136 identical
    Sdiod.e 1136 1136 identical
    Cnt.c.digibnd 400 400 identical
    M5.j/M5Fil.h/TM1.c/TM2.c 1 each 0 our PDN/fill fixed them
    TOTAL 2676 2672
    2672 of 2672 SoC violations reproduce EXACTLY from the vendor macro standalone;
    ZERO are introduced by assembling the SoC. The vendor's own runner prints
    'KLa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
2026-09-22 Fix stale 40-clock I2C tick figures left from the 40 MHz era
    The 60 MHz switch (e69d862) updated the UART tick (173 -> 260) but two I2C
    references still said the 1 us tick was 40 clocks. At 60 MHz it is 60.
    - HANDOFF.md 'Current work list': 1 us tick = 40 -> 60 clocks
    - tools/live-canvas/flowcharts/plan-through-i2c.json w5: same
    wiki/log.md keeps its 40-clock entry: the log is append-only history, and
    that entry records what was believed at the time. The plan page
    (wiki/plans/through-i2c.md) already said 60 and is authoritative.
2026-09-22 Timing margin at 60 MHz: 16% setup, Fmax 71.4 MHz, and the hold fix costs 11% of it
    Extracted from RUN_2026-09-22_00-48-35 (55-openroad-stapostpnr). Signoff is at
    66 MHz (CLOCK_PERIOD 15.15 ns); the operating point is 60 MHz (16.667 ns) --
    two different margins.
    setup worst slack: +1.143 ns @66 MHz -> +2.660 ns @60 MHz (16.0% of period)
    hold worst slack: +0.121 ns (fast corner); 0 violating paths both
    Fmax, post-route, slow corner: 71.4 MHz (min period 14.007 ns) -- 19% headroom
    The critical path is NOT the CPU. It starts at the SRAM (A_DOUT[12], 7.635 ns
    = 57% of the 13.448 ns arrival), then a chain of hold-fix buffers
    (fanout118/115/113, sg13g2_buf_1, 1.55 ns) and hold626 (sg1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
2026-09-22 docs: catch the remaining 15.15/66 MHz signoff references
    The 66 MHz target is retired, so every doc that still described the signoff
    point as 15.15 ns needed correcting -- leaving them would mean the wiki
    disagrees with the flow configs about what the design is signed against.
    - STATUS 'Timing margin': the @60 column is now the signoff column, not a
    conversion the reader has to do
    - HANDOFF: the SRAM's 7.639 ns is against 16.667 ns now
    - ADR-005: amend with the lock; the SoC STA requirement is 60 MHz, not 15.15
    - tx-timing-generation: the signoff section is 'close AND run at 60'
    Kept, with reasons: the 66 MHz JITTER PROOF (that is why 66 is not usable
    and it does not stop being true) an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
2026-09-22 Add a generated, drift-gated Mermaid block diagram
    The hand-drawn ASCII diagram in STATUS had rotted in three places at once:
    it still said "the pin matrix does not exist yet" (landed 2026-09-22, 111
    cells, with a TB), it described pe_uart_soc's memory as "flop memory" (the
    SRAM macro swap landed 2026-09-20), and it listed pe_dru/pe_crc as unbuilt
    in one place while citing their cell counts in another. A diagram is the
    most-read and least-checked artifact in a repo, which is exactly the
    combination that rots.
    So: wiki/reference/block-diagram.md, generated by tools/gen_block_diagram.py,
    wired into run_all.sh as the sixth drift gate. STATUS keeps a four-line
    one-liner and points at the page.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
2026-09-22 Correct a wrong claim: max-slew/max-cap WARN, they do not gate
    The 60 MHz SoC run (RUN_2026-09-22_02-58-32) finished at 76/80 and its log tail
    prints two lines that look contradictory:
    Max Slew violations found in the following corners:
    * nom_fast_1p32V_m40C / * nom_slow_1p08V_125C / * nom_typ_1p20V_25C
    No max slew violations found
    I had previously recorded (STATUS gotcha 39, and the plan's tapeout-blockers
    list) that this meant the flow GATES on slew/cap and collected them as deferred
    errors. That is wrong, and two runs were analysed on that premise.
    The mechanism, read out of librelane/steps/checker.py:
    TimingViolations.check_timing_violations():
    for each metric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
2026-09-22 Fix the Canvas pane: every mermaid diagram rendered blank
    Reported from a screenshot: diagrams/block-diagram-chip.svg rendered correctly in
    mermaid-cli and in a plain browser, but the Canvas pane showed a white stage
    until Fit was clicked.
    Two independent bugs in the pane's viewer, both found by measurement:
    1. parseFloat('100%') returns 100 -- TRUTHY. Mermaid emits width="100%" on most
    diagrams, so the `if(!iw || !ih)` viewBox fallback never fired and the viewer
    believed the drawing was 100 px wide instead of its viewBox width. Every
    derived number was wrong by that ratio: the pane's own lc-fit message reported
    7.41 where 741/1593.7 = 0.465 is correct, and the 100% button drew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
2026-09-22 Record the pin matrix ADR and the I2C-on-the-matrix findings
    The code landed in 4ea345a; this is the record. Two new pages and corrections
    to four existing ones, because the plan and the concept page both said things
    this work proved wrong.
    wiki/decisions/adr-006-pin-matrix.md (new)
    - Why the matrix is inside pe_uart_soc. The plan's "the TT wrapper
    instantiates the matrix" is unimplementable: the CPU's IO bus never leaves
    the SoC, so a matrix at the wrapper has OE/OD registers no program can
    reach, and I2C -- the only protocol that needs them -- would be hardware
    nothing drives.
    - Why the register file is per-pin {out,oe,od} rather than the plan's
    cfg_prot[i] protoco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
2026-09-22 Verify SPI mode 0 on real RTL, and measure the two simulators
    SPI was a baseline protocol whose ONLY executable specification was
    tools/peemu.py -- a model written from the same understanding as the firmware,
    so it could agree with the firmware about a wrong bit order and pass. There is
    now an RTL testbench, and it models a real mode-0 SLAVE, because a master with
    no slave is not a protocol, it is a pin toggling.
    tb/tb_pe_spi_soc.v (NEW). The slave is the load-bearing part: it decodes MOSI
    from the pins on the SCLK rise and presents MISO on the fall, so the byte the
    master sends is checked against what a real slave would have captured, MSB
    first. Eight distinct non-palindromic responses (A7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
2026-09-22 Sweep the wiki: real drift, five unlogged builds, and the receive-path page
    A context-flush capture turned into a drift audit, and the audit found real
    problems rather than confirming the wiki was fine.
    DATES WERE IN THE FUTURE. Pages carried 2026-09-23 and 2026-09-24 while `date`
    reports 2026-09-22 and every commit agrees. Corrected repo-wide. Nothing broke,
    which is why it survived: no gate reads a date, and a future-dated page sorts as
    more current than the work it describes.
    THE INDEX WAS 10 PAGES BEHIND (said 30; disk had 32 non-raw). Now counted
    programmatically rather than by hand. STATUS's header said branch `main` while
    the branch is `review/fix-invisible-defects`, and titled itse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
2026-09-22 Emulator: execute before ticking, and hold imem[0] while stopped
    Two review findings, both reproduced against the RTL before the fix.
    TIMER ORDER. The emulator advanced the tick counters at the TOP of step(),
    so a read that landed on the wrap cycle saw the new counter and could clear a
    flag the tick had just set. The RTL updates every register on the same edge:
    the read is combinational from the PRE-edge value, and when a wrap and a
    STATUS read share an edge, `tick_now` beats the read clear. Measured on
    reviews/2026-09-22/timer-rtl.v: RTL reports A=0 and keeps the flag; the old
    emulator reported A=1 and cleared it. Both timers were affected. `step()` now
    executes, then ticks, and the stoppe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
    [peemu.py]
2026-09-22 peasm --rtl-init: emit valid Verilog, and stop truncating at 128 words
    Two measured defects in one function:
    * the emitted text was not Verilog at all -- `initial $readmemh_unused;`
    followed by a bare comma-separated list of words;
    * the default width was 128, so a 301-word program (legal since the SRAM
    swap) emitted 128 assignments and silently ran a different program.
    It now emits a one-word-per-line `initial begin ... end` assignment block at
    the real IMEM_WORDS depth (1024) and raises AsmError when the program is wider
    than the requested width instead of truncating. The output compiles under
    iverilog against a 1024-word imem.
    Files: tools/peasm.py.
    [peasm.py]
2026-09-22 10BASE-T receive at the real grid: DDR sampling, 802.3 padding, full reclaim
    Three review findings in the receive path, all reproduced before the fix. The
    review artifacts are reviews/2026-09-22/ (eth-rate60/120.v, eth-cases.v).
    1. THE DRU SAMPLED RISING EDGES ONLY. At the locked 60 MHz core and SPB=12
    that is a 200 ns bit; 10BASE-T is 100 ns/bit, so a real stimulus was missed
    entirely. The TBs drove the wire at half rate to match the clock, which is
    why a green suite hid it (measured: a real 100 ns/bit frame passed at
    120 MHz and failed at 60 MHz; reviews/2026-09-22/eth-rate*.v).
    pe_dru now has ADR-002's dual-edge front end: the rising sample keeps the
    2-flop synchronize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
    [pe_dru.v, pe_eth_mac.v, tb_pe_dru.v, tb_pe_eth_mac.v]
2026-09-22 Lint gate: cover pe_eth_mac and pe_fbuf, and fail on any yosys ERROR
    Two holes found in the review, one of them a real blind spot.
    COVERAGE. pe_eth_mac and pe_fbuf were missing from RTL_ALL and the top lists,
    so the regression reported "lint clean" while a direct verilator -Wall on the
    MAC produced five findings: a width expansion on the FCS wind-back and four
    unused signals, two of them 12 dst/src registers nothing ever read. The RTL is
    fixed rather than suppressed -- 7-bit shift registers where the eighth bit is
    written and never read, the dead registers removed, a sized subtraction -- and
    adding the MAC to the file list also surfaced a TIMESCALEMOD (it was the only
    RTL file carrying a ti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
    [pe_fbuf.v]
2026-09-22 Complete the tapeout and flow source lists
    The Tiny Tapeout info.yaml listed only pe_cpu, pe_uart_soc and the wrapper.
    Compiling those three ended in `Unknown module type:
    RM_IHPSG13_1P_1024x16_c2_bm_bist` -- pe_imem and pe_pinmux are instantiated by
    the SoC and were both missing, along with the SRAM macro's port shell. The
    LibreLane full-SoC config (flow/pe_uart_soc.json) omitted pe_pinmux the same
    way, so a flow run would have elaborated an unknown module.
    Both lists are complete now. The TT list is verified by compiling exactly the
    listed files under iverilog with -s tt_um_protocol_emulator; the flow stager
    copies every name in VERILOG_FILES from rtl/, so no script change is needed.
    Fil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
2026-09-22 Add the project review report and its reproduction artifacts
    The review ran on a `git archive` clone at b935cb8. The baseline was 26/26
    RTL TBs, 16/16 firmware checks and all four mutation suites green while the
    overall command exited non-zero -- the failures were in the gates around the
    tests, not the tests.
    reviews/2026-09-22/REVIEW.md is the nine-finding report with each fix and the
    test that would catch a regression. The rest of the directory is the review's
    own evidence: eth-cases.v (the padded/overflow Ethernet repro),
    eth-rate60.v / eth-rate120.v (the sampling-rate proof: the same real-rate
    frame passes at 120 MHz and fails at 60 MHz on the old single-edge DRU),
    timer-rtl.v (the wrap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
    [eth-cases.v, eth-rate120.v, eth-rate60.v, timer-rtl.v]
2026-09-22 Docs: log the nine-finding review work and correct the measured numbers
    - wiki/log.md: a review entry covering all nine findings (P1 source lists, DDR
    receive, oversize reclaim; P2 padding, emulator timer order, stop->run
    prefetch, fresh-clone gates, lint coverage + the yosys ERROR hole,
    --rtl-init) with the files and the regression state.
    - wiki/STATUS.md: pe_dru is 144 cells / 2,315 um2 (was 116 / 2,065) and the
    grid is dual-edge as of this work; pe_eth_mac is 1,100 cells; the SoC is
    1,261 / 23,294 and the TT top 1,294 / 23,382 from synth_area (the old 1,083
    predates the pin matrix moving inside). Regression counts 26/26 + 17/17,
    four mutation suites, and the gate details.
    -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
2026-09-22 SPI/I2C mutation harnesses: restore-verify against a snapshot, not git
    The fresh-clone regression (the test the review runs: `git archive HEAD` with
    none of the ignored files) exposed the remaining two harnesses that verified
    restores with `git diff --quiet`. A git archive clone has no `.git` at all, so
    `git diff` fails and the harness refuses to continue -- the SPI suite failed
    the clone run, one step after the fresh-clone diagram gates were fixed.
    Both now snapshot the mutable files into a temporary pristine directory and
    verify with `cmp`, the same form tb/mutate_fbuf_tb.sh and
    tb/mutate_eth_mac_tb.sh use. That also removes the false positive a git-clean
    check has on a legitimate uncommi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
2026-09-22 Mutation harnesses: restore, disarm, exit on a trapped signal
    The first trap version restored the sources but let bash resume the script:
    a TERM trap that returns does not terminate the shell, so the interrupted case
    continued into its normal restore/verify path, found the snapshot the trap had
    already deleted, and exited 3 with a confusing 'RESTORE FAILED'. Signals now
    restore, remove the traps, and exit 143 immediately; the EXIT trap keeps the
    normal path unchanged.
2026-09-22 Ethernet fixes: two-latch DDR capture, and validate structure before the CRC
    Two P1 findings from the second review (reviews/2026-09-22/REVIEW-2.md
    R2-1 and R2-2), both reproduced before the fix.
    R2-1 — THE FALLING-EDGE CAPTURE RACED THE RISING EDGE. A single
    transparent-high latch re-opens at the rising edge, and its blocking
    assignment competes with the receiving flop's read in the same active region
    step, so the flop could take the NEW pin level instead of the value held since
    the falling edge. Measured: a real frame with 49.995 ns half-cells lost 10,786
    of 12,144 folds and was rejected; 34 of 102 phase/duration/filter trials
    failed, every faster-wire one. The capture is now a two-latc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
    [pe_dru.v, pe_eth_mac.v, tb_pe_eth_mac.v]
2026-09-22 USB stuffing: an explicit ones-only rule, not a symmetric run counter
    R2-3 from the second review. pe_bitstuff counted identical bits of EITHER
    polarity, so a USB configuration inserted a complementary bit after six ZEROES
    as well as six ones. USB 1.1 7.1.9 stamps a 0 only after six consecutive ONES
    (before NRZI). Measured: eight valid raw zeroes on the USB config became seven
    received bits plus a stuffing error, and the wire got an unwanted stuffed bit
    on the seventh strobe. The mux TB could not see it because it built its
    expected stream with the same symmetric rule, and the round trip through the
    same faulty rule is self-consistent.
    pe_bitstuff now has an explicit `ones_only` input; pe_c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
    [pe_codec_mux.v, tb_pe_codec_mux.v, tb_pe_line_codec.v, usb_zeros.v]
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2026-09-22 Emulator: sample UART bits at their centres, not their boundaries
    R2-6 from the second review. The TX monitor scheduled its first data sample one
    bit period after the start edge -- the start/data boundary. The centre of data
    bit 0 is 1.5 periods after the edge. A wire only slightly slower than the
    monitor's nominal period therefore made every sample read the preceding bit:
    an independent 8N1 A5 at 521 clocks/bit decoded as 4A, while 520 and 519
    decoded correctly. The stop sample was early too, so the last data bit could
    be accepted as the stop.
    The first sample is now at 1.5 bit periods (data centres) and the stop sample
    lands at 9.5 (its centre). The monitor is a firmware verification orac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
    [peemu.py]
2026-09-22 Add the second-review report and reproducers; record the resolutions
    reviews/2026-09-22/REVIEW-2.md is the second review of 628e309: seven findings
    (two P1, five P2) reproduced with directed probes while the standard regression
    was green. reviews/2026-09-22/review2/ holds the probes and logs. The report
    now ends with the resolution table: each finding's fix and its permanent test,
    and the note that the probe suite exits 0 (the async Ethernet sweep is
    102/0). The usb_zeros.v probe was updated to the explicit 0xE3 USB config byte.
    Files: reviews/2026-09-22/REVIEW-2.md, reviews/2026-09-22/review2/.
    [cpu_restart.v, dru_async.v, dru_sweep.v, mac_runt.v, memory_contract.v, mutation_interrupt.py, uart_monitor.py]
2026-09-22 Docs: second-review findings resolved; measured sizes and counts refreshed
    - HANDOFF.md: the open-findings table becomes a fix table; the verified-state
    counts are 26/26 RTL, 18/18 firmware, and the review probe suite exits 0. The
    next work is the integration/loader/I2C backlog, not the review.
    - wiki/STATUS.md: header and "Where we are" now state the seven findings are
    fixed and the probe suite passes; the block table takes the new mapped sizes
    from synth_area (DRU 150/2,360; bit stuffing 99; mux 130; CPU 377; eth_mac
    1,121; SoC 1,264/23,184; TT top 1,284/23,211), and the regression counts are
    18/18 firmware with lint at 14 tops + 11 elaborations.
    - wiki/log.md: a second entry u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
2026-09-23 Ethernet: enforce the 64-byte minimum and byte alignment (F1)
    The fix-verification pass found that the structural verdict from R2-2 stopped
    the pointer underflow but not the class: a valid CRC residue on an undersized
    or partial-byte frame was still trusted. Measured
    (reviews/2026-09-23/FIX-VERIFICATION.md F1):
    * header + FCS only (18 bytes) -> accepted, length 0;
    * header + 45 data + FCS (63 bytes) -> accepted, length 45;
    * a full type frame followed by 1..7 extra bits with a recomputed FCS ->
    all accepted, bit_cnt = 1..7.
    S_SETTLE now also requires `bit_cnt == 0` (a frame ends on a byte boundary) and,
    for a type frame, `pay_cnt >= MIN_TYPE_PAY` = 46 data/pad + the 4 stored FCS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
    [pe_eth_mac.v, tb_pe_eth_mac.v]
2026-09-23 Add the fix-verification pass, rescued evidence, and the F1/F2 resolutions
    reviews/2026-09-23/FIX-VERIFICATION.md records the check of the second-review
    fixes at bdd7728: all seven originals pass, and two follow-ups (F1 Ethernet
    structure, F2 codec config reference) were found. The report now ends with the
    F1/F2 resolution section; mac_boundaries.v and run-boundaries.sh are the F1
    reproducers and now exit 0, and codec_model.v is the independent USB/CAN wire
    model (524 streams / 4,822 cells, 0 errors).
    The evidence logs are stored as .txt because the repo's global *.log ignore
    rule had excluded the earlier review logs from commits; the .txt copies of the
    second review's logs are added too, a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
    [codec_model.v, mac_boundaries.v]
2026-09-23 Docs: F1/F2 resolved; no open review finding; refreshed sizes
    HANDOFF: the verification pass section now records F1/F2 as fixed with their
    permanent tests, adds run-boundaries.sh to the verified commands, and points
    next at the integration/loader/I2C backlog. STATUS: header and "Where we are"
    state there is no open review finding; step 0 of the work list is DONE; the
    block table takes the latest synth_area sizes (DRU 148/2,398, eth_mac
    1,151/17,315). log.md records the F1/F2 build entry. README sizes refreshed.
    Files: HANDOFF.md, wiki/STATUS.md, wiki/log.md, README.md.
2026-09-23 Codec glossary: the CAN preset is 0x51, not 0x05 (F3)
    The recheck found the CAN example added by the F2 note was wrong: 0x05 =
    0b0000_0101 sets cfg[2] as well as cfg[0], so it enables Manchester. Measured
    with reviews/2026-09-23/f1-f2-recheck/can_config.v: one raw CAN bit of 1 gives
    TX=0/RX=0/error=1 at 0x05, and TX=1/RX=1/error=0 at 0x01 and 0x51. The RTL was
    always correct; only the documented example was wrong, and the drift gate
    passed because the generator note and the generated page carried the same
    incorrect value.
    The note now gives CAN as 0x51 (stuff + explicit run 5), notes 0x01 as the
    equivalent default-run form (run nibble 0 means default 5), and says plainly
    that 0x05 is not a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
    [tb_pe_codec_mux.v]
2026-09-23 Add the F1/F2 recheck, its evidence, and the F3 resolution
    reviews/2026-09-23/F1-F2-RECHECK.md verifies 655c5b7: F1 passes every
    rejection assertion and the valid control, the F2 USB layout is correct, and
    the one new P2 (F3, the CAN example) is resolved in the appended resolution
    section. f1-f2-recheck/ holds the CAN reproducer and fresh boundary, probe, and
    regression outputs.
    Files: reviews/2026-09-23/F1-F2-RECHECK.md, reviews/2026-09-23/f1-f2-recheck/,
    reviews/2026-09-23/FIX-VERIFICATION.md.
    [can_config.v]
2026-09-23 Docs: F3 closed; no open review finding
    HANDOFF and STATUS now state that all four check passes are resolved (F3 fixed:
    CAN 0x51/0x01 in the generator and reference, with a permanent tb_pe_codec_mux
    check) and point next at the integration/loader/I2C backlog. log.md records
    the F3 fix and its tests.
    Files: HANDOFF.md, wiki/STATUS.md, wiki/log.md.
2026-09-23 Reorganize the project layout, one module per file (functional no-op)
    No RTL logic, firmware byte, testbench check or tool behavior changed. This is
    the layout rework the previous discussion called for; every old name/path was
    either moved with git mv or replaced mechanically, and the full regression plus
    all three review probe suites pass on the result.
    RTL (rtl/)
    * pe_uart_soc.v -> pe_soc.v. The module never had UART hardware; the name was
    the milestone it was born in. Module and every instantiation renamed.
    * pe_line_codec.v split into one module per file: pe_nrzi.v, pe_manch.v,
    pe_bitstuff.v. Module bodies are byte-identical; the shared header is
    redistributed and the DE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
    [block_diagram.py, clock_arithmetic.py, crc_config.py, mutation_interrupt.py, pe_bitstuff.v]
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2026-09-23 Decision: pe_ctrl is a passive SPI slave (ADR-007); resolves ADR-006's open question
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2026-09-23 review: record E1, its reproducer, the fix evidence and the hardening recheck
    [window_reclaim.v]
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2026-09-23 review: I2C transaction verification, open protocol limits, and the mutation log-path fix
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2026-09-23 Pin budget: count demand by direction; correct the all-nine pin claim
    [pin_budget.py, tt_um_protocol_emulator.v]
2026-09-23 Pin budget: reclaimed shortfall is 3 — the third input takes the last uio
    [pin_budget.py]
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2026-09-23 serdes integration plan: per-direction enables and the stuffed-cell handshake
    Second review round on wiki/plans/serdes-integration.md (loopback follow-up):
    - pe_codec_mux's one bit_en gates TX and RX state in every stage, and
    pe_manch TX is purely combinational: the codec strobe is per encoded cell
    (payload or inserted stuff), never 2x half-cell; half_phase is an
    independent half-cell level.
    - pe_serdes's one bit_en clocks both sides; the plan splits it into
    tx_bit_en/rx_bit_en with payload-only gates grounded in the RTL:
    tx = tx_codec_cell_en && !tx_stuffed (hold, current-cycle),
    rx = rx_codec_cell_en && rx_bit_valid (skip).
    - Topology: two pe_codec_mux instances (TX/RX); alter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
2026-09-23 pe_ctrl readback audit: correct guard label and A2 frame event; pin the CS session
    Plan-only audit of wiki/plans/pe-ctrl-readback.md and
    reviews/2026-09-23/PE-CTRL-REVIEW.md against rtl/pe_ctrl.v and
    tb/tb_pe_ctrl.v:
    - H = 8 clk is 3.75 MHz at 60 MHz, not 2.5 MHz; 2.5 MHz is H = 12 clk.
    - A2's first echo bit is the fall after the next frame's 16th rise
    (33 half-periods = 16.5*T_sclk), not the following frame's 16th fall
    (31H = 15.5*T_sclk); A2's commit bound written discretely.
    - Contract: a CS falling edge starts a session (address 0, words_written 0,
    error clear, echo clear); A1/A2 trailing readback frames must stay in the
    same CS-low session. A3 hold bullet now says 2 clk - t_pad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
2026-09-23 docs: replace live diagram workflow with PlantUML maps
    [block_diagram.py, signal_glossary.py]
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2026-09-23 docs: correct pe_ctrl SCLK timing comment
    [pe_ctrl.v]
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2026-09-24 feat: define host image and PE frame contracts
    Test-first: 55 unittest cases in tools/host_gui/tests, run RED before the
    modules existed. protocol.py implements the plan frame (sync A55A, version/
    opcode/target header, seq, len, CRC-16/CCITT-FALSE) with typed frame errors.
    image.py assembles through tools/fw/peasm.py, refuses >1024 words, emits the
    canonical big-endian SHA-256 manifest, and warns when a short image lacks a
    terminal backward jump (review correction P23).
    [image.py, protocol.py, test_image.py, test_protocol.py]
2026-09-24 feat: add host transport, session, server and fake PE
    Plan Task 6 phase 1b, test-first (152 cases; 97 new). transport.py is the
    newline-JSON CDC layer (versioned monotonic ids, id-echoed responses, queued
    usb.disconnect/board.reset/spi.timeout/chip.irq/chip.status/protocol.error
    events, typed errors, abandoned-id handling; pyserial optional). fake_pe.py is
    an in-memory chip model + fake bridge implementing the framed protocol with
    protocol.py (LOAD words-written/faults/final-word echo, run-abort never
    committed, STATUS/READ_CPU/READ_IMEM/READ_DMEM/DUMP_CORE/CLEAR_FAULT/TARGET +
    loopback target 1, run=0 gating). session.py is the controller state machine
    (load/start/stop/dump gating, reconnec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
    [board.py, fake_pe.py, fakes.py, server.py, session.py, test_api.py, test_fake_pe.py, test_session.py]
2026-09-24 docs: record host GUI phase 1b result and resolve R0 decisions
    Phase result (date 2026-09-24T19:07:55Z): files, RED/GREEN evidence
    (152 tests; FastAPI path exercised in a throwaway venv), commands, and the R0
    decisions baked into the code. Review section 8 closes the uio[4] collision in
    favor of the plan mapping, transfers the A1 echo semantics into the framed LOAD
    response, records 5 MHz as the negotiated host cap, the backward-JMP terminal
    rule, and the LOAD/NOT_READY and aborted-load-clear decisions.
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2026-09-25 feat: add Pico USB SPI bridge
    Plan Task 2: MicroPython-compatible pe_frame codec (shared golden vectors
    read by the host protocol tests), TT SDK adapter behind a duck-typed HAL,
    and the newline-JSON USB endpoint with framed SPI sequencing, LOAD/run
    gating and IRQ polling.
    Host-side verification: 55/55 bridge tests (fake HAL, fake ttboard/machine,
    and a SerialTransport+ControllerSession loopback against the real bridge),
    34/34 protocol golden-vector tests, 154/154 host GUI tests, ruff and
    compileall clean. Found and fixed while resuming the interrupted edit:
    non-integer JSON arguments killed the bridge (now typed BridgeError); the
    concrete adapter's uio_oe_pico direction and CS_N framing had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
    [fakes.py, main.py, pe_frame.py, test_protocol.py, tt_adapter.py]
2026-09-25 docs: record host GUI phase 2 bridge result
    Plan Task 2 (/tmp/opencode/host-controller-gui tools/host_bridge/) is
    verified and committed at c28234d. Result doc: what the interrupted tree
    contained, the crash found in the resumed edit (non-integer JSON arguments
    killed the bridge; typed BridgeError now), the adapter SDK coverage and the
    host-over-real-bridge integration cases, exact commands and results, the
    board.connected/chip.irq rulings, and the honest limits (real Pico/USB
    unverified, chip-side RTL out of scope). HANDOFF note and plan-review
    section 9 point at the same evidence.
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2026-09-25 test: add host controller board acceptance
    Plan Task 7. acceptance.py runs one scripted sequence in two modes:
    --fake drives the real host stack (SerialTransport + ControllerSession)
    through the real PicoBridge against the fake SDK adapter and fake PE and
    never opens a serial device; --device PATH runs the same script against a
    real Pico and reports the dialout hint instead of a traceback when the
    device cannot be opened. Steps the current contract cannot observe (UART
    bytes; IRQ/faults before RTL phase R1) are SKIP with the reason, never a
    synthesized PASS.
    Dry run: python3 tools/host_bridge/acceptance.py --fake
    RESULT: PASS (16 PASS, 0 FAIL, 1 SKIP) - 118-word uart_echo assembly,
    load, re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
    [acceptance.py]
2026-09-25 docs: record host GUI phase 3 acceptance dry run
    Plan Task 7 --fake dry run is committed at f6fdd65 and passes 16 PASS /
    0 FAIL / 1 SKIP. Result doc: runner design, exact commands and outputs,
    RED/GREEN evidence, the UART and hardware-IRQ SKIP rulings (contract gaps,
    not passes), the STATUS.md deferral ruling, the OOM watch note (all runs
    bounded, 24 MiB peak child RSS) and the real-run limits. HANDOFF note and
    plan-review section 10 point at the same evidence.
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2026-09-25 feat: prepare host-side R2 read-path contract and acceptance gate
    Chip R2 (plan Tasks 3-5: full-width CPU debug ports, pe_imem host read
    port, SoC read mux with no-wrap range rejection, chip-side read-while-run
    rejection) is chip-side work and is NOT on the chip. This makes the host
    side ready to validate it the moment it lands, without claiming any
    chip-confirmed behavior:
    - tools/host_gui/r2_reads.py: seven named R2 read obligations, each a probe
    over the host model with chip_confirmed=False and an explicit
    NOT-CHIP-CONFIRMED note; the acceptance runner and (later) the chip TB
    read the same list so they cannot drift on what the read path owes.
    - FakePE(read_fault_policy="latch"|"sta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
    [acceptance.py, fake_pe.py, r2_reads.py, test_r2_reads.py]
2026-09-25 feat: eth-tx plan Tasks 1-5, R1 framed host protocol, hardening suites
    pe_eth_tx frame engine (56+8 prelude, LSB-first octets, pad-into-FCS, TX CRC32, IFG, runt/jabber refusal, 8-byte FIFO); pe_soc 32-entry 0xF window + TX owner mux + DIV=6; wrapper G6 uo_out[2] eth_tx pad mux (reset bit-identical); wire-loopback acceptance tb_pe_soc_eth_loop + pad-decode TB; 4 test firmwares; the pe_pinmux open-drain gate restored byte-exact from the mutation-harness snapshot after the 2026-09-24 18:43 kernel OOM left an unrestored mutate_i2c m1 mutant (sha256 c1fa0cec...); R1 framed host bus (pe_ctrl) + 4 new mutation suites + same-list updates. Verified: run_all --fast -j8 33/33 RTL, 26/26 firmware, lint,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
    [block_diagram.py, crc_config.py, floorplan_feasibility.py, pe_ctrl.v, pe_eth_mac.v, pe_eth_tx.v]
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2026-09-25 docs+fix: apply manager R2 read rulings and the same-turn chaining rule
    Manager RULINGs (WORKLOG 2026-09-25) settle the two R2 read questions:
    an out-of-range READ answers RANGE and latches sticky FAULT_RANGE (default
    latch, parameter kept so the rejected status-only behavior stays testable),
    and READ payload is low-word-first ascending like LOAD's stream. r2_reads
    now cites both rulings and the range_never_wraps probe asserts the sticky
    fault; two tests pin the ascending order and the latch+clear cycle.
    HANDOFF role section rewritten for the process fix: chaining happens WITHIN
    the same turn; the interrupt file is the manager's async review trigger,
    not the end of work (a pi session cannot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
    [r2_reads.py, test_r2_reads.py]
2026-09-25 feat: add /api/read_cpu route for the operator page
    The page can now read the live CPU register header while the core runs
    (READ_CPU is the one non-halting read). Api.read_cpu() returns a typed
    {"cpu": {...}} payload from the session's CpuSnapshot; the FastAPI route
    is GET /api/read_cpu behind the same guarded() error wrapper as the other
    reads.
    TDD: test_api watched RED (no Api.read_cpu) then GREEN; the FastAPI route
    assertion was exercised in the phase-1b venv where fastapi is installed
    (the system-interpreter skip is the without-fastapi path, as designed).
    host_gui 174 (system) / 174 (venv), bridge 65, acceptance --fake PASS
    21/0/1, ruff+compileall clean. Not chip-confirmed: READ_CPU is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
    [server.py, test_api.py]
2026-09-25 feat: acceptance proves the R2 read range -> sticky fault -> clear lifecycle
    The manager ruling (out-of-range READ latches sticky FAULT_RANGE,
    CLEAR_FAULT clears it) is now an end-to-end acceptance gate, not a silent
    side effect: r2_range reports the latch and the new
    r2_range_fault_lifecycle check drives the whole cycle over the session -
    bad read -> STATUS shows faults=0x0004 and the session goes FAULTED ->
    CLEAR_FAULT returns 0x0000 and the session heals to STOPPED - recording
    the state at fault time so the line is unambiguous evidence. The dry run
    is PASS (22 PASS, 0 FAIL, 1 SKIP).
    TDD: acceptance tests RED (missing lifecycle check) then GREEN (11/11).
    host_gui 174, bridge 66, r2 15, ru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
    [acceptance.py]
2026-09-25 feat: show the live CPU register header on the operator page
    The page now renders PC/A/X/Y/insn from the new /api/read_cpu route and
    polls it once a second while the session is RUNNING (READ_CPU is the one
    non-halting read), stopping the poll on stop/disconnect. renderCpu
    formats each register as 0xNNNN; a failed running read is ignored rather
    than spamming the message line.
    TDD: web-asset test RED (no cpu-pc) then GREEN (17/17); `node --check`
    validates app.js syntax. host_gui 175 (system) / 175 (venv), bridge 66,
    acceptance --fake PASS 22/0/1, ruff+compileall clean. The registers are
    R2 chip data, not chip-confirmed.
    [test_api.py]
2026-09-25 fix: surface chip faults on an idle/stopped session (close phase-2 limit)
    The Pico bridge samples IRQ_N only when a host request unblocks its
    readline, so a session that sent nothing never observed a chip fault - the
    phase-2 record's open "IRQ latency while idle" limit. The page now keeps a
    light status poll (2 s) running whenever the session is connected, not
    only while running, so a fault on a stopped board surfaces within one poll;
    the CPU poll stays 1 s and run-only.
    A new integration test proves the server/session half over the real bridge:
    a fault injected while stopped reaches the host as a chip.irq event on the
    next status poll, the session moves to FAULTED and last_fault is retaine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
    [test_api.py]
2026-09-25 docs: record the manager rulings and the same-turn host chain
    - R2-PREP: the two manager RULINGs (read-range latches sticky
    FAULT_RANGE, CLEAR_FAULT clears it; READ payload low-word-first
    ascending like LOAD), the same-turn chaining fix, and the chain itself
    (session/API/page read_cpu, the sticky-fault lifecycle gate, the
    idle-fault visibility fix) with final suite numbers.
    - Plan review section 13: the same, as the plan's status roll-up.
    - Phase-2 record: the open limit "IRQ latency while idle" is marked
    CLOSED host-side (3790fc3); hardware latency still to be measured.
    - STATUS.md: refreshed counts (176 host-GUI, 67 bridge, acceptance
    22/0/1), the R2 read-contract row, and the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
2026-09-25 fix: answer board/deployment failures instead of killing the serve loop
    A missing project, a dead project clock, an unconfigured host-SPI pin map
    or a reset/IO error used to raise out of handle_line and take the USB
    session with it (the phase-2 record's fail-fast limit). PicoBridge.handle
    now catches the adapter's OSError/RuntimeError and answers the request
    with a typed ok=false "board error during <op>: ...", so the bridge stays
    alive and a retry after the board is fixed succeeds with no poisoned
    state (the clock starts once, the project is not marked enabled). The SPI
    timeout path is untouched: _pe_request already converts transfer failures
    to BridgeError + spi.timeout before they can rea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
    [main.py]
2026-09-25 test: add a one-command host gate (run_host_tests.sh)
    Every host re-verify so far was a remembered list of five commands, and a
    remembered list is how a gate gets skipped or run against the wrong tree.
    tools/host_gui/run_host_tests.sh runs the full set in order - host_gui
    tests, host_bridge tests, ruff, compileall, and the acceptance dry run
    (acceptance.py --fake, no serial device) - and exits non-zero if any step
    fails, in the style of regress/lint.sh with a why-it-exists header. It is
    explicitly NOT a chip gate: no testbench, regression or synthesis, and no
    evidence about silicon.
    Verified it can fail: appending a raise to r2_reads.py makes the gate
    exit 1 and report [FAIL]; restoring the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
    [test_api.py]
2026-09-25 feat: export the R2 read verification package for the chip-side TBs
    The chip manager can now hand the protocol worker a machine-readable R2
    acceptance spec instead of a prose contract. tools/host_gui/r2_vectors.py
    derives every vector from the live FakePE model and the shared codec, so
    the artifact cannot drift from the host contract:
    reviews/2026-09-25/R2-READ-VERIFICATION.json - 8 vectors / 15 steps, each
    with the exact framed request bytes, request payload words, response
    bytes, response payload words, status, and the expected sticky fault
    register. Covers bounded IMEM/DMEM reads, the low-word-first ascending
    order (ruling), DUMP_CORE==STATUS, non-halting READ_CPU, full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
    [r2_vectors.py, test_r2_vectors.py]
2026-09-25 docs: fence the host blocks and add the merge note (merge-prep)
    Ruling (b): the merge is deferred to the chip manager and I am not
    rebasing, so this prepares MY side to be additive. Every host region in
    the three files that collide with the chip side is now fenced with
    BEGIN/END gui-worker host block comments (HANDOFF 2 blocks, STATUS 2,
    README 1), and reviews/2026-09-25/HOST-BRANCH-MERGE-NOTE.md states, per
    file, exactly how to combine them (keep both sides; a stated order; where
    each block may sit) plus the one-command post-merge verification and the
    things I deliberately did not do. The HANDOFF top block is refreshed to
    current numbers (host_gui 187, bridge 73, acceptance 22/0/1) so the m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
2026-09-25 fix: make the deployed bridge actually run on MicroPython (measured)
    The phase-2 limit "MicroPython deployment unverified" is now measured, and
    the bridge FAILED on a real MicroPython (unix port, commit 09f5bb4,
    1.30.0-preview). Five deployment-blocking issues, all fixed here:
    1. from __future__ import annotations -> ImportError: no module named
    '__future__'. MicroPython has no __future__, so main.py and
    tt_adapter.py would not have imported on a Pico at all. Removed from the
    deployed modules (acceptance.py keeps it - host-side only).
    2. [*events, response] -> SyntaxError: *x must be assignment target.
    Rebuilt without starred unpacking in a list display.
    3. keyword-only defs (de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
    [main.py, micropython_check.py, tt_adapter.py]
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2026-09-25 feat+docs: eth-tx plan COMPLETE (Tasks 6-7: mutation suites, STA screens, close-out)
    Task 6: regress/mutate_eth_tx_tb.sh (18 unit mutations) + regress/mutate_eth_tx_loop_tb.sh (7 integration mutations) wired into run_all as suites 11-12; 25 detected / 0 survived; the suite found and the TB fixed two real gaps (exact-60 pad case, engine-side IFG cell count). Task 7: 12 mapped STA screens (2 designs x 3 corners x ZERO/BOARD) - no new violation class; G6 pad uo_out[2] MET +7.6330 setup / +0.2964 hold (slow); synth unchanged (pe_eth_tx 892, pe_pinmux 127, pe_soc 6219, tt_um_top 7960 cells); plan Status COMPLETE; ETH-TX-FRAME-PATH-REVIEW.md record. Final: run_all 33/33 RTL + 26/26 fw + lint + 12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
2026-09-25 fix: R2 vectors to chip-native register widths (ISA is the source of truth)
    The chip-side R2 pre-flight caught the golden package encoding a 13-bit A
    (a = 0x1FFF) from the host model - a field no chip can produce. Manager
    ruling: the ISA is the source of truth and no field may lie.
    Widths, mirrored from rtl/pe_cpu.v:
    * a, x, y logic [7:0] -> 8 bits
    * pc logic [PCW-1:0], PCW=max(8,IAW); the SoC has
    IMEM_WORDS=1024 so IAW=10 -> 10 bits
    * insn 16-bit instruction word (imem_rdata) -> 16 bits
    "Full width" means every bit the ISA has (R2 must stop truncating the PC
    to 8 bits the way dbg_pc = pc[7:0] does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
    [fake_pe.py, r2_reads.py, r2_vectors.py, test_r2_reads.py, test_session.py]
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2026-09-25 feat: R2 read path complete (15/15 golden vectors byte-exact)
    pe_cpu native-width debug regs (full 10-bit pc, dbg_x/y/insn), pe_soc bounded read port, pe_ctrl opcodes 0x12-0x15 + 11-word R2 STATUS + sticky FAULT_RANGE + CLEAR_FAULT, wrapper wiring. Wire contract: WAIT-WORD rule (leading 0xFFFF filler during fetch, driven OE-on for hardware determinism; response starts at first non-0xFFFF word; R1 backward compatible at zero wait words; 15-word host timeout bound). tb_pe_ctrl_r2 consumes the gui-worker golden package ($readmemh streams + model image) byte-exactly incl. CRC - 15/15 steps PASS; registered as run_all case 34. Three real defects found+fixed: launch-branch skip, odd-count trailing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
    [pe_cpu.v, pe_ctrl.v, pe_soc.v, tb_pe_ctrl.v, tb_pe_soc_eth.v, tb_pe_soc_eth_loop.v, tb_pe_soc_eth_tx.v, tb_pe_soc_i2c.v]
2026-09-25 feat: flip the R2 package to chip-confirmed (15/15 byte-exact in simulation)
    Chip R2 is complete: the chip repo's tb/tb_pe_ctrl_r2 reports per-vector
    PASS for all 15 golden steps, byte-exact including CRC, with the model image
    loaded per vector and the session's 3-word LOAD replayed as a real framed
    frame. Evidence: the chip repo's reviews/2026-09-25/R2-READ-PATH-REVIEW.md
    ("Conformance: 15/15, per vector"). That run found and fixed three real RTL
    defects (dropped trailing dmem byte, never-fired response launch, an X on
    the MISO pad before the first frame).
    - r2_vectors.py: a CHIP_EVIDENCE map (confirmed step -> citation). A step is
    chip_confirmed ONLY if it is in that map, and only then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
    [acceptance.py, r2_vectors.py, test_docs.py, test_r2_vectors.py]
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2026-09-25 feat+docs: R2 mutation gate (37/37), harness snapshot fix, closeout records, missing TB sources
    8 new R2 mutations in mutate_ctrl_tb.sh (filler-not-ones, launch-unaligned, imem/dmem range-off, sticky-fault, not-ready, odd-flush, dumpcore-notready) - 37 detected / 0 survived. INCIDENT + FIX (self-caught): mutate_eth_soc_tb.sh now snapshots and cmp-verifies EVERY mutated file (MUTABLE="rtl/pe_soc.v rtl/pe_eth_mac.v") - an interrupted run could not restore pe_eth_mac.v before, the exact gap behind the 2026-09-24 18:43 OOM leftover mutant. Next-steps list reconciled (item 8 GUI LANDED+MERGED, item 10 R2 DONE, items 11-13 = real remainder). Adds previously-missed new files: tb/tb_pe_ctrl_r2.v, re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
    [tb_pe_ctrl_r2.v]
2026-09-25 feat: run_all single-run lock (flock, reentrant, fail-fast)
    regress/run_lock.sh: one mutation-capable run per worktree (flock on /tmp/chip-run-all.lock, process-based so SIGKILL releases it, CHIP_RUN_LOCK_HELD reentrancy so run_all's child harnesses do not self-deadlock). Wired into run_all.sh, all twelve mutate_*.sh and run_firmware_tests.sh; competing runs refuse with exit 75 naming the holder. Closes the concurrent-harness hazard exposed by the 2026-09-25 run_all_merge/worker-run overlap (documented in COLD-START.md). Verified: dual invocation refusal, lock release, full suite green under the lock (34/34 RTL, 26/26 fw, 12 suites).
2026-09-25 fix: implement the R2 wait-word skip in the SPI path (B1, chip review)
    BLOCKING bug found by the independent review of MY host code: the bridge
    did a fixed-length write_readinto and handed the result straight to
    decode_frame, with no wait-word handling - but the chip drives up to 15
    leading 0xFFFF filler words during a bounded read, so every READ_IMEM /
    READ_DMEM would fail to decode on real hardware while passing every host
    test (the model never emitted fillers).
    - pe_frame.strip_wait_words(raw, max_wait=15): leading-ONLY, bounded skip
    of 0xFFFF WORDS; raises FrameError if no real frame follows, so an
    all-filler stream becomes a typed spi.timeout, not a bogus decode.
    - tt_adapter.host_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
    [acceptance.py, fake_pe.py, fakes.py, main.py, micropython_check.py, pe_frame.py, r2_vectors.py]
2026-09-25 feat: cross-review closure - conformance 18/18 (ceiling + zero-count vectors), review minors
    Two new golden vectors (read_imem_at_ceiling_15, read_imem_over_ceiling, read_dmem_zero_count) PASS byte-exact - the 15-word/30-byte ceiling and count==0 -> RANGE rulings were already what the chip does (no RTL change). Per-vector CLEAR_FAULT precondition added to the conformance harness (vectors assume faults=0 at start; host-reachable way to the declared model state - not a relaxation). CHIP-CODE-REVIEW minors: #2 pinned in RTL comment, #3 X-propagation re-verified at reset boundary, #4 resp_buf slots correctly declined (resp_len bounds serialization). run_all exit 0: 34/34 RTL, 26/26 fw, 12 suites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
    [pe_ctrl.v, tb_pe_ctrl_r2.v]
2026-09-25 feat: fully confirm the R2 package (18/18 byte-exact on the chip)
    The three host-added golden steps (read_imem_at_ceiling_15,
    read_imem_over_ceiling, read_dmem_zero_count) now PASS byte-exact on the
    chip: conformance is 18/18, and the ceiling / count==0->RANGE rules needed
    no RTL change - the host model was the side that was corrected to match the
    chip. All 18 steps now carry chip_confirmed: true with a citation; the
    package and manifest flags are fully true, and the notice records that this
    confirms the RTL in SIMULATION while the real-board acceptance run is still
    unexecuted.
    CHIP_EVIDENCE gained the three step names, cites the review's 'Conformance'
    section (18/18) and tb_pe_ctrl_r2, and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
    [r2_vectors.py, test_r2_vectors.py]
2026-09-25 docs: runbook B1 -> RESOLVED, triage restored, items resynced
    The bring-up runbook's KNOWN ISSUE warned of the B1 transport bug as unfixed - but it was fixed minutes later (gui-worker, merged def51ea). Rewritten as RESOLVED (what B1 was, the fix location, the regression proving it) and the triage restored so an r2_read_* failure is treated as a genuine finding again. STATUS items 12/13 marked DONE with evidence; item 11 (real Pico/USB acceptance) is the only open item and it is board-gated. Process rule recorded in COLD-START.md: grep WORKLOG for the owner's TASK-DONE before reporting any item open.
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2026-09-25 test: wire the wait-word cross-check into run_all as a first-class gate
    regress/cross_check_wait_words.py now runs in every regression alongside the generated-page gates and fails loudly if the chip's filler and the host's stripper ever disagree (0..15 wait words, all-filler must raise). Full suite with the gate: exit 0, 34/34 RTL, 26/26 fw, 12 mutation suites.
2026-09-25 test: protocol fuzzer against both decoders and the chip-side model
    The demo and the judges WILL produce malformed frames, so tools/host_gui/
    fuzz_protocol.py hammers both ends of the protocol with hostile input:
    the host decoder and the MicroPython pe_frame decoder get random and
    corrupted chip frames (valid baseline, single-bit mutations, sync
    corruption, truncation at every length, extension, mid-word odd length,
    frame-after-frame, pure noise, all-filler), and FakePE gets hostile host
    requests (noise, truncated/bit-flipped frames, hostile length fields,
    unknown opcodes, the response bit set).
    Invariants, all treated as findings rather than test failures:
    1. no crash - a decoder raises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
    [fuzz_protocol.py, protocol.py, test_fuzz_protocol.py]
2026-09-25 docs: submission-readiness audit and the doc fixes it found
    Judge-eye audit of how a cold reader finds and trusts this entry, recorded
    as docs/submission-readiness.md with a per-area scorecard (entry point,
    licensing, submittability, reproducibility, demo story, honesty, cross-refs,
    wiki, host story) and a five-minute verify list.
    Fixed here (host-owned):
    * README status block predated the landed 10BASE-T TX path and the framed
    host bus (R1/R2) - it now names receive AND transmit, the host bus, and
    the read path, and points at the demo walkthrough;
    * the walkthrough's regression line said "10 mutation suites" (now 12) and
    the R2 row still said 15/15 (now 18/18, the fully-con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
    [test_docs.py]
2026-09-25 docs: cold-clone reproducibility audit; fix the two doc drifts it found
    The scorecard claimed reproducibility A; this proves it the way a judge
    experiences it. Cloned the GitHub REMOTE into a fresh /tmp dir (main @
    a60d32d) and ran ONLY the published commands from README.md,
    host-bridge-bringup.md, demo-walkthrough.md and the five-minute verify list,
    with no insider knowledge and no local state.
    All five verify commands PASS cold: peemu echo (PASS, .hex committed),
    acceptance --fake (22/0/1, exit 0), run_host_tests.sh (host gate PASS, clean
    self-skip of the optional MicroPython step), and regress/run_all.sh --fast
    (exit 0: TOTAL 34/34, FIRMWARE 26/26, 12 mutation suites OK, cross-side
    wait-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
    [test_docs.py]
2026-09-25 feat: hostile server/API fuzzer + soak RSS watch (two real defects fixed)
    fuzz_server.py: a seeded, bounded campaign over the surface the protocol
    fuzzer does not reach - the FastAPI routes, the ControllerSession state
    machine, a hostile/broken bridge (garbage, wrong ids, drops, oversize,
    ok=false, bad version) and concurrent/interleaved requests plus a
    websocket-style event poller. Wired into tools/host_gui/run_host_tests.sh.
    Its first RED run (seed 20260926) found two real defects, both fixed:
    * a transport failure during load left the session stuck in LOADING, so
    every later load was refused until a reconnect (load now restores the
    pre-load state; a timeout keeps its intention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
    [fuzz_server.py, session.py, soak_host.py, test_fuzz_server.py, test_session.py, test_soak_host.py, test_transport.py, transport.py]
2026-09-25 docs: host soak + server-fuzz record (22 min, 1.89M cycles, bounded)
    - reviews/2026-09-25/HOST-SOAK-API-FUZZ.md: the server/API fuzzer's RED
    findings (seed 20260926), the two fixes, GREEN evidence, and the complete
    22-minute soak series (1,891,812 cycles with --http; RSS flat after warmup
    at 57.3-57.6 MB, last-half slope 0.40 MB/h, independent samples +1.1 MB/h,
    live GC objects +511) plus limits
    - wiki/STATUS.md: protocol/server fuzzer and soak rows in the host tooling
    table; the record added to the list
    - HANDOFF.md: the host block records the soak verdict
2026-09-25 fix: formal runner memory budget + yosys serialization
    fv_run.sh: every yosys under ulimit -v (default 6 GB, FORMAL_MEM_KB override) and a flock (one yosys at a time). Two tempinduct runs diverged at 6+ GB today and tripped the RAM runaway brake (the same class as the 2026-09-24 wezterm-killing OOMs). A cap-kill exits ERROR with a truncated log = strategy signal (go inductive), never retry deeper. Smoke: pinmux depth-16 PROVED under the cap.
    [formal_pe_ctrl.v, formal_pe_eth_tx.v, formal_pe_eth_tx_reach.v, pe_ctrl.v]
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2026-09-25 fix: per-worktree run + formal locks (parallel-worker safe)
    Locks derive from git rev-parse --show-toplevel: concurrent runs in the same worktree still refuse (the original hazard), but parallel workers in separate worktrees no longer serialize against each other.
    [pe_eth_mac.v, pe_soc.v, signal_glossary.py]
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2026-09-25 style: project formatter over tools/fw/peasm.py (no behaviour change)
    The pi-lens project formatter rewrote the file in the worktree after the
    feature commit. Behaviour is verified identical rather than assumed:
    * all 17 programs in firmware/ still assemble BYTE-IDENTICALLY to their
    committed .hex images, which is the same check run_firmware_tests.sh makes
    on every run, so a formatter change that altered an encoding would fail
    there;
    * the four negative assembler cases are still REJECTED -- program over the
    word limit, jump past the operand field, LDM A above dmem, IO port above 15
    -- and so is the 2-token STM form whose second token is not A, which is
    the case t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
    [peasm.py]
2026-09-25 fix: restore R1 pad map (SCK on uio[7]) - committed mutant from an in-flight mutation run
    Commit 3d979ba (manager git add -A) swept up the mutate_eth_tx_loop 'SCK on uio[6]' mutant while a suite was mutating the tree; the pad map is uio[4:7] = CS_N/MOSI/MISO/SCK per the R0/R1 ruling. Caught by fw-bus's bisect (ecb2b13=green, 3d979ba=149,915 FAILs). The run lock covers runs but not commits - a pre-commit guard now refuses staged rtl/tb additions containing MUTANT.
    [tt_um_protocol_emulator.v]
2026-09-25 refactor: extract the golden-vector framework so R3 can reuse it
    R2 shipped its own generator. R3 needs the same machinery -- declare a model
    image, drive the live model, ship the image, export $readmemh files plus a
    manifest, and gate the artifact against drift -- so it now lives in
    tools/host_gui/vectors.py and each phase module is a configuration plus its
    vector list.
    THE LOAD-BEARING CONSTRAINT: the checked-in R2 artifacts stay BYTE-IDENTICAL.
    R2 is chip-confirmed (18/18 byte-exact in tb_pe_ctrl_r2) and the chip
    testbench consumes its hex export, so the extraction may not perturb one byte.
    Proof, not assertion:
    - `r2_vectors --check` reports "up to date" for BOTH the JSON package and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
    [r2_vectors.py, vectors.py]
2026-09-25 feat(R3): the debug-control wire contract, the FakePE state machine, Pico ops
    Host side of the R3 debug-control contract (manager dispatch 2026-09-25).
    NOT CHIP-CONFIRMED: the R3 contract is a chip-side DRAFT, so rtl/pe_ctrl.v has
    no R3 header yet and everything below is a model of what the chip owes, not
    evidence that it does. The opcode NUMBERS (0x21 DEBUG_STEP, 0x22 DEBUG_BP_SET,
    0x23 DEBUG_BP_CLR, 0x24 DEBUG_STATUS) come from the dispatch and are fixed; the
    response layouts, the table depth and the rejection rules are the host's
    provisional reading, enumerated for reconciliation in r3_reads.py.
    Wire: the opcodes land in both codec copies -- protocol.py and the MicroPython
    twin pe_frame.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
    [fake_pe.py, main.py, pe_frame.py, protocol.py]
2026-09-25 docs: BLOCK 3 findings + handoff (MIDI rate measured, receiver still red)
    BLOCK 3 is partial and deliberately UNCOMMITTED apart from this note. The
    MIDI transmitter is proven -- firmware/midi_xfer.pe's own record is dmem
    bytes=14 status_bytes=2 finished=0xA5, and a raw edge trace measured every
    half-bit at 16.283-16.433 us = 30,420-30,704 baud against a nominal 31,250
    -- while tb_pe_soc_midi.v cannot frame the stream. A red testbench that has
    never been seen to pass manufactures a green tick for a claim nothing checks,
    which is the failure mode this repo's own rules exist to prevent, so the TB
    and the WIP firmware stay untracked in the worktree and the branch stays
    green.
    This file exists s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
2026-09-25 feat: three cycle-accurate timing protocols (WS2812, servo, DHT11)
    Three new demo acts for the protocols where the waveform IS the
    specification: nothing on the wire gives a receiver a clock, so the value
    is a pulse width and a program one clock out is wrong.
    WS2812 800 kHz one-wire, GRB, 24 bits firmware/ws2812.pe 129 words
    servo 50 Hz frame, 1-2 ms, 5 positions firmware/servo_sweep.pe 84 words
    DHT11 start signal + 40-bit read firmware/dht11_read.pe 134 words
    All on pin 6 (the first unclaimed pad), all push-pull, all through the
    pin matrix, with no per-protocol hardware. Measured on the pads:
    WS2812 every 1-cell high for EXACTLY 48 clocks (800.0 ns, the data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
    [peasm.py, tb_pe_soc_dht11.v, tb_pe_soc_servo.v, tb_pe_soc_ws2812.v]
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2026-09-25 feat(R3): reconcile the debug model and golden vectors to the IMPLEMENTED contract
    The chip side of R3 landed (pe_cpu dbg_hold/dbg_step/dbg_next_pc, pe_ctrl
    opcodes 0x21-0x24, state 0/1/2/3, stop-before). This reconciles the host model
    and vectors against the real contract, read from pe_ctrl.v's four response
    builders rather than off the prose.
    My first pass was written against a DRAFT and was wrong in most of its
    specifics; the diff is the correction:
    * ONE breakpoint register, not a 4-slot table with a MAX_STEP_COUNT ceiling.
    BP_SET carries ONE payload word (the address), BP_CLR and STEP and STATUS
    take none, and STEP retires exactly one instruction.
    * The responses are the co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
    [fake_pe.py, r3_reads.py, r3_vectors.py, vectors.py]
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2026-09-25 test(R3): 34 tests, the R3 drift gate, and the R3-PREP record
    34 tests in three deliberately separate layers, so a model bug is not masked
    by the probes that use it: the FakePE encodings and handlers checked against
    the RTL directly; the r3_reads obligations; and the package's shape, drift
    gates and chip_confirmed discipline.
    The chip_confirmed tests are the point of the R2-PREP discipline carried
    forward: every step must be false, the package must be false, and a confirmed
    step must carry a citation -- so confirmation can never be asserted by hand.
    Also pins two things that were genuinely broken and would have stayed broken:
    * the obligation suite is ORDER-INDEPENDENT. run_all_probes sh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
    [test_r3.py]
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2026-09-25 fix(R3): the R3 debug fuzz campaign, and the unhandled 500 it found
    I added 4 bridge ops, 5 API routes and a new session state machine (DEBUG_HOLD /
    BP_HIT) and none of it was attacked by the hostile campaigns. The R2 precedent
    is the reason this mattered: fuzz_server's first RED run found two real defects
    (stuck LOADING, crossed wire replies). Closing that gap for the debug surface
    found a real one immediately.
    THE DEFECT (pre-existing, not introduced by R3). A caller value that cannot be
    encoded as one 16-bit frame word reached the payload encoder and raised a bare
    ValueError, which the API's error handler does not catch -- an unhandled 500
    where a 409 belongs. Confirmed by execution acro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
    [fuzz_server.py, session.py, test_session.py]
2026-09-25 docs(R3): record the manager ruling on the two rows, and the fuzzer-design rule
    Manager ruling 2026-09-25: the R3 vectors STAND. The response pc is the PC at
    the request, and insn is the landing word; the contract's §3 table is being
    corrected chip-side to match the RTL, and R3-VECTOR-BYTES.md is the conformance
    reference for tb_pe_ctrl_r3.
    The BYTES do not move, and that is proven rather than asserted: across all 26
    steps the request hex, response hex, status, response payload words and
    chip_confirmed flags are IDENTICAL to the previous commit, and every file in
    r3-hex/ is untouched. The only thing that changed is the
    spec_vs_rtl_discrepancies prose.
    The prose is worth changing anyway. U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
    [fuzz_server.py, r3_reads.py]
2026-09-25 wip: DS18B20 1-Wire act - write path verified, READ PATH INCOMPLETE (not in the regression)
    Block 2 act (a). Firmware and TB are committed as a checkpoint so the work is
    preserved, but this act is NOT wired into regress/run_all.sh and is NOT
    claimed to pass. The read handshake does not complete; see below.
    WHAT IS VERIFIED ON REAL RTL
    * reset pulse: line low 485.7 us (datasheet min 480), measured on the pad
    * presence pulse: the sensor model's low+release is found by the firmware's
    two edge-spin loops
    * write slots: 16/16 reconstructed from the pads by the sensor model
    * commands: 0xCC (SKIP ROM) and 0xBE (READ SCRATCHPAD) decode correctly,
    LSB first, from the wire - not ass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
    [tb_pe_soc_ds18b20.v]
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2026-09-25 fix: DS18B20 read handshake - dmem collision + LSB-first accumulate + fixed-timing read
    The read path desynced from the model's because of three independent defects,
    all now fixed and each documented in the source:
    1. dmem[10] was shared by the DELAY ROUTINE (its middle-counter target) and
    the protocol (the write command counter, then the read byte counter). Every
    delay overwrote the phase counter and the byte transition read whatever the
    delay left behind. The two now have DISJOINT dmem ownership: the delay owns
    9-15, the protocol owns 0-8. This is the same class as the two earlier slot
    collisions this act found; the general lesson is that a delay routine and the
    code tha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
    [peasm.py, tb_pe_soc_ds18b20.v]
2026-09-25 docs: record the DS18B20 read-rewrite state at the context flush (WIP, not green)
    The read handshake is NOT done. This records, for the continuation after
    /new, what is fixed, what remains, and the one new finding that decides it.
    Fixed and committed: the dmem collision between the delay routine and the
    protocol, the DHT11-style MSB-first accumulate applied to LSB-first 1-Wire
    data, and the read's edge-race (now a fixed-timing level sample).
    Remains: the fault is in the TB sensor model, not the firmware. The read
    cycle is ~32 us, so a model that holds a 1 longer than that never returns to
    ready and the slots bleed together. The latest uncommitted edit makes the
    model present the data on th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
2026-09-25 feat: UART rate flexibility as firmware - MIDI 31.25k running status, DMX512-A 250k
    Two protocols the SoC's shared tick cannot time, and the measured reason each
    one defeats it: a MIDI bit is 32 us against a 4.3333 us tick (7.38 ticks), and
    a DMX bit is 4 us, which is 0.923 of a tick -- too long to be measured at all.
    Both programs therefore use the timer zero times and build the bit cell from
    counted instructions: 1920 clocks for MIDI (31,250 baud) and 240 for DMX
    (250,000 baud), both landing on nominal to the clock.
    THE HEADLINE IS A CORRECTION. The previous handoff concluded that the
    transmitter was right and the testbench receiver was the defect. That was wrong,
    and it was wrong the sam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
    [tb_pe_soc_dmx512.v, tb_pe_soc_midi.v]
2026-09-25 feat: DS18B20 1-Wire act - read path correct, TB claims its checks, mutation gate 14->26
    The read path's remaining fault was two firmware bugs, not the model:
    - the read byte counter was initialised with STM 10, A -- dmem[10] is the
    DELAY ROUTINE's middle-counter target, the slot the write command counter
    was moved off one commit earlier -- and decremented at dmem[8], which
    nothing writes. The loop banked the two correct bytes and then, with 255
    slots left instead of 1, walked the byte index up until it banked over
    dmem[5] (its own index) and came back round to overwrite dmem[0..1].
    - the sample polarity was the WRITE slot's. In a 1-Wire read slot a one is
    the line LOW, and ph4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
    [peasm.py, tb_pe_soc_ds18b20.v]
2026-09-25 docs: restore the BLOCK 3 Limits section dropped in the findings rewrite
    My rewrite of FW-BUS-BLOCK3-FINDINGS.md silently deleted the ## Limits
    section. The pre-rewrite file carried it -- "Simulated and mapped evidence
    only. No synthesis or STA screen was run for BLOCK 3, because no RTL
    changed... No physical flow, DRC or LVS" -- and the replacement had zero
    mentions of limits, synthesis, STA, DRC or LVS.
    That matters more than a normal doc regression: without it a later reader
    can take "EXIT=0, 39/39 testbenches, 21/21 mutations" as sign-off when
    nothing has been through synthesis, timing closure or a physical flow. The
    expanded section also states the two things simulation cannot check he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
2026-09-25 fix: a performance claim of mine was false; measured it and corrected it
    tb_pe_soc_dmx512.v's header and the findings file both asserted that
    reusing the MIDI receiver's free-running strobe "would have cost 5.7
    million strobe events across 22.6 ms of frame -- the testbench would have
    spent more time on its own sampler than on the DUT".
    Measured, that is false by a factor of 125. The comparison was built and
    timed instead of left as arithmetic: the same testbench plus a free-running
    1/8-bit strobe across the whole frame fires 45,753 strobes, not 5,700,000,
    and runs in 27 s against this one's 28 s -- no measurable difference. The
    5.7 M came from scaling 22.8 ms by a nanosecond-scale interval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
    [tb_pe_soc_dmx512.v]
2026-09-25 fix(R3): correct the two host-side vector defects the chip's conformance run proved
    tb_pe_ctrl_r3_conf is GREEN 26/26 with three pinned divergences in which the
    CHIP is right. I verified all three against the RTL before changing anything,
    and the chip is right on all three.
    1. read_cpu_shows_a_55 -- HOST defect, two payload words. The READ_CPU builder
    put the debug STATE in the slot the contract gives to RUN: pe_ctrl's
    OP_RDCPU is `resp_buf[6] <= {15'b0, run}` and the R2 header agrees. It
    agreed with run only while no hold was asserted and silently disagreed the
    moment one was (state 2 vs run 0) -- the exact word a debugger reads to
    decide whether the core is executing. It al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
    [fake_pe.py, r3_vectors.py, test_r3.py]
2026-09-25 docs(R3): state BOTH halves of stop-before, and name the failure mode
    A sweep after the conformance corrections found that every description of
    stop-before in this tree was still TRUE but all of them were INCOMPLETE, and
    that incompleteness is exactly where the model bug lived.
    Every one of them said only the negative half -- "the instruction AT the
    breakpoint has not executed" -- which is correct. None said that the step
    itself retires an instruction. So the host model could skip the execute
    whenever the landing address matched, withholding the STEPPED instruction
    instead of the breakpoint's, without contradicting anything written down.
    The chip's conformance run is what caught it.
    The te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
    [fake_pe.py, r3_reads.py, r3_vectors.py, test_r3.py]
2026-09-25 fix: the MIDI receiver oversamples at 8x, and three files said quarter-bit
    Second self-inflicted false claim this session, and this one has a root
    cause worth recording rather than just a correction.
    tb_pe_soc_midi.v oversamples at 8x -- OVERSAMPLE = 8, 4000/8 = 4 us, an
    EIGHTH-bit strobe. Three committed places described it as a "quarter-bit
    strobe": tb_pe_soc_dmx512.v's header, the findings file, and one MAIN
    WORKLOG entry.
    The cause was not loose prose. The receiver's interval variable was NAMED
    `quarter` while holding a bit divided by eight, and the name propagated
    into the description until reading the code could not tell you which was
    true. So the variable is renamed `quarter` -> `ov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
    [tb_pe_soc_dmx512.v, tb_pe_soc_midi.v]
2026-09-25 feat: NEC infrared act - 38.049 kHz carrier fitted to the clock, frame decoded off the pin
    The only act here with no wire: the receiver has to find a 38 kHz burst and
    time the silences between bursts, and nothing resynchronises to anything.
    Measured off the pin: carrier 38,049 Hz (+0.128 %), the two half periods
    788 and 789 clocks, leader 8988 us in 343 cycles, leader gap 4504 us,
    eight data bursts of 552 us, four long and four short gaps, stop burst
    552 us, decoded a5.
    Five firmware defects, all invisible from the waveform's shape alone, and
    the eight-bit immediate bit twice:
    - LDI A, 342 assembled to LDI A, 86, so the 9 ms leader was 2.3 ms, and
    LDI A, 529 assembled to LDI A, 17, so t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
    [peasm.py, tb_pe_soc_ir_nec.v]
2026-09-25 docs: the break and mark figures are two true numbers about two intervals
    Applying the cross-check I recommended one commit ago -- compare artifacts
    that state the same quantity -- to the rest of this block's numbers turned
    up a fourth case where NOTHING WAS FALSE and the two files simply
    disagreed:
    firmware/dmx512.pe header tb_pe_soc_dmx512.v measured
    break 22 cells = 88.0 us 88.06 us
    mark 3 cells = 12.0 us 12.38 us
    A 0.07% gap on the break and 3.2% on the mark. Both figures are correct
    and they measure different intervals. The header states what the LOOPS
    hold the line for. The testbench measures the break from the fall to the
    first rise (loop plus the 4 clocks o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
    [tb_pe_soc_dmx512.v]
2026-09-25 docs: record WHICH assertion catches midi-cell-padding-nop, measured
    Being wrong about an explanation is the same defect as being wrong about a
    number, and I had asserted an explanation without checking it: that
    midi-cell-padding-nop is caught by the "every cell measures the same" spread
    assertion rather than by the rate window, on the grounds that one padding
    NOP is one clock = 0.05% against a +/-0.3% window.
    The harness prints one verdict per mutation and cannot distinguish which
    check fired, so the attribution is silent in the gate by construction. Ran
    it by hand: with the fourth NOP in sb_start the run produces EXACTLY ONE
    failure --
    FAIL: every cell is the same length (the measureme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
2026-09-25 wip: stepper step/dir ramp act - NOT GREEN, deliberately not wired in
    The ramp is exact on 8 of its 10 step intervals, measured as an equality
    against 5110 clocks rather than a tolerance: 1661.133 us falling to
    809.501 us, 12 pulses, 12 distinct periods, all strictly shortening.
    Two faults are open and are stated in the record rather than smoothed
    over. Two intervals around the direction change are off by a matched pair
    of 373 clocks, so the setup delay is landing one interval later than it
    belongs -- not root-caused. And the direction-change setup-time check is
    not running at all: its first version searched only the first DIR edge,
    which is the pin-matrix init rather than the flip, so it w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
    [peasm.py, tb_pe_soc_stepper_ramp.v]
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2026-09-25 fix: the DMX slot count is a second witness, not the defence against a bad slot
    I overstated what the dmem count check does, in two places in
    tb_pe_soc_dmx512.v, and both were falsifiable by inspection:
    "a receiver that loses a slot still sees a valid pattern. The count is
    therefore checked as a COUNT"
    "a transmitter that dropped a slot would still produce a valid-looking
    pattern, and only a count gives that away"
    Both halves are wrong. The ramp is 0, 1, 2, ... so one wrong or missing slot
    makes every later value wrong, and the PER-SLOT comparison catches it
    immediately. Running the dmx-ramp-steps-by-two mutation by hand shows exactly
    which assertion fires: hundreds of "slot N is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
    [tb_pe_soc_dmx512.v]
2026-09-25 fix(harness): the run lock owns its process tree; a masked R2 oracle bug; an honest MEM label
    THE LOCK LEAK. flock releases when the holder dies, but the holder's CHILDREN do
    not die with it: they inherited fd 9, so the lock stayed held AND a mutation
    harness kept mutating and restoring RTL in a tree that had moved on - with no run
    left to explain it, and the next run refused for "a lock nobody is holding". Not
    hypothetical: the suite that finished mid-task left its own holder note behind,
    because chip_release_run_lock removed a hard-coded SHARED path while the lock
    itself had moved to a per-worktree one.
    THE FIX, in three parts. Isolation: the holder puts itself in its own process
    group, s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
    [tb_pe_ctrl_r2.v]
2026-09-25 fix: the mutation gate scored hangs the same as assertion failures
    The gate's contract is "each TB must catch every mutation that applies to
    it", and it decided that with `grep -qE "^PASS" "$LOG"` -- everything that
    does not print PASS was "detected". That silently conflated two different
    outcomes:
    * an ASSERTION failed evidence that the testbench TESTS the firmware,
    which is the entire point of a mutation gate
    * the testbench HUNG the run hit its watchdog or the 300 s timeout --
    evidence only that the testbench would not ACCEPT
    the image, which proves nothing about the checks
    Confirmed by construc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
2026-09-25 test(R3): pin BOTH halves of the insn rule my READ_CPU fix introduced
    Correcting READ_CPU needed an asymmetry in what `insn` reports: the FETCHED
    word while a debug hold is asserted, the LATCHED register otherwise. Only the
    held half was tested. The un-held half is the one nobody would think to
    protect, and it is load-bearing for the CHIP-CONFIRMED R2 package.
    The trade-off, established by running the real vectors rather than reasoning
    about them: both R2 READ_CPU vectors preload insn=0xFFFF and expect it back,
    while the word their fetch address would give is different in both cases --
    0x0041 for v04 (running, pc=1023, whose landing address wraps to 0) and
    0x0000 for v05 (boot stop, which f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
    [test_r3.py]
2026-09-25 feat(R3): the debug act -- a judge-facing story, wired as an acceptance sequence
    Debug control is the thing you cannot do with peemu.py: the chip is stopped by
    a host command, on a real instruction boundary, over the same framed bus as the
    load. That story was missing from the judge-facing doc, and the existing six
    r3_* cases were independent probes rather than a narrative a judge could follow.
    THE ACT, as seven visible beats in acceptance.py -- so a failure names the beat
    that broke instead of collapsing the whole act:
    1 arm DEBUG_BP_SET(2) over the host bus; the 5-word prefix reads the
    address back with bp_flags=0x01
    2 run+hit raise the strap; the core advances unti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
    [acceptance.py, test_docs.py, test_r3.py]
2026-09-25 feat(R3): flip chip_confirmed=true for the 25 confirmed steps, with citations
    The chip's citations are recorded, so the steps its conformance run covered are
    now confirmed. `status_full_readback` stays FALSE.
    THE FLIP IS A CITATION, NOT AN ASSERTION. The confirmed set is an EXPLICIT
    list of 24 names covering 25 steps, not a derived "everything except the
    boundary" -- a derived rule would silently confirm any step added later
    without the chip ever having run it. Citations: chip repo
    `reviews/2026-09-25/R3-CONFORMANCE-AND-RUN-LOCK.md` and
    `tb/tb_pe_ctrl_r3_conf.v`, with the harness and the divergence-list mechanism
    described in full.
    25 of 26 confirmed. The package-level `chip_confirmed` sta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
    [acceptance.py, r3_vectors.py, test_docs.py, test_r3.py]
2026-09-25 test(R3): hold semantics asserted; the last divergence stays pinned, now with proof
    The dispatch was to model HOLD semantics for the held-core steps so `insn` is
    deterministic, and to flip the last step if it then passed.
    THE MODELLING LANDED AND IS ENFORCED. tb_pe_ctrl_r3_conf now asserts, on every
    held-core step, that the chip's reported `insn` is imem[pc] - a claim about the
    CHIP, decidable with no model freeze, and one the golden vectors already implied
    (v04 pc=1/imem[1], v07 pc=2/imem[2], v09 pc=3/imem[3], v11 pc=0/imem[0]). All 25
    confirmed steps are preserved unchanged; the gate stays green.
    status_full_readback STILL DIVERGES, so it stays pinned and neither side was
    bent - but the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
    [annotate_r3_confirmations.py, tb_pe_ctrl_r3_conf.v]
2026-09-25 docs: the first synthesis screen for the R3 phase, and a claim of mine corrected
    wiki/STATUS.md gains the phase's first screen (exit 0, no diagnostics) with
    today's mapped counts and the R3 delta measured like for like: pre-R3 sources
    from git, same liberty, script and source list. pe_cpu +24 cells, pe_ctrl +283,
    pe_soc +21 cells / +148 um2 (+0.3%) - one breakpoint register, its comparator, a
    hold, a step pulse and four response shapes. The no-STA-screen note for this
    phase is carried forward; no physical flow, DRC or LVS.
    A CORRECTION, to a claim of mine. I had written that the baselines in the reviews
    were "R1-era" and not comparable. The accurate statement is worse for my own
    argument an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
2026-09-25 feat: stepper step/dir ramp act - ramp exact to the clock, wired in
    The only act here that drives a mechanism: the driver's edge count IS the
    motor's position, so there is no acknowledgement and nothing to
    resynchronise to. Every step period is an exact instruction count measured
    on the pin and the ramp is exactly linear to the clock -- the firmware
    subtracts ten outer steps of the (4,40) pair, 5110 clocks, per step, so
    the constancy is in the program rather than assumed about a table.
    Measured: 1661.133 us falling to 809.501 us (602 Hz to 1235 Hz), 12
    pulses, 12 distinct periods, all strictly shortening, direction changed
    once mid-ramp with 6.00 us of setup.
    The two faults the WIP checkpo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
    [peasm.py, tb_pe_soc_stepper_ramp.v]
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2026-09-25 docs: the three input-capture acts in the walkthrough and STATUS, and a corrected regression claim
    Block 1's precedent documented its acts with measured numbers; Block 2's
    three had none. Adds a section for DS18B20, NEC IR and the stepper ramp
    with the numbers measured on real RTL, the three lessons worth demoing,
    and a cost table with wall times measured rather than estimated.
    Also corrects Block 1's own stale regression line: RTL 34/37 with three
    pre-existing eth failures, which the merge onto main resolved, so it now
    points at the current 43/43 rather than leaving a number that is wrong.
    And fixes wrong arithmetic in a comment beside a fitted constant: ST_SETUP
    read '6 * 69 + 4 = 418' w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
    [peasm.py]
2026-09-25 fix: scope every /tmp path in this harness per worktree
    regress/run_lock.sh takes a PER-WORKTREE lock on purpose -- its own comment
    says "concurrent runs in DIFFERENT worktrees are safe (disjoint files)" -- so
    parallel suites in different worktrees are the DESIGNED case. But every path
    this harness wrote was a bare /tmp name, and /tmp is shared across worktrees.
    Two parallel suites each ran it and each wrote /tmp/mutate_fwbus_case.log;
    whichever finished last won.
    Observed directly rather than reasoned about. After a full green run of MY
    suite I read /tmp/mutate_fwbus.log and it reported "detected: 12" in the
    pre-a39caba format, while the same run had just printed 21 in the new format
    stand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
2026-09-25 docs+tb: put the /tmp collision in the canonical report; make a hang diagnostic
    Two gaps, both mine, both found by auditing what the last turn produced.
    1. The /tmp worktree collision (cd9bbfe) existed only in a commit message --
    0 matches in the findings file -- and it is the most TRANSFERABLE thing in
    this block, because it is about the parallel-worker infrastructure rather
    than about MIDI or DMX. Now written up there, including the part I am
    least proud of: I dismissed the wrong number once as a stale log and then
    wrote a WORKLOG correction asserting it WAS stale, which was itself wrong.
    It was never stale. "Stale" and "someone else wrote it" both explain a
    wrong num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
    [tb_pe_soc_dmx512.v]
2026-09-25 tb: give the MIDI watchdog a diagnostic, and say honestly how rarely it fires
    The DMX testbench got a real hang diagnostic last commit, in a comment
    saying "a hang is the least informative failure a testbench can emit" --
    while this testbench still printed only "FAIL: watchdog" and a bare byte
    count. My own new comment condemned my other file.
    It now reports bytes accepted of expected, candidates rejected on their
    stop bit, and the measured cell if any frame survived (or says plainly
    that the cell was never measured, which IS the diagnosis when no frame
    passed its stop bit).
    One correction while doing it, in the direction of claiming LESS. I first
    wrote this as though the test had three co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
    [tb_pe_soc_midi.v]
2026-09-25 wip: frequency + duty meter TB - RED, compiles and fails with named checks, no firmware yet
    Block 3 act (b), RED-first: the testbench exists, elaborates on real RTL
    and fails for the right reason, which is the state the discipline asks
    for before the firmware is written.
    The act is capture-only by design: the pin is an INPUT, the generator
    knows the sweep table and nothing else, and the receiver measures edge
    times off the pad. Sixteen points from 100 Hz to 10 kHz with a varying
    duty, every point checked rather than the endpoints, and the 100 Hz point
    is the one that tests the 16-bit claim -- a 10,000 us period does not fit
    in one byte, so a firmware counting into a byte reports 39 us for a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
    [tb_pe_soc_freqmeter.v]
2026-09-25 fix(formal): pe_soc C2 is now unbounded; the four pe_ctrl claims get an honest toolchain-gap note
    Two chip-side follow-ups from the R3 closeout. No RTL behaviour change - the only
    edits under rtl/ are mutant text, which the harness restores and byte-verifies.
    CLOSED -- pe_soc C2 (the F2 set-side guard) is now UNBOUNDED. It was proved only
    at the gate depth and labelled "not closed by induction". That label was WRONG
    about this claim: reading pe_soc.v shows fv_set_took and fv_ser_busy_seen clock
    from the SAME edge of the SAME always block, both sampling the same ser_tx_busy
    wire, so the claim is a one-step property of the guard's own update equations --
    no history, no snapshot to drift -- an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
    [formal_pe_soc.v]
2026-09-25 fix: my own classifier produced a false attribution, reported upward as fact
    Last turn I reported "21 detected, 1 by hang/timeout only" and named
    i2c-no-stop as the hang. That was wrong, and the wrongness was mine: the
    classifier I had added in a39caba matched the "FAIL: watchdog" PREFIX
    ALONE, and two testbenches print that line for entirely different things.
    tb_pe_soc_dmx512.v an UNBOUNDED 30 ms backstop -- a real hang
    tb_pe_soc_i2c_adv.v a BOUNDED 144,000-clock wait that EXPIRES, prints,
    and carries on to its real assertions
    So i2c-no-stop is not a hang. The bounded wait expires and the testbench
    then fails check(n_stop == 1, "one STOP, got 0") like any oth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
2026-09-25 docs(formal): per-claim record for the pe_ctrl helper-invariant attempt (gap stands)
    The manager authorised a helper-invariant design for the four pe_ctrl claims under
    a hard anti-circularity bar, and accepted the gap-list outcome. I attempted it
    honestly: extracted a NON-CIRCULAR RTL justification per claim (every walking
    entry loads r_slot<=1 at the same edge, pe_ctrl.v:994/1017; R_WAIT increments
    r_slot and decrements r_left, 1221-1229), then tried a history-bit helper for
    claim 1 and a re-accept-exclusion for claims 2/3. Every one is NOTPROVED.
    The gap is now sharper than "no reachability". The failing model carries TWO
    independent sampled copies of the same register -- dbg_step_r[0:0]#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
2026-09-25 chore: formatter reflow of r3-sta analyze_hold.py + regenerated formal summary
    - analyze_hold.py: quote normalisation + a blank line from the project formatter.
    - formal/results/summary.txt: the current formal record from the re-run (8 proved,
    0 failed; pe_soc_owner_guard now PROVED induct). MEM peak numbers move run to run.
    WORKLOG.md is left dirty on purpose: its uncommitted line belongs to fw-bus, not me.
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2026-09-25 docs(formal): measured negative - the pe_ctrl claim reformulations do not close either
    The pending decision (reformulate the four pe_ctrl claims?) is a claim-authoring
    call, so I measured the reformulations instead of leaving it open. The obvious
    ones FAIL: claim-4 compared against the CURRENT fv_resp_len (lagged snapshot
    removed entirely) still fails SMT induction at k=3 and k=6; claims 2+3 reduced to
    the accept-loaded bound only also fail.
    The current-length reformulation is the sharpest negative: even with the lagged
    snapshot gone, the free observation-port register fv_resp_idx is an independent
    state bit, so the induction antecedent is met with an unreachable value. And
    yosys-smtbmc -i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
2026-09-25 test: give the mutation gate a classifier self-test that runs every time
    The verdict rule is now factored into run_tb_verdict and exercised by a
    five-case self-test that runs BEFORE any score is produced. If it fails,
    the harness exits non-zero and prints no score at all.
    Why this exists, and it is the second time in this file that a mechanism
    of mine produced a wrong number nobody could see. The first version of
    the verdict matched the "FAIL: watchdog" PREFIX alone, scored a bounded
    wait that expires exactly as it scored a genuine unbounded hang, and
    reported "1 of 21 by hang" when the truth is none. Caught only by reading
    the wait instead of trusting the number. A classifier is an asserti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
2026-09-25 fix(formal): reformulate the pe_ctrl slot-overrun claim to unbounded (mutant-kill bar met)
    Manager ruling: the snapshot registers are real flops with their own update
    rules, so binding a claim to its load source is an RTL fact, not circular - and a
    reformulation is accepted only if (1) the antecedent is an independently k=1-
    provable RTL fact, (2) it still kills every mutant the old claim killed, and (3)
    it kills NEW mutants of its own scope. Weakening a claim to unbounded is worse
    than the gap. Engine: z3 SMT induction (two-engine validation holds).
    ACCEPTED - C1, response-buffer slot overrun:
    old: walking => r_slot != 0 (failed on an arbitrary pre-state)
    new: accepted R_START => r_s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
    [formal_pe_ctrl.v]
2026-09-25 docs(review): complete the R3 host cross-review with the demo act (F2, F3)
    My first pass predated the 5b4731f merge and left the demo act unreviewed; the
    manager pointed me at docs/demo-walkthrough.md's debug-act section and the
    r3_demo_* beats in tools/host_bridge/acceptance.py, and both are now covered.
    WALKTHROUGH: PASS, and the clearest contract statement on the host side. Beat 3
    asserts state=3 AND run=1 ("the hit holds the core, it does not drop the run
    strap") - my S3 live-hit semantics exactly. Beat 4 states the READ_CPU last word
    is the run strap and credits the chip's conformance catch. Beat 5 states my §3b
    correction exactly ("a visibly changes ... the instruction at the breakpo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
2026-09-25 fix(R3): F1 -- the shipped notice claimed the opposite of the package's flags
    The shipped r3-hex/manifest.json and R3-DEBUG-VERIFICATION.json carried a
    PACKAGE_NOTICE saying "every step is chip_confirmed=false", which has been false
    in the very same file since 25 of 26 steps were confirmed. The rulings entry
    was worse: it said "every step is chip_confirmed=False" on the same line as
    "26/26 byte-exact, 25 with no divergence" -- self-contradicting inside one
    string.
    ROOT CAUSE, and it is the part worth keeping: the drift gate STRUCTURALLY
    cannot catch this. The notice and the flags are generated from the same source,
    so a fresh build faithfully reproduces the same stale prose and `--check` pa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
    [r3_vectors.py, test_docs.py, test_r3.py]
2026-09-25 docs(R3): the held-core trap in both operator docs, and correct my own review
    An operator must never strand a held chip, so the release rule is now in both
    places an operator or a judge will actually read.
    docs/host-bridge-bringup.md gains a triage row -- "chip is stopped and will NOT
    restart, and the run strap looks correct" -- and a short section, "If the chip
    will not restart: the run strap is not the answer". It states the thing that
    makes this a trap rather than a rule: while a debug hold is asserted the
    execute gate is `cpu_exec = dbg_step || (run && !dbg_hold)`, which masks the
    run strap in BOTH directions. So the two reflexes that work for every other
    stalled state do not work here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
2026-09-25 fix(R3): action-list dispositions M1/M2/M4/L1 from the gui-worker chip review
    M1 VERIFIED CORRECTED, no change. Contract §3 rows 11/13 ARE corrected in the table
    BODY (row 11 -> pc=3, the PC at the request; row 13 -> insn = the landing word),
    not only in the changelog, and the file is clean three ways: working tree == HEAD
    == origin/main. Checked rather than assumed; editing an already-correct table
    would have added noise, so it is recorded as verified instead.
    M2 RECORDED PER VECTOR. The conformance TB preloads debug registers
    hierarchically, so a pre-state can encode an unreachable state. A reachability
    table now heads tb_pe_ctrl_r3_conf.v, classifying all 14: 7 reachable from reset
    (+/-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
    [pe_ctrl.v, tb_pe_ctrl_r3_conf.v]
2026-09-25 test(R3): M3 - cover the R2 STATUS debug-state surface that no vector exercised
    The reviewer noted R2's STATUS/DUMP_CORE now report states 2/3 but no R2 vector
    exercises that surface. Scoped down, the real gap is ONE cell: tb_pe_ctrl_r3
    already drove OP_STATUS in state 0 (C12) and state 2 (C13), but the live-hit case
    read DEBUG_STATUS (0x24), so a chip that reported the debug states correctly on
    0x24 and wrongly on 0x11 would have passed everything.
    New case: drive OP_STATUS while the core is held on the breakpoint and assert
    state=3, run=1 (the hit holds the core, it does not drop the strap) and pc=2.
    Green, and RED-proven - flipping the expected state to 2 makes the case fail, so
    it asser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
    [tb_pe_ctrl_r3.v]
2026-09-25 chore(WORKLOG): record M3 close and the fw-timing-owned suite regression (not mine)
    The full suite returned EXIT=1; the only six failing TBs are fw-timing's
    timing/input-capture acts, which arrived with the manager's merge 5b4731f (a
    descendant of my last green 6da4100, where none of the six existed). My commits
    touch nothing in their dependency chain, and fw-timing's own 20:35 log records
    them BLOCKED mid-Block 3 with RED TBs committed. Their files, not mine to fix.
    My R3 gates are green: conformance 14/14 vectors, 26/26 steps.
2026-09-25 feat: input frequency + duty meter act - capture-only, on the pin, in the regression
    Block 3 act (b), the first act in this repository whose pad is an INPUT. The
    other six timing acts all DRIVE a pin; this one LISTENS, so the number that is
    the claim is the accuracy of a COUNT rather than the accuracy of a delay, and
    the honest way to state it is per point: the timebase is one microsecond, so
    the relative error is 1/period - 0.01 % at 100 Hz and 1.0 % at 10 kHz. The
    tolerance is therefore 1 % of the period with a floor of 1.5 ticks, and at the
    fast end the tolerance is the dominant term. A single accuracy number would be
    a false claim at one end or the other.
    THE DESIGN IS CAPTURE ONLY, and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
    [peasm.py, tb_pe_soc_freqmeter.v]
2026-09-25 fix(R3 fallout): a debug input with no driver held the core at reset -- the six timing acts could not run
    MERGE-REPAIR. Six acts (WS2812, servo, DHT11, DS18B20, NEC IR, stepper) fail
    in main with dmem = xx and zero edges. The cause is NOT in any of the six
    acts: every one of their twelve files (six .pe, six .hex, six TBs,
    tools/fw/peasm.py) is BYTE-IDENTICAL between main and the branch they were
    verified on, and that was checked by object hash, not by eye.
    The cause is the R3 debug-control block, which added two MODULE INPUTS,
    dbg_hold and dbg_step, to pe_soc and pe_cpu. A testbench that predates them
    leaves the ports unconnected; the port arrives as Z, `!dbg_hold` is X, and
    the core's sing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
    [pe_cpu.v, tb_pe_soc_dht11.v, tb_pe_soc_ds18b20.v, tb_pe_soc_freqmeter.v, tb_pe_soc_ir_nec.v, tb_pe_soc_servo.v, tb_pe_soc_stepper_ramp.v, tb_pe_soc_ws2812.v]
2026-09-25 feat(R2): the held-core STATUS steps - the surface the R2 package never ran
    R2's STATUS/DUMP_CORE report the same 2-bit state word R3 made reachable, so
    states 2 (DEBUG_HOLD, a step-pause) and 3 (BP_HIT, a live hit) are now states
    the R2 golden package could be wrong about. The chip review filed exactly that
    as MEDIUM 3, the chip closed its half (M3), and the golden-package half was
    still missing: a chip right on the boot stop and the free-running core, and
    wrong on both held ones, passed 18/18.
    Four new steps, in the package shape, from the frozen contract semantics:
    status_reports_the_hold state=2, run=0, pc=1
    dump_core_answers_the_same_header the identical 11-word hea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
    [r2_vectors.py, test_docs.py, test_r2_vectors.py, vectors.py]
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2026-09-25 fix(R2): the host readback threw away the chip's own state word
    Landed the R2 held-core golden steps and the first thing they broke was on my
    side of the boundary: the host could not OBSERVE the states they pin.
    TWO INSTANCES, ONE DEFECT. `session.status()` mapped the state machine from the
    `run` word ALONE, so a core parked on a breakpoint (state=3, run=1 - exactly
    golden step `status_reports_the_hit`, and exactly the chip's own M3 case) read
    as RUNNING, and a step-pause (state=2, run=0, golden step
    `status_reports_the_hold`) read as a plain STOPPED. The GUI's "Chip state" field
    then collapsed the same four-value word to two labels with
    `status.state === 1 ? "RUNNING" : "STOPPED"`, so the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
    [session.py, test_chip_state_js.py, test_session.py]
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2026-09-25 fix(R2): the GUI's buttons and polls now follow the state word, not a two-value guess
    The direct consequence of d3cff8a: widening session.status() to the chip's state
    word means the POLL path can now deliver DEBUG_HOLD/BP_HIT, and every piece of
    app.js keyed on 'RUNNING'/'STOPPED' changed behaviour without anyone deciding
    it. So I asked the two implementations of the same policy the same question.
    MEASURED, not assumed. `tests/test_gui_capabilities.py` puts the real
    ControllerSession on a real FakeBridge, walks it into all six states, and asks
    which operations it accepts - a FRESH stack per operation, because a successful
    call changes the state the next one sees. (The first version of that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
    [test_gui_capabilities.py]
2026-09-25 fix(R2): finish the capability audit - the debug panel, and two states nobody had tested
    Same method as 9ee8d00, applied to the four debug buttons, and adding the two
    states the previous table did not contain. The table now covers eight: the four
    held/ordinary core states plus FAULTED and DISCONNECTED, each measured by
    asking the real session and the real page, with nothing hand-written on either
    side. Extending it found three more drifts, two of them pre-existing and neither
    of them about the held states I set out to fix.
    * `dump` was disabled under FAULTED, but the session reads a faulted core and
    the chip answers. It is disabled precisely where an operator needs it: the
    sticky fault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
    [session.py, test_gui_capabilities.py, test_session.py]
2026-09-26 docs: the merge-repair record - the cause was a debug input with no driver, and it was not in the six acts
    The manager's hypothesis (the merge dropped part of the act dependency chain,
    peasm.py being the visible difference) is disproved by object hash: all twelve
    files the six acts own are byte-identical between main and the green branch,
    and the peasm.py difference is this branch's own Block 3 WIP, now a separate
    commit. The real cause is one file the acts depend on and do not own.
    Also records two process notes that cost more than the repair: a missing comma
    in a port list made the fix a silent no-op that only ELABORATION could catch,
    and a full suite run filled /tmp and left sixteen file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
2026-09-26 docs: the soak re-run under the poll-everywhere change, and what it does not cover
    The manager's dispatch: three host behaviour changes moved the page's
    steady-state request pattern, so re-run the bounded soak under the new
    behaviour rather than assume it. 20 min, same seed, same sampling, plus an
    independent /proc sampler alongside it so both series are measured the way the
    earlier run was.
    Result: BOUNDED, and the numbers that matter match the earlier run rather than
    merely staying under a threshold.
    * drift across the run +0.29 MB (20 min) vs +0.31 MB (22 min)
    * independent /proc rate 1.08 MB/h vs 1.1 MB/h - the cross-run number with
    no endpoint-selection bias, and it matches
    *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
    [test_gui_capabilities.py]
2026-09-26 feat(R2): the judge-facing run now demonstrates the held readback and the refusals
    Three host behaviour fixes landed and the acceptance run - the thing a judge
    watches - still walked the old path, so a fix nobody can see in the demo reads
    as unverified. Two beats, in the shape I recorded when deferring them.
    * `r3_demo_held_readback`, inside the demo group at the moment of the hit, over
    exactly the path the GUI polls: STATUS reports state=3 (BP_HIT) with run=1 and
    the session reports BP_HIT rather than "stopped"; DUMP_CORE is REFUSED,
    because its gate is the run strap and the core's NOT_READY is the chip
    agreeing; READ_CPU still answers, because it is the one non-halting read. So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
    [acceptance.py, test_docs.py]
2026-09-26 wip: HC-SR04 ranging - the conversion computes 199 mm exactly, the BANK reads the wrong pair
    Block 3 act (a), deliberately NOT wired into run_all.sh: the act does not pass
    yet, and an act that fails does not go in the regression.
    VERIFIED ON REAL RTL (Icarus + the real 1P_1024x16 SRAM macro):
    * the trigger pulse is EXACTLY 600 clocks = 10.000 us, and the testbench
    checks it as an equality against 600 rather than as the datasheet's
    ">= 10 us";
    * the echo WIDTH is captured exactly: the model's 1160 us arrives as 1159,
    one tick, which is the 1 us counter's quantisation and the same +1 the
    frequency meter showed;
    * THE CONVERSION IS EXACT: 1160 us -> 199 mm against the sp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
    [peasm.py, tb_pe_soc_sr04.v]
2026-09-26 fix(bridge): the read buffer is trimmed to the length field - a board-only defect
    Found by following the R2 wait-word contract to its end. The bridge budgets the
    chip's 15 worst-case wait words for EVERY opcode (`_response_words` =
    6 + data + MAX_WAIT_WORDS), because a bounded read may be preceded by 0xFFFF
    fillers. The R3 debug ops answer ready-immediate with ZERO wait words - and so
    does every other fixed-size op - so the host always reads up to 15 words PAST
    the end of the reply.
    What fills those words is the chip's RELEASED MISO pad: pe_ctrl asserts
    `miso_oe` only while a response shifts (tt_um: `uio_oe[6] = ctrl_miso_oe`), so
    on hardware the host reads the idle pad level, which is not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
    [fakes.py, fuzz_protocol.py, pe_frame.py, protocol.py]
2026-09-26 style: reformat the acceptance beats and their tests (no behaviour change)
    External reformat of the two new acceptance beats and the suites that pin
    them: one-name-per-line list expansion, leading operators, and a quote-style
    change inside an f-string. Verified the emitted beat text is unchanged (the
    held-readback line still prints 'is not "stopped", it is BP_HIT') and the run
    still reports 37 PASS / 0 FAIL / 1 SKIP.
    [acceptance.py, test_docs.py]
2026-09-26 wip: HC-SR04 - accumulator swap and PREV init landed; the second measurement still misses
    Resuming from 3119d2f. Three of the checkpoint's open items are closed and one
    is not, and the one that is not is a real fault with a short list of
    candidates rather than a mystery.
    CLOSED 1: THE ACCUMULATOR SWAP, which is what the checkpoint was written for.
    The small term (11r) now accumulates in T (dmem[0..1]) and the main term
    (11q) and the answer in dmem[14..15], and the bank reads dmem[14..15] -- so it
    banks the millimetres rather than the conversion's own intermediate. Verified
    by the measurement: the first answer is now 199 mm in the RIGHT slot.
    CLOSED 2: THE TRIGGER COUNT. The model now sees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
2026-09-26 gate: regress/verify_merge.sh - a merge is never pushed without the tests its diff can break
    The process gap 5b4731f exposed: every gate this project owns was green a
    minute before that merge and red after it. R3 added dbg_hold/dbg_step inputs
    to pe_cpu; the fw branch never saw them, its six act testbenches left the
    ports unconnected, Z made the execute gate X, and six unrelated programs sat
    at reset. No gate could catch it - until the merge, the two states did not
    coexist. This is the missing gate.
    WHAT IT DOES. Maps a merge onto the testbenches that can be affected, using
    run_all.sh's OWN CASES table (parsed, not restated, so a case added to the
    suite cannot be invisible to the gate): a c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
2026-09-26 style: the pi-lens reformat of the 3 files from the bridge fix (no behaviour change)
    Committed rather than discarded this time, which is the point of the lesson from
    the process incident: a dirty tree is not a reason to throw anything away.
    Verified semantically intact before committing, not by eye: the ast.dump() of
    each working-tree file is IDENTICAL to HEAD's (fuzz_protocol.py, fakes.py,
    test_bridge.py), so the diff is provably formatting-only - one-per-line list
    expansions, leading operators, quote style. Full host gate green on the
    reformatted tree: run_host_tests.sh exit 0, host_gui 355, host_bridge 100, ruff
    clean, r2+r3 package gates 0.
    [fakes.py, fuzz_protocol.py]
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2026-09-26 gate: learn a testbench's package directory from the testbench, not from its name
    Applying verify_merge.sh to the commit that introduced the R2 held-core
    vectors found a real gap in the mapper, and the gap is the kind that only
    shows up when you run the thing on real work.
    tb/r2-vectors/ is a PACKAGE directory that tb_pe_ctrl_r2 $readmemh's, and
    the directory is not a case name, so "tb/<dir>/<file>" resolved to a case
    called "r2-vectors", matched nothing, and was reported as a same-list
    violation - ten of them, for files that are exactly the kind a merge gate
    must react to (a golden vector BYTE changed). A stream of false alarms is how
    the one real alarm gets ignored, and the real one is al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
2026-09-26 docs(diagrams): add R2/R3, the firmware personas, formal and the fleet
    Both PlantUML maps were behind a lot of landed work. Added to BOTH, and
    re-rendered in png + svg per diagrams/README.md:
    * R2 read path: the bounded host read port (pe_soc dbg_rd_*) and the
    wait-word contract (pe_ctrl DRIVES 0xFFFF filler, frame starts at the
    first non-0xFFFF word, leading-only skip). Landed -- green.
    * R3 debug control: DEBUG_STEP / BP_SET / BP_CLR / DEBUG_STATUS, the bp
    comparator and debug response mux, and STOP-BEFORE semantics.
    * The protocol and timing acts as firmware: 5 protocol acts (I2C adv,
    SPI m3+CRC, UART RTS/CTS, MIDI 31.25k, DMX512-A 250k) and 7 timing
    acts (WS281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
2026-09-26 docs: archive the merge-gate demonstrations' own output; log the mutation-gate ruling
    The excerpts are the gate's words, not my summary of them - the RED banner
    naming the six acts, the GREEN banner with 14/14 and all 14 mutation suites,
    so a reviewer can check MERGE-FORENSICS section 6.1 without trusting it.
    The QUESTION line records the one decision I did not make: whether a narrow
    merge should skip mutation suites the way it already skips testbenches. It is
    implementable in the same shape as the case mapping, but it would make a
    filtered run run strictly less than the full gate, which is a ruling about
    what this project's gates are allowed to skip, not a refactor.
2026-09-26 docs(diagrams): CORRECTION — the R3 debug control is landed, not unimplemented
    The previous commit (3e7ba87) drew the R3 section RED on the grounds that
    "pe_ctrl.v and pe_cpu.v contain no bp_ or step signal at all". That
    measurement was CORRECT and in the WRONG TREE: this branch is behind main,
    and main carries the landed R3 control — 21 references in pe_ctrl.v, 8 in
    pe_cpu.v, with 0x21 DEBUG_STEP, 0x22 DEBUG_BP_SET, 0x23 DEBUG_BP_CLR and
    the `cpu_exec = dbg_step || (run && !dbg_hold)` gate.
    Both diagrams now show the section green and carry the real contract
    instead of a claim about my own checkout:
    * DEBUG_STEP executes EXACTLY ONE instruction and answers NOT_READY (no
    fault) w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
2026-09-26 feat(R2): the flag-flip choreography, so the held-step flip is a tool not a checklist
    When the chip re-runs tb_pe_ctrl_r2 against the four held-core steps, the flip
    touches nine surfaces at once, by hand, under a guard that rightly screams if
    any is missed. This makes it one command that refuses to run without the chip's
    report, and makes the largest surface - the NOTICE - something that cannot be
    got wrong by hand.
    THE STRUCTURAL PART, which is the real deliverable: `PACKAGE_NOTICE` is no
    longer a sentence about the flags, it IS the flags. `notice_for(confirmed=,
    pending=)` generates both wordings and `PACKAGE_NOTICE = _notice(CHIP_EVIDENCE)`.
    That is the F1 lesson applied to the class rat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
    [r2_vectors.py, test_r2_flip.py, test_r2_vectors.py]
2026-09-26 wip: HC-SR04 - the recovery wait fixes the retrigger; the second echo's rise is still missed
    Fourth resume on this act. The fault named in the last commit is closed, and
    the closure is a PROTOCOL requirement rather than a patch: the firmware
    re-triggered 7 us after banking, which is inside the recovery of every real
    HC-SR04 and inside the testbench model's 2 ms window, so the model was not
    listening for a trigger when it came. A trigger inside a device's recovery is
    not answered AT ALL -- it is ignored -- so the measurement that never came
    back was silent: the run banked one answer and stopped, with no symptom
    beyond a missing one. The firmware now waits 255 outer passes of
    (4*SR_RECOV_LEN +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
    [peasm.py]
2026-09-26 style: the pi-lens reformat of the flag-flip files (no behaviour change)
    Committed, not discarded - which is the handling I logged ten minutes ago after
    getting it wrong on three other files. Verified semantically intact by AST
    comparison against HEAD (all three IDENTICAL), so the diff is provably
    formatting-only: one-per-line list expansions and leading operators.
    The flip tool's refusal paths are all still exercised (test_r2_flip 13 tests) -
    which is the property that matters for a commit whose whole content is a
    refusal mechanism, so the reformat is checked against the tests rather than by
    eye.
    [r2_vectors.py, test_r2_flip.py, test_r2_vectors.py]
2026-09-26 docs(WORKLOG): the fifth probe exonerates the firmware's edge handling again -- the model's second serve never drives the line, and a model that counts a measurement before it makes one is the testbe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
2026-09-26 test(bridge): the PRODUCTION read path, with the reply shorter than the budget
    The read-length defect I fixed lived in a path no test could reach, and the
    reason is the lesson rather than the bug: the fake was more forgiving than the
    hardware. I modelled a released pad in the test adapter, but that only proves
    the FAKE half. The real `TTAdapter` clock-out loop - the one a Pico runs - was
    still only driven by tests that fill the read budget EXACTLY (six words of
    response for six words requested), so the case the bridge hits on EVERY
    fixed-size op was untested: `_response_words` budgets the chip's 15 worst-case
    wait words for every opcode, so a six-word PING reply is read with room for 15
    more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
2026-09-26 docs(WORKLOG): the probe settles it -- the model's recovery window swallows the firmware's second trigger, two independently-fitted recovery constants are 19 us apart, and the check that would have c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
2026-09-26 fix(acceptance): the debug act now runs on a BOARD, not only where a model can be clocked
    `demo_act` reached the breakpoint with `pe.advance_free_running()`, so on
    `--device` — where there is no FakePE — the whole r3_demo group was SKIPPED
    with the reason "no FakePE to advance to the breakpoint". That includes the two
    beats added earlier today about the held readback. The walkthrough tells a judge
    to run exactly this act, and the operator's board run would have silently not
    done it: the one demo that cannot work without a simulator.
    The act never needed the MODEL, it needed to WAIT for the core to arrive. A
    real core advances on its own; only the FakePE has to be clocked. So
    `await_brea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
    [acceptance.py]
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2026-09-26 wip: HC-SR04 - both measurements now run, and the first is exact
    Seventh resume. The three-part testbench fix is in, and it found the fault it
    was written to find.
    THE TESTBENCH, three parts. (1) THE MODEL NOW LISTENS FOR A TRIGGER
    CONTINUOUSLY and answers only the ones outside its recovery, counting only
    what it answered: a trigger inside the window is ignored the way a real device
    ignores it, and is not counted -- because a model that counts a measurement
    before it has made one is the testbench-side twin of the bank that read the
    wrong accumulator. (2) RECOV_US is 1500 us against the firmware's measured
    2019, so the model's window is SHORTER than the firmware's wait by 519 us
    instead of b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
    [tb_pe_soc_sr04.v]
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2026-09-26 fix(acceptance): the run-and-hit beat says which run it is reporting on
    bce4ee0 made the debug act run on a board and left the beat text telling the
    fake story on both paths: "model-clocked: FakePE does not self-advance, a real
    core does". On a board there is no model and nothing is clocked, so the one line
    an operator reads after a real run described a simulator that was not involved -
    the same class of claim that does not match the surface it appears on, which is
    what this session has been removing everywhere else.
    So the beat now follows the path, the same way the package notice follows the
    flags: the FAKE wording is byte-identical (the walkthrough pins it, and a test
    pins it again here)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
    [acceptance.py]
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2026-09-26 docs(bringup): a triage row for the read-length failure I found today
    The bridge reads a fixed budget of wait words past every reply, so the words
    after the frame come off a RELEASED MISO pad (pe_ctrl drives MISO only while a
    response shifts). When the reader did not trim to the length field, EVERY op
    failed - including `ping`, which carries no payload - with "length field does
    not match the frame" or a CRC mismatch. That reads like a protocol bug and is
    not one, and the operator meets it holding a board with no other place to look,
    so the row names the exact error text, the cause, and the two things it can be:
    an older host build without the trim, or something else driving the pad while
    idl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
    [test_docs.py]
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2026-09-26 docs(WORKLOG): ninth resume -- the probe's hard-coded windows missed both conversions and the failure reads as a negative result; a window placed from an estimate is a probe that cannot confirm what 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
2026-09-26 docs: the runbook and the pending row now describe the board run as it is
    A consistency sweep over my own last change, and it found what a reviewer
    would have. bce4ee0 removed the "no FakePE to advance to the breakpoint" skip,
    so the device run now performs the whole debug act - and the runbook's section 4,
    which enumerates exactly what `--device` does, still listed the old sequence
    without it. So the document was not wrong so much as out of date, in the one
    place an operator reads before touching hardware.
    Worse, the "what a healthy run looks like" sentence said every step passes
    except `uart`. With the act running, that is FALSE on an R1-only shuttle: the
    debug lines answer UNSUPPORTED an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
    [test_docs.py]
2026-09-26 test: the frequency-style US defect in my own testbench, and the probe that overturned my last conclusion
    TWO THINGS, and the second retracts what I wrote an hour ago.
    1. THE TESTBENCH'S OWN DEFECT, now fixed. US IS ONE REGISTER HOLDING THE LAST
    WIDTH, and the check loop compared every segment against it -- so
    "measurement 0: the firmware read 5816 us" was this file reporting its own
    reading order, and two of the failing checks were about a number the
    firmware never claimed for that point. The width is now checked ONCE, on
    the last measurement, and the check says which it is; the per-measurement
    claim in this act is the millimetres, which are banked per slot. One
    failin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
    [tb_pe_soc_sr04.v]
2026-09-26 docs(WORKLOG): the data-armed probe withdraws my own 'skipped conversion' reading, and the fault is the both-zero guard in a chain the probe proves is running
2026-09-26 test(host_gui): the event stream - a socket on both ends, and no test
    An hour ago I changed the page half of this path (the scheme follows the page's,
    and the polling fallback hangs off error/close because a socket to a dead
    endpoint does not throw). I never checked the premise: whether the server serves
    that endpoint at all. It does - `create_app` mounts `@app.websocket("/api/events")`
    and drains `session.process_events()` into it - and the two halves agree on the
    shape (the server sends the bridge's event dicts; the page reads `event` and
    `event.data`). So the fix stands. But BOTH halves were untested, which means the
    agreement was a fact I had read rather than a property anything checked,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
    [test_docs.py, test_event_stream.py]
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2026-09-26 fix: sync the stale R3 chip-confirmation status line (one line, main's red)
    The R3 golden-package gate is red on main, and it blocks landing BLOCK 3
    because the suite would fail. It is NOT caused by my merge: both README
    files came from main unchanged and my merge touched no R3 vector code.
    The drift is EXACTLY ONE LINE, the **Status:** line, and the two sides
    disagree about whether the chip has confirmed R3:
    reviews/2026-09-24/.../r3-hex/README.md 25 of 26 CHIP-CONFIRMED IN
    SIMULATION, tb_pe_ctrl_r3_conf
    GREEN, 26/26 byte-exact
    tb/r3-vectors/README.md "no step here has been run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
2026-09-26 fix(packaging): `pip install .[host-gui]` now works - it never has
    The operator's board run starts with the runbook's `pip install .[host-gui]`.
    On a fresh clone that command FAILED, and nobody noticed because nobody ran it -
    for the same reason nobody ran the server: the extra was never installed here.
    The cause is not a dependency. The `[project]` table declares the extra, but
    nothing told setuptools what the distribution CONTAINS, so flat-layout
    auto-discovery found `tb/`, `sim/`, `rtl/`, `wiki/`, `flow/`, `regress/`,
    `firmware/` and `diagrams/`, could not choose, and failed WHILE BUILDING:
    error: Multiple top-level packages discovered in a flat-layout: [...]
    That timing is what make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
    [test_docs.py]
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2026-09-26 gate: narrow the mutation suites by their own MUTABLE lists - MAPPED, not skipped
    Implements the manager's Q2 ruling (2026-09-25): a mutation suite runs in a
    narrowed gate IFF one of its MUTABLE targets intersects the merge-mapped changed
    set; anything unmappable runs ALL suites; and the gate PRINTS every suite as RUN
    or SKIP with the reason, so GREEN never claims more than it ran. The full
    unfiltered run_all.sh - the master/nightly gate - is untouched: the narrowing
    exists only inside verify_merge.sh.
    THE PREMISE WAS TRUE FOR 7 OF 16, so this needed normalising rather than just
    reading. MUTABLE="..." already existed in seven harnesses (a real convention,
    documented in mutate_eth_soc_tb), b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
2026-09-26 test(host_gui): the page and the server must agree on the routes, statically
    Every FastAPI test SKIPS in this environment - the extra is not installed here -
    so the one surface a board operator's browser actually talks to has no coverage
    at all. This is the half that needs no extra: compare what the page CALLS with
    what the server REGISTERS, by reading both sources.
    Both directions, because they fail differently. A page call with no route is a
    404 at runtime, on a board, in front of an operator - the worst place to find
    out. A route nobody calls is dead surface: not wrong, but it rots silently while
    looking supported. `/api/assemble` is the one route the page does not call (the
    page posts a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
    [test_docs.py]
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2026-09-26 docs(test): state the route pin's real limit - it compares paths, not verbs
    Reading my own pin from yesterday's commit, the first thing a reviewer would
    ask is whether a page can POST a path the server registers GET-only. It cannot
    be caught here: the comparison is on PATHS. That failure would be a 405 Method
    Not Allowed at runtime, on a board, in front of an operator - exactly the class
    this class exists to catch - and the pin would be green.
    The verbs were checked by reading every call site, and they are correct:
    * start / stop / dump come off a table of [id, path] pairs fed to
    `api(path, { method: "POST" })`;
    * the four debug paths go through `debugCall`, which hard-codes POST;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
    [test_docs.py]
2026-09-26 test(host_gui): pin the host's host-SPI pin map against the chip's pinout
    Two facts that have to agree, living in two repositories, never compared by
    anything: the host's `board.HOST_SPI_PADS` and the chip's `info.yaml` pin
    descriptions. They agree today — `cs_n=4, mosi=5, miso=6, sck=7` against
    `uio[4]=host CS_N, uio[5]=host MOSI, uio[6]=host MISO, uio[7]=host SCK` — and
    nothing in either repo would notice if they stopped. The symptom would be a
    board run that simply never talks: SPI clocking into a pad the chip is not
    listening on, with every host gate green and every chip gate green, because
    neither side is wrong on its own.
    So the chip's rows are COPIED here, with their source and t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
    [test_board_pins.py]
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2026-09-26 docs(WORKLOG): four verified-exact installs and four wrong answers -- a primitive verified in a model is not the same claim as one verified in the machine, and the trace comparison is the next step
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2026-09-26 docs: two judge-facing counts were stale, in the documents read FIRST
    The R2 count has moved twice — 15 golden steps became 18 when the ceiling
    vectors landed, and the package became PARTIAL when the four held-core steps
    were added. Two documents a judge or an operator reads before anything else
    still carried the old number:
    * `docs/submission-readiness.md`, the scorecard, said "the R2 read contract is
    18/18 chip-confirmed" — which presents the read-path tally as the whole
    contract, and the package is 18 of 22 with four held-core steps unconfirmed.
    On the one document whose job is to grade honesty, that is the wrong claim in
    the worst place.
    * `docs/host-bridge-bringup.md`'s OPE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
    [test_docs.py]
2026-09-26 docs(WORKLOG): the trace proves the primitive is correct in the machine, and the second measurement's fault is MY OWN equality check grading the conversion against the model's width instead of the fi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
2026-09-26 docs(WORKLOG): correction -- my own output disproved the tick claim in the previous line, and what the trace actually establishes
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2026-09-26 test(host_gui): the runbook's COMMANDS must be commands, not plausible text
    The existing bring-up pin checks that certain strings APPEAR in the runbook. It
    does not check that they WORK. A renamed script, a moved module or a dropped flag
    leaves every pin green and leaves the operator holding a board with a runbook
    that fails at its first line — the worst place to discover a typo, and the
    cheapest thing in the tree to check.
    So: every `tools/...` path the runbook actually RUNS must exist, and every flag
    it tells the operator to pass must be one the runner advertises. The flags are
    read from the runner's OWN `--help` rather than from its source, so a renamed
    flag cannot leave the pin agreei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
    [test_docs.py]
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2026-09-26 docs(WORKLOG): the trace names the mechanism -- the conversion jumps out to the poll loop between the doublings, and 0x1d is a tick count, so a label in a hand-copied block resolves to main
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2026-09-26 docs(bringup): triage rows for the three beats that could only fail on hardware
    The triage table had 14 rows and named 13 of the 14 acceptance beats, but the
    gaps were not random: the three beats with NO row are the three whose failure
    mode is specific and diagnosable. And `heartbeat` is the one that matters most
    for a first board run, because in `--fake` the model scripts
    `pe.timer = pe.timer + 1` — so the beat CANNOT fail there. On hardware the
    chip's `dbg_timer` has to actually advance inside the beat's window (3 tries x
    0.25 s, about 0.75 s), and if it does not, the operator was reading a table
    that said nothing about it.
    * `heartbeat` / `timer stuck at N` — states the window, and g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
    [test_docs.py]
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2026-09-26 docs(WORKLOG): the listing-derived trace shows the original add survived every install -- the rewrite's anchor assumed a fixed four-line offset, and that is the fifth placement error in this act
2026-09-26 fix(gui): the debug panel must not INVENT the run strap it was never told
    `DEBUG_BP_SET` and `DEBUG_STEP` answer with the five-word debug prefix
    (status, state, pc, bp_addr, bp_flags) — there is no run word in either, because
    the chip is not reporting the strap there. The page filled the gap with
    `run: payload.run ?? 0` and rendered it as "low", so an operator who armed a
    breakpoint on a RUNNING core was told, in the panel, that the run strap was
    down — in the exact state where they are about to be stopped by their own
    breakpoint. A readout that asserts a value nobody sent is the same defect as the
    chip-state label that collapsed four values into two, one commit ago.
    The panel now says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
    [test_docs.py]
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2026-09-26 test(host_gui): the page and the API are joined by response KEYS too, not just paths
    The route pin checks that every path the page calls is one the server registers.
    This checks the other half: every key the page reads off a response is one the
    API actually sends. A rename on either side — an envelope key changed in
    `server.py`, or a field the page starts reading — leaves the page rendering
    `undefined` at runtime, on a board, with every other gate green.
    The API side is measured by CALLING the methods, not by reading their source.
    That is the whole design: a text scan of `server.py` would be the fifth scanner
    of mine today, and every one of those has been wrong at least once — one of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
    [test_api.py]
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2026-09-26 test(host_gui): a refusal must reach the operator as TEXT, and that was untested
    The leg that makes a refusal legible was the one piece of the GUI's error path
    with no coverage: `guarded()` decided status and detail inside `create_app`, as a
    closure over fastapi's `HTTPException`, so it could only be tested with the
    optional extra installed — and this environment does not have it. That means the
    refusals added earlier today (a step before a load, a step while faulted, a dump
    under a live hit) were never checked on the one path that shows them to a user.
    It matters because the page shows the server's `detail` field and falls back to a
    bare status line without it. So the mapping is the diff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
    [server.py, test_api.py]
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2026-09-26 wip: FM0/FM1 bi-phase - the RED testbench, and the act's shape
    Block 3 act (c), RED-first: the testbench exists, elaborates on real RTL, and
    fails with a named check because there is no firmware yet. That is the state
    the discipline asks for, and it is the state the frequency meter started in.
    WHY THIS ACT IS NOT A SEVENTH TIMING ACT. Every other act in this block is
    judged on a waveform a receiver can decode. This one is judged on a RECEIVER:
    the code lives in the TRANSITIONS, not in the levels, and the only clock in the
    system is the one the receiver recovers from the data. So the claim is not
    "the firmware drives a bi-phase stream" but "the firmware RECOVERS THE CLOCK
    from a stream it sh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
    [tb_pe_soc_bmc.v]
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2026-09-26 wip: FM0/FM1 - the RED testbench now has both directions and seven named checks
    Block 3 act (c), still RED: seven named checks, all failing because there is
    no firmware, which is the state the discipline asks for and the state the
    frequency meter started in.
    THE TESTBENCH'S DECODER IS NOW FED BY THE PAD and by a microsecond counter and
    by nothing else, and it is fed WITHOUT being told the half-interval it should
    expect: a receiver that is told its own bit rate is not recovering anything,
    and the whole claim of this act is that the clock comes out of the data. What
    it does know is that a change of level is a TRANSITION and how long ago it
    happened, so the interval it measures is the length o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
    [tb_pe_soc_bmc.v]
2026-09-26 fix(host-gui): the [host-gui] extra could not run the tests it exists to enable
    Installing the extra (manager-approved, into a repo-local gitignored .venv rather
    than a system env) made the API layer run for the first time, and four tests
    failed. All four had ONE root cause, and it was not the code: starlette's
    TestClient imports `httpx2`, which the extra never declared. So the documented
    flow — install `.[host-gui]`, then run the host gate — died with "the
    starlette.testclient module requires the httpx2 package", in three tests whose
    failure had nothing to do with what they were testing. `httpx2>=2.13` is now
    declared, with the reason in the file, because an extra that cannot run the
    te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
    [test_event_stream.py]
2026-09-26 wip: FM0/FM1 - the first draft of the firmware, which assembles and runs
    Block 3 act (c), still RED: firmware/bmc_frame.pe is 139 words, assembles, and
    the testbench's seven checks all still fail -- but the act is no longer RED
    because there is no firmware, it is RED because a first draft does not yet
    decode. The distinction matters for the next session: the checks are the
    reference now, not a description of them.
    WHAT THE DRAFT DOES. It DECODES by timestamping the level on the 1 us counter
    and comparing it with the level recorded at the last CHANGE -- the mechanism
    that recovers the clock, and the one a sample-based edge detector cannot do at
    all -- and it folds intervals into bits once pe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
    [peasm.py]
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2026-09-26 fix: the FM0/FM1 testbench's encoder was not bi-phase, and a claim it supported was false
    Block 3 act (c), and this is the SECOND time in this act that the instrument is
    what was wrong -- which is the pattern the whole block exists to demonstrate,
    and the reason the act was written with two decoders from the wire rules rather
    than one decoder and one encoder that agree by construction.
    THE ENCODER WAS NOT BI-PHASE. It returned, for FM1, a first half that was
    always HIGH and a second half equal to the data -- so a '1' was a CONSTANT HIGH
    for the whole bit, with no transition anywhere in it. "Bi-phase" means the level
    changes WITHIN the bit interval, and the wire rules at the top of this very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
    [tb_pe_soc_bmc.v]
2026-09-26 fix: the FM0/FM1 firmware claimed its INPUT pad, so the decoder read its own register
    Block 3 act (c). The init wrote BMC_IN to PINOE -- claiming the pad the
    testbench drives -- on the reasoning that "the input belongs to the device, so
    claim it". It is exactly backwards, and the whole decoder is that one bit: A
    PAD THE FIRMWARE DRIVES READS BACK ITS OWN REGISTER THROUGH PIN, not the wire.
    So the firmware never saw the stream at all.
    THE SYMPTOM WAS WORTH NAMING BECAUSE IT POINTS NOWHERE: no transition was ever
    detected, the flag stayed 0xFF and the three recovered bytes stayed 00, which
    reads as "the decoder does not work" rather than as "an enable is written
    backwards". It is the SIXTH ti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
2026-09-26 docs(WORKLOG): the bi-phase WIRE RULES were wrong in a second way -- every bit transitions in its middle, the data is the first half's level, and the stream carries NO polarity information, so a prea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
2026-09-26 feat(R2): the chip confirmed the four held-core steps - 22/22, flipped with their citation
    The chip re-ran `tb_pe_ctrl_r2` with the debug opcodes on a real `pe_ctrl`, no
    hierarchical forcing, and reports 22/22 byte-exact with the four held steps among
    them, each pre-state established by traffic and asserted on `pe_ctrl`'s own
    registers. RED-proved both ways: swapping the 2/3 state encoding gives 18/22 with
    exactly these four failing - i.e. the shipped 18 were blind to it, which is the
    entire reason the vectors exist - and gating `OP_DUMPCOR` on the hold instead of
    `run` fails `dump_core_refused_the_strap_is_high`.
    THE CITATION IS THEIRS, AND THE POINTER NEEDED CORRECTING. The dispatch said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
    [acceptance.py, test_docs.py, test_r2_flip.py, test_r2_vectors.py]
2026-09-26 style: the pi-lens reformat of the flip and its suites (no behaviour change)
    Committed rather than discarded, which is the handling I recorded after getting
    it wrong once. All six files AST-identical to HEAD, so the diff is provably
    formatting-only: one-per-line list expansion, leading operators, quote style.
    The gate passes on the reformatted tree, which matters here because two of the
    six carry the flip's refusals - a test suite whose formatting broke its own
    refusal logic would be a bad way to end a wrap.
    [acceptance.py, r2_vectors.py, test_docs.py, test_r2_flip.py, test_r2_vectors.py]
2026-09-26 docs(host-gui): the flip was generated right and typed wrong in five places
    The flag-flip landed 22 of 22 with the notice GENERATED from the flags, which is
    why the package is self-consistent. Everything a human typed by hand was not, and
    the four live claims below still said 18 of 22 - one of them contradicting itself
    inside a single sentence ("22 of 22 golden steps byte-exact; the 4
    held-at-a-breakpoint readback steps are still unconfirmed", wiki/STATUS.md): the
    runbook's opening, its `r2_read_*` triage row, the scorecard's host-controller
    row, and that STATUS note. Plus one typed judge-facing string in the acceptance
    `fault_refusals` beat that `_r2_evidence_summary()` had not reached. His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
    [acceptance.py, test_docs.py]
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2026-09-26 docs: the exact carry lands -- measurement 1 is exact at 999 mm, measurement 0 regresses, and the failure is narrowed to one byte
2026-09-26 docs: the trace names it -- the conversion is CORRECT and the fault is my scratch allocation, which destroys the previous answer
2026-09-26 gate: the harness-edit pre-flight, and a narrowing bug its own cross-check caught
    TWO THINGS. The pre-flight closes the race I hit on 2026-09-25 (a campaign ran
    mutate_timing_tb.sh while I was inserting a declaration into that same file; bash
    reads scripts incrementally, so the harness executed comment fragments and
    reported FAILED). That direction is merely embarrassing. The dangerous one is
    that the same race can produce a FALSE PASS, and a false pass is the worst
    thing a gate in this project can do, because it is believed.
    regress/dep_guard.sh: chip_dep_stamp at start, chip_dep_check at end, over a
    CONTENT hash (not an mtime - an editor or checkout that rewrites a file with
    identical con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
2026-09-26 docs: the one-answer design gives an exact 199 mm -- what remains is testbench work, three stray reads, and a check with a one-line index bug
2026-09-26 fix: the HC-SR04 conversion is exact -- one answer per run, three temporaries, low byte first
    Block 3 act (a), the state the last six commits were working towards. Measured
    on real RTL: 1160 us -> 199 mm, EXACT, against the specification's 199.375.
    WHAT CHANGED, and each of the three is a finding rather than a preference:
    * ONE MEASUREMENT PER RUN. The conversion needed four temporaries and the
    machine has sixteen bytes, and with two answers banked the next
    conversion's temporaries OVERWROTE the previous answer: both terms were
    right, both widths were right, and the answer the testbench read back was
    the following conversion's scratch. One answer per run gives the whole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
2026-09-26 docs: close the last Q2 hole - mutate_timing_tb re-measured, 323 s, valid
    The one figure the Q2 cost table could not use was voided by a read/write race
    (a MUTABLE insertion landed in mutate_timing_tb.sh while bash was executing it),
    and the review named the single command that closes it. Run with nothing editing
    it: 323 s, 58 cases, 58 detected, 0 survived, 0 harness errors, RESULT: PASS,
    tree clean afterwards. Total for the sixteen suites 1468 -> 1456 s.
    Two caveats recorded rather than smoothed over: the re-measured figure is not
    strictly comparable with the other fifteen, because the timing suite has since
    grown to 58 cases as fw-bus added acts, so it is measured against the suite as it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
2026-09-26 fix: the trigger derivation is 4*SR_TRIG + 5 = 601 clocks, counted from the listing
    peasm's CONSTS comment claimed 4*SR_TRIG + 4 and the hardware made 601, and
    the testbench's equality against 600 was the only thing that noticed. Both are
    now correct and both stay strict: the comment derives 601 from the five
    instructions that make the pulse -- the OUT PINOE that claims the pad, the
    two-instruction counter load, the loop, the LDI that sets the ending level and
    the OUT TXPIN that drops it -- and the check is an equality against 601 clocks
    = 10.017 us, which clears the device's 10 us MINIMUM with a clock to spare.
    Pinning 600 would have pinned a number the device never specified, and no
    window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
    [peasm.py, tb_pe_soc_sr04.v]
2026-09-26 gate: assert the pre-flight's COVERAGE, so the next harness cannot arrive unprotected
    regress/dep_guard.sh stops a run reporting a verdict from scripts that changed
    underneath it, and it was wired into all sixteen mutation harnesses on
    2026-09-25. Nothing asserted that. The wiring is correct today because of an
    edit, not because of a gate — and the next person to add a seventeenth harness
    gets one that takes the run lock, is therefore stamped, and is never checked, so
    a mid-run edit to it yields a verdict nobody can trust with nothing saying so.
    That is the same drift regress/check_mutation_lists.sh exists to stop for the
    MUTABLE lists, where a missing entry made the merge gate SKIP a sui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
2026-09-26 chore(WORKLOG): close the day - the record is shipped, the gate ran on a real merge
    IDLE-QUEUE-EMPTY. The dispatch chain is closed: the day verification record is
    written and pushed with every number measured fresh on this tree, the R2
    held-core finding is corrected against the RTL rather than on the corrector's
    word, and the last unrun piece - the merge gate on a REAL merge, b252f0c, the
    fw repair that started all of this - came back GREEN at 46 cases and 16/16
    mutation suites.
    The remaining reds are not mine and not closable by a worker: the hardware
    acceptance run needs a board, fw-timing's freqmeter act is WIP by design, and
    R3.2's four bounded pe_ctrl claims need a claim-reformulation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
2026-09-26 docs(proto-servo): the figure set, and the protocol with nothing in it but a number
    diagrams/proto-servo.puml the engine, both sides
    diagrams/proto-servo-frame.puml the slot, the two delay tables, the sweep order
    diagrams/proto-servo-timing.puml the wire timing, in real numbers
    wiki/concepts/protocol-servo.md the prose the figures summarise
    The servo is the family's cleanest claim and its least forgiving SHAPE. There is
    no clock, no framing, no checksum and nothing to decode - the whole protocol is
    "high for 1-2 ms, once every 20 ms" - so the only way to be wrong is to be wrong
    about time, and the only interesting failure is not a wrong number but a wrong
    relationsh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
2026-09-26 docs(proto-dht11): the figure set, and the bit value that IS a width
    diagrams/proto-dht11.puml the engine, both sides
    diagrams/proto-dht11-frame.puml the five bytes and the handshake around them
    diagrams/proto-dht11-timing.puml the handshake, in real numbers
    wiki/concepts/protocol-dht11.md the prose the figures summarise
    The DHT11 is the hardest of the three original timing acts and the figures are
    built around the decision that makes it tractable: the host SYNCHRONISES on the
    line's edges instead of counting a fixed time per bit.
    That is not a style preference. The sensor's bit period is not fixed - a 0 is
    76..78 us and a 1 is 120 us - so a counting host drifts at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
2026-09-26 docs(diagrams): refresh both maps to current reality, and take the three accuracy corrections
    MAP REFRESH. Built ON the already-pushed fw-bus baseline rather than from
    main, so the R2/R3 blocks, the firmware-persona sections, the formal campaign
    and the worktree fleet are preserved (see 8f37218).
    * plan + progress: the three new protocol figures as a documentation
    surface, wired to the two wiki concept pages
    * formal: THE SMT UNLOCK added as the 11th TARGET, which is what
    smt_induct.sh is - the same claims through write_smt2 + yosys-smtbmc/z3,
    where a register has ONE next-value function instead of one per sampling
    domain, and which proved the pe_soc C2 owner-set guard u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
2026-09-26 review(docs): accuracy pass 3 - the I2C set is clean, the servo set has two arithmetic errors
    Rolling pass over docs/diag-bus (the I2C-advanced set, the target pass 2 named)
    and docs/diag-timing's new servo set.
    THE I2C SET IS ACCURATE, on all 101 claim-bearing lines: tLOW 7 us and tHIGH 6 us
    against the TB's own min_low_ns >= 4700 / min_high_ns >= 4000; the waits really
    are 1 us ticks (IN A, I2CTICK) rather than the 260-clock half-bit; dmem[10]/[11]/
    [13]/[15] match the firmware header and the TB's assertions; the LDM/SUB/JZ
    dispatcher is verbatim; the wire sequence matches firmware/i2c_adv.pe and the
    TB's N_RD-1 ACK accounting; and the 900-clock stretch is asserted as a real
    low-phase ext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
2026-09-26 docs(proto-ds18b20): the figure set, where the device speaks first
    diagrams/proto-ds18b20.puml the engine, both sides
    diagrams/proto-ds18b20-frame.puml the bytes, and the two slot grammars
    diagrams/proto-ds18b20-timing.puml the slots, in real numbers
    wiki/concepts/protocol-ds18b20.md the prose the figures summarise
    1-Wire inverts the DHT11's problem, and the figures are built around the two
    things that make it a different protocol rather than a variation: the DEVICE
    initiates (the presence pulse, so for the second half of the exchange the
    firmware reads a line the sensor is driving), and a read slot is sampled INSIDE
    the slot rather than between two windows.
    The ru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
2026-09-26 docs(proto-servo): fix the two derivations review pass 3 caught (D1, D2)
    Both were wrong in one specific way: internally consistent with each other and
    inconsistent with the formula printed a few lines away, so a reader who tried to
    REPRODUCE the table from the figure got a different answer from the measured one
    and had no way to tell which was wrong.
    D1. The pulse outer step. The figures said 4*152+11 = 619 clocks = 10.3 us. The
    family's own formula, total(n1,n2,n3) = (n1-1)*(10 + (n2-1)*(4*n3+7)) + 4,
    gives 10 + 1*(4*152+7) = 625 clocks = 10.4167 us. The short form misses the
    outer loop's six instructions and the four that return it. Multiply 619 out
    by 96 and you get 990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
2026-09-26 docs(diagrams): SPI mode 3 + CRC, UART RTS/CTS, MIDI 31.25k and DMX512-A figure sets
    Four more protocol figure sets on the same pattern as the I2C
    exemplar: a state machine of the engine as the code has it, a
    bit-level frame breakdown, and timing figures carrying measured
    numbers. Every figure is a block in one .puml with its colocated
    .png and .svg.
    proto-spi3-crc dmem[10]'s positional chain, bit_loop's four
    phases, the CRC fold in an ISA with no XOR; the
    40-rise frame in four fields; the capture edge
    proto-uart-flow the poll-not-timeout wait, the assert-before-wait
    order, the dispatch that replaces a table lookup;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
2026-09-26 docs(wiki): give debug-control.md headroom under the 200-line split threshold
    The page landed at 199 lines against wiki/SCHEMA.md's 'split a page when it
    exceeds ~200 lines'. That is technically compliant and practically fragile: the
    next person to add a sentence has to know the number. Tightened to 196.
    No fact dropped. Re-verified after the rewrite rather than assumed: the
    pe_ctrl.v:553 state equation, the pe_cpu.v:233 gate, the two-path hit split,
    IMEM_WORDS, the six-acts/5b4731f figure, 42 RED failures, 7/7 mutants, 18/22,
    S1-S4, the vacuous-claim removal, the full-width refusal, the latched-insn
    rule, BP_CLR's PC-at-the-request, and the run_all.sh wiring are all still
    present, and all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
2026-09-26 review(docs): pass 4, and a correction to the day record - the unwired act is sr04, not freqmeter
    TWO THINGS IN ONE PUSH, because they are both records and both are mine.
    PASS 4 (reviews/2026-09-26/DOCS-ACCURACY-REVIEW-PASS4.md). D1/D2 are WIDER THAN
    PASS 3 REPORTED: the servo figures were corrected, but
    wiki/concepts/protocol-servo.md:91-92 restates both in prose - "10.3 us for the
    pulses (on the (2,152) pair) and 77.6 us for the gaps (on (11,123))". A corrected
    figure beside a page that still says 10.3 and 77.6 is worse than either state
    alone, because the page looks authoritative and the figure looks like a draft.
    New, owner pw-diag-timing: D3, in the DS18B20 set - "69 clocks = 1.22 us"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
2026-09-26 docs: correct two wrong intermediate lines in the servo header, with the microsecond figures and derivations
    619 and 4655 where the per-step values are 625 = 4*152+7+10 and 5000 =
    10 + 10*499. Both microsecond figures moved with them -- 10.3 us and 77.6 us
    were correct for the OLD clock counts -- and both derivations were wrong, not
    just the totals. Comment-only, proven by an unchanged md5 of the reassembled
    image; no code touched.
2026-09-26 docs(review): C1-C3 closed - verified applied at origin/docs/diag-proto 35150cd
    C1, C2 and C3 are all applied and verified at the tip: zero files carry the
    pre-repair cpu_exec form (all four sites now quote pe_cpu.v:233's case equality),
    both maps list all four debug opcodes including 0x24 DEBUG_STATUS, and the tick
    is disambiguated by name - the 260-clock UART half-bit on port 7 STATUS against
    port 4 I2CTICK, the exact 1 us counter, cited to pe_soc.v:560, with the earlier
    "one tick" reading recorded as corrected. Closed on the corrections, not on the
    report: the reviewer's own ls-remote rule applies to review reads, and the three
    passes that re-reported these read a stale LOCAL ref (d17e07a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
2026-09-26 docs(wiki): five deep-reading protocol pages, one per bus act
    protocol-i2c-adv, protocol-spi3-crc, protocol-uart-flow, protocol-midi
    and protocol-dmx512. Each is written for someone reading the protocol
    cold: what it is, the wire format at cell level, the timing
    constraints with their tolerances, how the emulator implements it, how
    the testbench proves it, and the mutation coverage with a line per
    mutation saying which assertion fires.
    Two things worth calling out in the prose rather than burying:
    * The timing numbers are the ones I measured by running all five
    testbenches on this worktree, not the ones copied out of the
    findings file: SCLK period 4.367 us, CTS released at 417.22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
2026-09-26 review(docs): pass 5 - D1/D2 closed exemplarily, D3 has spread to a page, and the new wiki-pages gate is the strongest thing in the fleet but its negative control is unrun
    Rolling pass, and the first run against REMOTE tips rather than local refs now
    that C1-C3 have been re-verified.
    D1/D2 CLOSED (pw-diag-timing 6ff9491). The corrected figures carry 625 clocks =
    10.4167 us and 5000 clocks = 83.3333 us, and the old 10.3/77.6 values are gone
    from every file. The fix is better than the correction asked for:
    wiki/concepts/protocol-servo.md:100-101 now shows the CORRECT form and the WRONG
    form side by side (10 + 1*(4*152+7) = 625 against 4*152+11 = 619), and lines
    129-133 add a full reproduction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
2026-09-26 tools/diag): the numbers gate, and the D3 conversion fix it was built for
    D3: the DS18B20 set printed "69 clocks = 1.22 us" for the (2,13) pair. 69/60 is
    1.15. Fixed in both ds18b20 figures. Same shape as D1 and D2: copied from
    firmware/ds18b20.pe's header, which carries the same conversion error, and never
    derived. The manager is right that this is a PATTERN, and the four instances in
    two review passes are why the fix is a checker rather than another careful read.
    tools/diag/delay_lattice.py is that checker, and it does not look for the three
    strings the reviews found. It RECOMPUTES every "N clocks = X us" in every figure
    and every page, which catches D1, D2 and D3 without having been told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
    [delay_lattice.py]
2026-09-26 feat(host-gui): a step the chip has not run is now NAMED, or the build fails
    Prose staleness has bitten this package three times, and every instance had one
    shape: the evidence block lists the steps the chip HAS run and says nothing about
    the ones it has not, so a notice generated from the confirmed set reads as a claim
    about the whole package and a reader cannot tell a subset from a totality. The
    live instance is the chip repo's `tb/r2-vectors/manifest.json` - 18 steps, 15
    confirmed, the three ceiling/zero-count steps named nowhere, and a notice reading
    "every golden step in this package passes" over a table the chip had not finished
    running. That file is chip-side (see the WORKLOG BLOCKED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
    [r3_vectors.py, test_r2_vectors.py, vectors.py]
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2026-09-26 style: the pi-lens reformat of the enumeration guard (no behaviour change)
    Committed rather than discarded, which is the handling I recorded after getting it
    wrong once in this wrap. Both files are AST-identical to HEAD, so the diff is
    provably formatting-only: two statements joined onto one line each.
    Worth the gate run rather than the AST claim alone, because both of these files
    carry the build-enforced enumeration rule: a reformat that broke the
    `not_confirmed_enumeration` call, or the raise inside the hex-manifest gate, would
    have gone unnoticed by any check that only compared syntax trees for shape. The
    gate passes on the reformatted tree and all four enumeration tests still bite.
    [test_r2_vectors.py, vectors.py]
2026-09-26 review(docs): pass 6 - a figure set that quotes measurements it does not ship, and the wiki-pages gate's negative control run and proven real
    Rolling pass over docs/diag-bus 6c89c07 - four new figure sets (SPI mode 3 + CRC,
    UART RTS/CTS, MIDI 31.25k, DMX512-A) and five new wiki/concepts pages - plus the
    wiki-pages gate's negative control, which the manager asked to be EXECUTED rather
    than read, on the grounds that a negative control which is decoration is the one
    thing this project has been burned by.
    THE FINDING: proto-midi.puml and proto-dmx512.puml assert MEASURED numbers
    (31.9987 us, 88.06 us break against a 87.5 floor, 12.38 us mark against 8.0,
    3 999.8 ns = 250 010 baud) whose measuri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
2026-09-26 docs(proto-ds18b20): D3's third site, and the rule the gap was teaching
    D3 WAS SPREAD, and the manager's rule is the right one: A FIGURE CORRECTION IS
    NOT DONE UNTIL THE COMPANION PAGE IS CHECKED. Of the three sites, the two in
    diagrams/proto-ds18b20.puml (:47 and :71) were already fixed in bbbb1ff; the
    third - wiki/concepts/protocol-ds18b20.md:158 - was LIVE, and the page is the one
    a reader quotes. It now reads 69-clock (1.15 us) and carries the correct-vs-wrong
    note the servo page got, because 69/60 = 1.15 exactly and the page's own
    derivation - (23-1)*69+4 = 1522 clocks = 25.37 us - is only consistent with 1.15.
    WHY THE GATE DIDN'T CATCH IT, which is the part worth having. The conversio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
    [delay_lattice.py]
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2026-09-26 docs: correct three figures and two counts in my own protocol pages
    Self-audit after noticing 6 of the 25 figures had shipped without ever
    being looked at. Reading the PNG is what caught the 0x90/0x00 bit errors
    twice already; not looking is the same mistake as a check that cannot
    fail. Three of the six were wrong.
    THE FIGURES
    proto-uart-flow_001 the title claimed "the ninth clock is the
    handshake", which is false: the tenth cell is the stop bit and the
    handshake brackets the whole frame. Its cells also carried no bit
    values, and one arrow had THE RECEIVER DRIVING RTS, which it never
    does. Title, values and arrow all fixed.
    proto-uart-flow_002 omitted the RTS assertio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
2026-09-26 docs: cross-artefact audit — two denominators and one stale count, corrected
    Ran a consistency audit across the six artefacts I own (3 figures, 2 maps, 4
    wiki pages) with every count re-derived from the machine-recorded ground truth
    (formal/results/summary.txt, mutants.txt, run_formal.sh, formal/mutants.sh,
    tb/). The wiki pages were written AFTER the maps, so nothing had ever checked
    them against each other. It found three things.
    GROUND TRUTH RE-DERIVED, AND IT CONFIRMS THE PAGES:
    10 gate rows (8 PROVED / 1 REACHABLE / 1 VACUOUS; 6 bmc + 4 induct)
    14 mutants, all CAUGHT (4 bmc + 10 induct)
    5 modules; 11 targets = 10 + the SMT unlock
    Every denominator already in the pages matches.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
2026-09-26 review(docs): pass 7 - a response rule that does not reproduce the bytes, D3 closed in the docs, and a numbers gate with no negative control
    Rolling pass over the five new wiki/concepts pages on docs/diag-bus (the item
    pass 6 named highest-risk, because D1/D2 and D3 each survived in a page), the
    SPI3/CRC and UART-flow claim details pass 6 ran out of room for, and D3's current
    state.
    CORRECTION, owner pw-diag-bus. protocol-spi3-crc.md:103 says the slave's response
    is "resp = word XOR 0x7E5A, applied byte-wise", and offers it as the reason the
    responses are computed rather than played back. It does not produce the
    firmware's response bytes. firmware/spi_mode3.pe states 0x6B, 0x2C, 0xD9; the
    s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
2026-09-26 docs(firmware): correct two header figures the wire contradicts
    Comment-only, batched as routed. Both are numbers a reader would take as
    measured, and both are wrong.
    (1) firmware/spi_mode3.pe claimed the three response bytes are 0x6B, 0x2C,
    0xD9. tb_pe_soc_spi3.v shifts 0x13, 0x12, 0x11 and RESP_MASK is 16'h7E5A,
    so each wire byte is that value XOR 0x7E, which gives 0x6D, 0x6C, 0x6F --
    wrong on all three of the old values, not off by a typo in one. Verified
    from the TB rather than transcribed: the same file also contains a
    three-byte group 0x56, 0x45, 0x34 that yields 0x28, 0x3B, 0x4A on the wire,
    so the two groups are distinguishable and 0x13/0x12/0x11 is the response
    one. The corrected l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
2026-09-26 docs(wiki): the host stack, as one deep-reading page
    `wiki/concepts/host-stack.md` (197 lines) is the page a reader wants when they
    need to understand the host side as a system rather than a file at a time: the
    Pico MicroPython bridge and the wait-word trimming at the read boundary, the
    `ControllerSession` state machine and which refusals are the chip's versus host
    policy, `FakePE` and the two places it cannot go, the golden packages and why
    their conformance is byte-exact, the GUI's capability table and two poll paths,
    the three fuzz/soak harnesses, and the board procedure.
    Two things this page is careful about, because both are easy to get wrong in the
    direction of overclaiming:
    * it kee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
2026-09-26 docs(proto-sr04): the figure set for a RED act, marked red
    diagrams/proto-sr04.puml the engine, and the failing state
    diagrams/proto-sr04-frame.puml the exchange, and the conversion that is the act
    diagrams/proto-sr04-timing.puml the timing table, marking what is measured
    wiki/concepts/protocol-sr04.md the prose, with the red state stated up front
    THIS ACT IS RED, and the figures say so in their titles rather than drawing over it.
    tb_pe_soc_sr04.v elaborates on real RTL and fails five checks. It is also NOT wired
    into regress/run_all.sh, so a green gate says nothing about it in either direction -
    which is how an act can sit in the tree looking finished. The numbers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
2026-09-26 docs: the (2,13) pair is 69 clocks = 1.15 us, not 1.22 -- and my own first check of it was wrong
    Comment-only, and proven so: the reassembled freqmeter image is md5-unchanged
    after the edit. Worth recording that my first verification computed the step as
    4*(2*13)+17 = 121 clocks and briefly made the manager's 69 look impossible --
    the pair is (n2=2, n3=13) and the step is 4*n3 + 7 + 10 = 69. Third derivation
    in this block's comments found to be wrong by nobody counting.
    [peasm.py]
2026-09-26 docs(wiki): the ISA and the SoC wiring, as two architecture concept pages
    Satisfies the wiki-pages gate item and the architecture dispatch.
    GATE ITEM: debug-control.md now carries 3 distinct outbound wikilinks (SCHEMA
    needs >= 2). The gate predicted ONE; that was measured against an older state -
    b7ffeed had already added [[concepts/formal-verification]], so the count was 2
    before this change. The third is the frozen contract review,
    [[../reviews/2026-09-25/R3-DEBUG-CONTROL-CONTRACT]], verified to resolve. Not
    concepts/overview, because that page does not exist.
    THE PAGE IS SPLIT, because the threshold could not be met by shaving. The
    dispatch asked for one deep-dive at concepts/isa-and-so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
2026-09-26 docs(firmware): correct servo_sweep's two step figures from its own formula
    The third routed header fix, applied here rather than on fw-bus-protocols
    because servo_sweep.pe does not exist on that branch (it lives on main and
    fw-timing-protocols) and this tree has main merged in -- so the correction
    lands WITH BLOCK 3 rather than needing a second change on another worker's
    file.
    Both figures were derived rather than taken on trust. The file states its
    own reachability formula two paragraphs below the bad lines:
    (n1-1) * (10 + (n2-1) * (4*n3 + 7)) + 4
    so one step of the OUTER counter is 10 + (n2-1)*(4*n3+7), and applying that
    to the n2/n3 the code actually loads (LDI A, 2 / LDI A, 152 f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
2026-09-26 tools/diag): the gate must not crash on a path it did not expect
    Found by running the self-test from a COPY of the file rather than from the tree,
    which is what verifying a delivery off the pushed ref requires. Path(__file__)
    .resolve().parents[2] assumes the script sits exactly three levels below the repo
    root; from /tmp it raised IndexError, and the gate reported NOTHING about any
    number.
    That is the failure mode the gate exists to prevent, wearing the gate's own
    clothes. A traceback reads to a human as "the checker is broken" rather than as
    "the numbers are unchecked", and the one conclusion that must not be available is
    the first one. It is the same class as the two self-test bugs alrea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
    [delay_lattice.py]
2026-09-26 docs+rtl: the maps are the architecture authority; correct a CRC budget comment that was wrong in two places
    TWO THINGS, one commit, and the second was verified rather than complied with.
    1. DOCS AUTHORITY (manager ruling, 2026-09-26), now a standing order in
    COLD-START.md where the documentation workers read it. The maps
    (project-plan / project-progress) are the ARCHITECTURE authority and live on
    main; a protocol figure must cite the RTL, the frozen contracts or the frozen
    reviews DIRECTLY and must not restate a map claim as its source - a figure
    quoting a map is a defect in the figure. Maps may LINK figures, never the
    reverse. Plus the map-trigger for the rolling review: when the maps cha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
    [pe_crc.v]
2026-09-26 tools/diag): assert the coverage list, because a list that can drift is not a claim
    The gate carried a HAND-MAINTAINED list of the 32 files it scans. It happened to
    be complete - 24/24 figures, 8/8 pages, sets verified identical - but nothing
    ENFORCED that. Add one figure or one page and the gate silently stops checking
    it: the file is simply absent from the list, so there is no failure to observe
    and nothing to notice.
    That is regress/check_mutation_lists.sh's exact failure mode - a MISSING ENTRY
    made a gate SKIP work it was supposed to do - and having written four
    missing-entry errors in the diagrams, writing the fifth into a gate meant to
    catch them is worth naming rather than fixing qui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
    [delay_lattice.py]
2026-09-26 docs: wire the new pages, correct the pre-turbo CRC budget, and collect a cleared pin
2026-09-26 test: fail the wiring cases closed when run_all.sh is absent, and prove the control non-vacuous
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2026-09-26 wiki: 12 pinned rule violations to 0, and the pins with them
    check_wiki_pages.sh reported 12 violations across 8 pages, all pinned in
    wiki/.known-rule-violations.txt. All 12 are now fixed and the file has no entries
    left: 30 violations -> 18, 12 pinned -> 0, and NOT ONE new violation introduced.
    no-frontmatter 4 plans/ethernet-soc, plans/i2c-transaction, plans/pe-ctrl,
    reference/simulator-bakeoff
    zero-outbound-links 8 the same four, plus plans/host-controller-gui,
    plans/pe-ctrl-readback, plans/serdes-integration,
    plans/spi-pads
    THE LINKS ARE REAL CROSS-REFERENCES, NOT DECORATION. Six of the eight pages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
2026-09-26 docs: name the 29 sibling act figures in the maps, and un-stale my own drift note
    Two items, both mine, both following from the staleness that bit me last turn.
    THE MAPS NAMED NONE OF THE 29 SIBLING FIGURES. They only ever named my own
    three, so a reader of the project maps could not find 29 delivered figures -
    the same gap I fixed for the wiki pages one turn earlier, in the file I own.
    Both maps now carry a per-act package describing the CONVENTION rather than
    listing 29 nodes, because a list that long stops being a map:
    proto-<act> the act's own figure - 13 acts
    proto-<act>-frame the frame / encoding layer - 7 acts carry one
    proto-<act>-timing the cell / cadence layer - 7 a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
2026-09-26 tools/diag: harden the gate after running the repo's gates over it
    "wired in" is not "works in situ", so: ran the repo's own linters over
    the new tool, and the new tool over the repo. Four findings, two of them
    in this file.
    A COVERAGE GAP THAT IS NOT MINE TO FIX
    regress/check_shell_syntax.sh globs regress/*.sh, so its "34 scripts"
    excludes all 7 shell scripts under tools/ -- this gate included. The
    gate is also outside the 16-harness lock/preflight registry. Both are
    another owner's file; recorded rather than silently expanded into.
    TWO REAL DEFECTS IN THIS GATE
    1. The stem list was read as `for st in $(expected_stems ...)`, which
    word-splits. A source named "my figure.puml" was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
2026-09-26 tools/diag): make the [sic] exemption SELF-LIMITING - it can no longer outlive its defect
    I wrote the finding "a marker that outlives the thing it marked is worse than no
    marker" in the previous commit, and then left my own gate fully able to do exactly
    that. A [sic] skipped its line FOREVER. The whole expected life story of a
    documented defect is that somebody FIXES it - and at that moment an unexamined
    exemption starts switching off a REAL CHECK on a line that has become correct.
    Nothing noticed, and nothing was going to.
    That is the same shape as the wiki baseline's STALE direction: a pin that stops
    failing must be removed. I built that direction into somebody else's gate and not
    into my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
    [delay_lattice.py]
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2026-09-26 tools/diag): automated reformat - verified cosmetic, not just assumed
    AST identical after the parse, self-test 13/13, and the real-tree stale-marker
    control still fires: appending a CORRECT conversion marked [sic] to
    protocol-sr04.md gives 'STALE [sic] - the conversion it marks is CORRECT, so the
    marker is switching off a real check' and exit 1. Restored afterwards.
    Committed rather than left dirty on the standing rule: an unexplained
    modification to a gate is indistinguishable from a tampered one.
    [delay_lattice.py]
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2026-09-26 tools/diag): outbound links must RESOLVE, not merely be counted
    check_wiki_pages.sh counts DISTINCT outbound wikilinks and fails below two.
    That is a good rule and it is not a check of where the links GO: a link to a
    page that was never written, or that has since been renamed, satisfies it
    perfectly. A count is not a check, and this branch's own pages are exactly the
    kind of artefact a reader follows a link from.
    So the numbers gate now resolves every [[wikilink]] in the eight pages it owns
    and fails on one that resolves to nothing. Only my pages: the corpus-wide version
    belongs to whoever owns regress/, and the gap is reported rather than half-fixed
    here.
    THE FIRST VERSION OF THIS CHECK R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
    [delay_lattice.py]
2026-09-26 tools/diag): backticked repo paths must EXIST, and two of mine did not
    The sibling of the outbound-link check, and it exists because a question I had
    never asked of my own pages turned up an answer I did not like: of 85 file-path
    references in the eight pages this branch owns, TWO resolved to nothing.
    They are `firmware/bmc_frame.pe` and `tb/tb_pe_soc_bmc.v` in the FM0/FM1 page,
    and both live only on fw-timing-protocols. The page was HONEST about that - the
    very next line said so - but a reader who scans the first mention gets a path
    that does not open, on the one page whose entire subject is being honest about
    status. They are now written branch-qualified, `fw-timing-protocols:path`, which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
    [delay_lattice.py]
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2026-09-26 wiki: bump protocol-fm-biphase.md's `updated`, on the gate's own finding
    The one-line fix, and the numbers gate found it: the page declared
    `updated: 2026-09-25` while its content last changed 2026-09-26, in my own 577aa55.
    SCHEMA's fifth rule, enforced for the eight pages this branch owns, on its author.
    Checked the other seven before assuming they were fine rather than broken: all
    seven declare 2026-09-25 and all seven last changed 2026-09-25. One stale page,
    not a pattern - which is the more useful answer, because "seven more are wrong"
    would have been a different and much larger piece of work.
    I ALSO CHECKED A HYPOTHESIS BEFORE ASSERTING IT, and it was wrong. The manager's
    ruling that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
    [delay_lattice.py]
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2026-09-26 HC-SR04: the testbench matches the one-answer design -- two runs, each answer read AS IT IS BANKED
    The firmware at 614152c measures ONE distance, banks one answer at dmem[6..7]
    and parks; the testbench still expected two per run, so the act was one edit
    from green. Restructured exactly as the 23:45 recipe prescribed, and the
    recipe was right about every step.
    * a LOOP over the two distances, and the model RE-ARMED per run. The
    re-arm is not tidiness: the model's recovery window is 1.5 ms and the
    reset takes 20 us, so a model carrying its state across the reset would
    ignore the second run's trigger and bank nothing -- silently, because a
    model deaf for a millisecond and a h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
    [peasm.py, tb_pe_soc_sr04.v]
2026-09-26 Wire the HC-SR04 case green: remove the <<wip>> marking, and fix three things the coordination review found
    (1) THE <<wip>> MARKING IS GONE, which is the self-expiring check doing its
    job: a <<wip>> case that PASSES is reported as a failure telling you to remove
    the marking. The comment above the case now records that it was wired red on
    purpose (a red act nobody can see is a claim hazard -- "47/47 PASS" would then
    read as "the ranging act is verified" when nothing had ever run it) and that
    the exemption has now been removed against that same standard.
    (2) THE IMAGE LENGTH IS COUNTED, NOT ASSUMED. $readmemh asked for [0:1023]
    from a 387-word file and printed a warning every run that nobody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
    [tb_pe_soc_sr04.v]
2026-09-26 tools/diag): retire the outbound-link check - check_wiki_links.sh subsumes it
    main gained regress/check_wiki_links.sh, which is the corpus-wide dead-link gate
    I reported as "not mine" - and it does the job better than my page-local version
    did. It resolves BOTH wikilink conventions, which is the exact thing my resolver
    got wrong on its first run and which cost me a false "all 32 links dead" report;
    it treats `sources:` as a citation rather than an outbound link; it percent-encodes
    records so prose containing a tab cannot corrupt the baseline; and it is green
    corpus-wide: 72 documents, 720 links, 0 dead, 0 pinned.
    So my check_outbound_links is a duplicate that can disagree with an authoritat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
    [delay_lattice.py]
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2026-09-26 Act (c): arm the stimulus on the release, count the half-interval in clocks, and seed the two bytes the firmware read before writing
    Not green, and the commit says so. Four changes, two of which are real bugs
    that do not explain the failure, which is stated here rather than left for the
    next reader to assume.
    TESTBENCH:
    * THE STIMULUS IS ARMED BY THE FIRMWARE'S RELEASE. It began at time 0,
    delivered all 24 bits, and froze inside its own `forever #(CLK_NS);`
    roughly 15 us BEFORE the core was released, because load_firmware()
    writes 1024 words first. The firmware was started into a line that had
    been idle high since before it began, saw a CONSTANT level, and reported
    0xF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
    [tb_pe_soc_bmc.v]
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2026-09-26 docs(proto-sr04): the act is GREEN - re-measured, and the page now says so
    Consolidated update, all six items, from a fresh run on the merged tree rather than
    from anyone's summary. tb_pe_soc_sr04.v now prints:
    image: 387 words loaded from firmware/sr04_range.hex (637 NOP-filled)
    run 0: echo 1160 us -> firmware 1160 us, answer 199 mm (expected 199 mm)
    run 1: echo 5816 us -> firmware 5816 us, answer 999 mm (expected 999 mm)
    run 2: echo 2000 us -> firmware 2000 us, answer 343 mm (expected 343 mm)
    run 3: echo 8000 us -> firmware 8000 us, answer 1375 mm (expected 1375 mm)
    PASS: all checks
    (1) THE NARRATION WAS THE BIGGEST ERROR AND NOT IN THE DIRECTION I EXPECTED. The
    page said "th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
    [delay_lattice.py]
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2026-09-26 Act (c): the splice is repaired and the interval is MEASURED, against a derivation
    Two repairs, and the second one is the one that mattered, because the repair
    note for it was WRONG about the cause.
    1. THE DEAD TAIL IS GONE. firmware/bmc_frame.pe's the_pin block ended
    50 JZ first_half / 51 JMP bit_edge
    52 LDI A,0 / 53 STM 8,A / 54 JMP bit_edge / 55 JMP main <- half_done
    and 52..55 were DEAD, because 51 leaves the block first. `half_done` was a
    label NOTHING EVER JUMPED TO. A reachability pass over the assembler's
    listing now reports one unreachable word, and it is `park: JMP park`, the
    halt -- a dead LABEL, not a dead tail.
    2. THE `JMP bit_edge` AT 51 WAS NOT MIS-T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
    [tb_pe_soc_bmc.v]
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2026-09-26 Act (c): the boundary decision, written from a model -- and the model is exact
    THE DECISION, from the three wire rules, modelled on the derived level
    sequence BEFORE one instruction was written:
    interval == 4 us -> this transition is a MID
    interval == 2 us, previous was a BOUNDARY -> this transition is a MID
    interval == 2 us, otherwise -> this transition is a BOUNDARY
    anything else -> the clock is lost, emit nothing
    A run of two-microsecond intervals is AMBIGUOUS on its own -- [mid, boundary,
    mid] and [boundary, mid, boundary] both measure 2, 2 -- and ONE BIT of history
    resolves it. dmem[15] is that bit and it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
    [tb_pe_soc_bmc.v]
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2026-09-26 act (c): the phase is fixed BY THE MODEL, and the same frame both ways gives two flags and three bytes
    fm_model.py, written from the wire rules before any edit, reproduces the
    measured fault and then the fix: the resync now leaves the phase UNKNOWN
    (dmem[15] = 2) and nothing is emitted until an interval that only a mid can
    produce, so the loss is designed out of the preamble rather than compensated
    for. The flag is read off the preamble's received byte (0xFF = FM0, 0x00 =
    FM1), the payload is inverted under FM1, and the testbench runs the same frame
    twice, once per polarity, reset between.
    Also lands three faults the phase being right made visible: the wire is high
    bit first (the ISA's shif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
    [tb_pe_soc_bmc.v]
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2026-09-26 act (c): the encoder TRANSMITS, and the delay loop was a running sum
    The manager's LOOPBACK ruling is implemented to the model, the SHR finding is
    corrected in all three places, and the encode direction is still red -- on the
    testbench's side, with the firmware's wire now measured and explained.
    THE MODEL COMES FIRST, as the handoff ordered, and it is the thing the firmware
    was written against: firmware/bmc_model.py grows a Tx that builds the return
    leg half-interval by half-interval from the wire rules in both polarities,
    checks it against the wire rules interval for interval (80 of 80 in each), and
    runs the ROUND TRIP through its own receiver at three offsets and both idle
    levels. The mod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
    [labels.py, probe_delay_routes.v, probe_out_gap.v, probe_out_seq.v, probe_pad_intervals.v, probe_tb_classify.v]
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2026-09-26 act (c): the mask is in -- the wire matches the model exactly, 46 one-half and 16 two-half gaps
    dmem[11] holds the MASK and the byte is read beside it, so the encoder sends
    HIGH BIT FIRST without peeling: SHR takes a mask down one place, which is the
    one thing a shift-right is good at, and there is no shift-left to re-align a
    peeled byte with.
    All 24 routes between two OUT TXPIN are exactly 120 clocks, and the pad's
    interval histogram is the model's: 63 changes, 46 one-half gaps, 16 two-half
    gaps, per pass. That is the proof the fix is right, and it is the number the
    whole act was measured against.
    Two faults fixed in the testbench's decoder: the data bit was the level on the
    wrong side of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
    [tb_pe_soc_bmc.v]
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2026-09-26 act (c): the seam, and a probe edge that made two bit strings disagree by one bit
    The preamble took exactly eight mids -- 0x7f after seven and 0xFF on the eighth,
    with the flag at 0 -- so the preamble is neither short nor long and the payload
    begins on the ninth mid, which is a5's bit 7.
    But both bit-string probes read dec_pre, dec_bit, dec_acc and dec_mids in an
    always block AFTER the decoder's own, so they see the values the decoder has
    already updated in the same clock: at the clock where the eighth preamble bit
    arrives, dec_pre is already 0 and dec_acc already reset, so a probe that banks
    when !dec_pre banks a PREAMBLE bit as the payload's first. That is why the two
    strings differ by on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
    [probe_seam.v]
2026-09-26 docs(WORKLOG): act (c) -- two instruments wrong in one entry, and the level measurement is NOT established
    The +605-clock gaps looked like the fifth placement error, so the probe was
    rewritten to use L_enc_drive -- the label labels.py exists for and the probe had
    been ignoring -- and the output is byte-for-byte IDENTICAL. The address was right
    all along; a hypothesis that fits and a measurement that confirms are not the
    same act, and I ran the second one.
    What is actually wrong is that the probe misses OUTs: 605 = five half-intervals,
    so four executions in a row went unreported, and the probe still printed a
    plausible table. Every row present reads A = 40, which would mean the mid does
    not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
    [probe_out_seq.v]
2026-09-26 docs(WORKLOG): act (c) -- the instrument is still not proving itself, and the levels are still unmeasured
    The probe's row labels lag by one (the counter increments non-blocking and the
    display is in the same clock), which is why consecutive printed labels are not
    consecutive hits and the gaps could not be read as missed events. And the TOTAL
    line -- the one number that would settle 80-or-77 -- never printed at all, so a
    probe whose summary does not appear cannot certify itself.
    So the levels the encoder drives are UNMEASURED, and the table says so: the
    histogram, the mask sequence and the 120-clock routes are all established; the
    levels are not, and the next context must not read the rows t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
    [probe_out_seq.v]
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2026-09-26 act (c): EIGHTY LEVELS, seventy-eight of them the model's -- and the two that are not explain everything
    The pad drove all eighty levels in both polarities, and seventy-eight match the
    model exactly. Positions 14 and 15 are SWAPPED: they are the two halves of the
    preamble's eighth and last zero, so the transition that belongs at 14 arrived at
    15, which turns one one-half gap into a two-half gap.
    That is the four-microsecond gap inside the preamble's run of eight zeros that
    the receiver's trace reported and nobody could place, and it explains every
    symptom at once: the extra two-half gap is a phase lock, so the receiver locks one
    half-interval early (the two four-microsecond gaps in a row, t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
    [probe_levels.v]
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2026-09-26 docs(WORKLOG): act (c) -- the gate ran the complement at c=14 and the listing says it cannot have
    Both sides of the same instruction at last. The mask is right -- 0x80 0x40 0x20
    0x10 0x08 0x04 0x02 0x01 and back to 0x80 -- and the levels are right for
    fourteen half-intervals and inverted for exactly the two halves of bit 7. So the
    mask is exonerated and the anomaly is inside one bit.
    The gate cannot have done it: at c=14 with dmem[3]=0, s = ((14 AND 1) + 0) AND 1
    = 0, the JZ is taken, and the keep route is MOV A, Y with Y = dmem[11] AND 0x80
    = 0x01 AND 0x80 = 0. The pad should read 0x00 and reads 0x40, and the
    complement route is the only way to get 0x40.
    So either dmem[6] was ODD at the g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
    [probe_bit14.v]
2026-09-26 docs(WORKLOG): act (c) -- the gate is correct at every half-interval, so the firmware is exonerated and the probes are not
    Sampled AT the gate's own instructions: dmem[6] is the half-interval number,
    dmem[3] is zero throughout, s is the parity, and the keep and complement routes
    alternate exactly as the listing says -- at c=14 included. So the gate is not the
    fault, the mask is not the fault, the byte dispatch is now right, and the encoder
    does what the listing says.
    And yet two probes disagree about A at c=14 twenty instructions apart: A=0x00 at
    the gate's JZ, A=0x40 at the OUT, and the listing says A cannot change between
    them. So one reading is wrong and the firmware is not.
    That is the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
    [probe_gate.v]
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2026-09-26 feat(eth-tx): 10BASE-T line driver -- eth_tx_n pair on uo_out[3], link pulses, TP_IDL
    A single-ended eth_tx that idles high cannot make the three line states
    10BASE-T needs (+, -, 0 V), and nothing sent normal link pulses, so a real
    switch or NIC would declare link failure after 50-150 ms and ignore every
    frame. PROPOSED: the uo_out[3] (dbg_pc[1]) reclaim is a pinout decision for
    the manager (STATUS item 4).
    - pe_eth_tx: registered line_drive -- every frame cell; a 3-cell (300 ns)
    TP_IDL after the FCS, an abort or either underrun; one 100 ns link pulse
    every NLP_CELLS = 160,000 quiet cells (16 ms). A pending start beats a due
    pulse, a start during a pulse waits one cell, a start insid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
    [pe_eth_tx.v, pe_soc.v, pin_budget.py, signal_glossary.py, tb_pe_eth_tx.v, tb_pe_soc_eth_loop.v, tb_pe_soc_eth_tx.v]
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2026-09-26 feat(regress): the F1 enforcer -- TXLEN latch atomicity is no longer comment-only
    F1 (validate-and-latch ATOMICALLY at the start pulse; a mid-flight TXLEN write
    affects only the NEXT frame) was enforced by nothing but two comments, while F2
    is pinned at five layers. A line-driver change that moved the capture point --
    pend_len <= frame_len leaving the same arm of the same if-chain as the !len_ok
    guard -- would have turned no gate red.
    Two pieces, both purely additive (67 + 39 lines, zero removals):
    tb/tb_pe_eth_tx.v test_f1_apply_window sweeps all SIX phases of the
    DIV-1 5-clock apply window, rewrites TXLEN to a RUNT
    (13) inside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
    [tb_pe_eth_tx.v]
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2026-09-27 docs: the (b) sweep's frequency range was a microseconds column read as a rate
    'twelve points from 80 Hz to 10 kHz' -- there is no 80 Hz point in the sweep
    and cannot be: 80 Hz would be a 12500 us period and the longest in the table is
    10000 us. The 80 is p_us[16] = 80 MICROSECONDS, the fastest banked point, i.e.
    12.5 kHz. The banked set is 100 Hz to 12.5 kHz, so the figure was wrong at both
    ends, and the same wrong range was in firmware/freqmeter.pe.
    How it propagated: the TB's summary line prints 1_000_000/p_us[0] and
    1_000_000/p_us[N_PTS-1] -- the first and last DRIVEN period -- immediately
    after a banked-point count, so it reads as 'the count of these'. Both wrong
    copies came from there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
    [tb_pe_soc_freqmeter.v]
2026-09-27 test(bmc): the write-hook that was claimed and did not exist -- and it finds the claim WRONG
    bmc_frame.pe's header said dmem[8] 'is 2 or 4 and nothing else -- measured, not
    assumed: the write-hook counts 18 twos and 13 fours over one frame and no six.'
    There was no such write-hook, and tb_pe_soc_bmc.v's failure message claimed the
    firmware's write-hook 'is graded against exactly these numbers' -- a check
    reporting another file's arithmetic as if it had measured it.
    The hook now counts STORES on the CPU's data port, not memory samples: a
    change-detector is cheaper and would be wrong, since it cannot see two
    identical intervals in a row and on this wire most intervals repeat.
    MEASURED over b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
    [tb_pe_soc_bmc.v, tb_pe_soc_freqmeter.v]
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2026-09-27 fix(R3): the README's Status claim is now a CHECKED RENDERING, not prose
    This closes the verification gap I recorded as open rather than papering over
    it: the R3 package's headline claim was checked for SELF-CONSISTENCY and nothing
    else. Measured, not assumed:
    grep -c "README|\.md" tools/gen/annotate_r3_confirmations.py -> 2
    and both of those are citations inside the manifest's own `notice` string. The
    only three read_text() calls in the file are DIVERGENCES, HOST_MANIFEST and
    TB_MANIFEST. No markdown is ever read.
    So the gates were: --check re-derives chip_evidence, chip_confirmed, notice and
    every per-step flag from the pinned divergences (strong, and silent about prose),
    and the sui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
    [annotate_r3_confirmations.py]
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2026-09-27 fix(delay-lattice): the `updated:` remedy line recommended the one value that dies at commit time
    The FAIL line read "Bump the date or revert the change", which plainly
    invites the reader to stamp the date the content last CHANGED. The comparison
    is against the author date of the last commit, so that value passes on an
    uncommitted working tree -- git reports the previous commit -- and turns the
    identical bytes red the instant the edit is committed. The resulting fix looks
    finished and is a permanent red.
    Measured on this repository rather than argued: six pages stamped with their
    last content-change date passed the gate unstaged and failed it after the
    commit (d75d005), and re-stamping them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
    [delay_lattice.py]
2026-09-27 docs(r3): the confirmation tool's own docstring was the last R3 drift
    The gate is green and correct: --check derives 25 of 26 confirmed, all cited,
    and regen is a byte-identical no-op, so the manifest carries no drift. The
    README's "25 of 26 ... 26/26 steps byte-exact" is the checked prose and matches.
    The one stale artifact left was the tool's own module docstring, which still
    described the arithmetic as "23 confirmed, 3 not" -- the ruling as it stood
    BEFORE the host-side vector-defect fixes (gui-worker b9d4eb2) that re-generated
    two of those steps to match the chip. The pinned set today is exactly
    {status_full_readback}, so 25/1 is the derived truth and the docstring was the
    one place in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
    [annotate_r3_confirmations.py]
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2026-09-30 feat(host_bridge): VvpTTAdapter - the real chip behind the bridge's 6-method HAL
    Implements the same duck-typed contract as TTAdapter (the SPI host-slave path)
    but routes framed SPI bytes to a vvp process running the real
    tt_um_protocol_emulator - the wrapper where pe_ctrl, the SPI host-slave, actually
    lives. That makes the real main.py bridge able to run unmodified against the real
    chip RTL with no board.
    The seam is one object: test_host_integration.py already drives the real bridge
    over LoopbackPort against FakeTTAdapter through a full round trip, so swapping in
    this adapter is a one-line setUp change. Everything above the HAL is exercised on
    both sides of it.
    Deliberately does NOT clos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
    [vvp_adapter.py]
2026-10-03 fix(host_bridge): clear the two adapter defects the integration lane reported
    The protocol worker built the real-bridge-over-real-chip lane and found two
    real bugs here, and reported rather than patched them because I gate this file.
    Both were wrong:
    1. BLOCKING. _start() built the testbench path as os.path.join("tb", ...) =
    "tb/x.v", but iverilog runs with cwd=repo_root/regress, so the path resolved
    to repo_root/regress/tb/x.v - absent - and every sim-backed step was blocked
    with "No such file or directory". The RTL list read from run_all.sh carried
    the ../ correctly for that cwd; the testbench was the one path missing it.
    Now ../tb.
    2. The adapter passed "+read_words=" whi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
    [vvp_adapter.py]
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2026-10-03 fix(host_bridge): bound the vvp adapter's compile and make its clocking honest
    iverilog and sram_model.sh now run under compile_timeout_s, and a missing
    or hung compiler raises VvpTTAdapterError instead of hanging or raising a
    raw OSError. period_ps is renamed period_ns (the testbench reads
    nanoseconds) and configure_host_spi now derives it from sclk_hz.
    set_clock returns the clock the testbench actually runs. close() is
    idempotent and records the first cleanup error; ignore_errors had been
    dropping it.
    [vvp_adapter.py]
2026-10-04 feat(tb): tb_pe_soc_extspi +script mode - a whole session, replayed in one run
    A +script run replays reset and run-pad events and every framed exchange
    from power-on, and writes each exchange's capture under an @<n> marker.
    This is what lets VvpTTAdapter carry chip state from one host exchange to
    the next. The single-shot +req mode is byte-identical (stdout and capture
    diffed against a pre-change baseline). Paths now hold 4096 bytes instead
    of 128, and a request or read budget past MAX_WORDS FAILs instead of
    being silently truncated.
    Amendment A (a)-(b): the lane's LOAD-then-READ_IMEM script exposed a real
    RTL defect - every host IMEM read returns the previous address's word
    (pe_soc.v:391-3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
    [tb_pe_soc_extspi.v, vvp_adapter.py]
2026-10-04 fix(host_bridge): VvpTTAdapter replays the session - chip state now carries
    Each transfer replays every reset, run-pad change and earlier transfer
    from power-on in one vvp run (+script), so the chip it meets is the chip
    a long-lived simulation would hold. Each replay must reproduce every
    earlier capture exactly, or the transfer raises 'replay diverged'. A
    failed transfer is dropped from the session. Requests past the testbench
    capacity are refused up front.
    The real-bridge-over-real-chip round trip is now green: run=1 after
    START, pc=2 (the image's JMP 2 is a jump to itself), and READ_IMEM and
    DUMP_CORE see the LOAD. New direct tests cover a LOAD persisting to the
    next exchange and pe_ctrl'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
    [vvp_adapter.py]
2026-10-04 fix(host_bridge): TTAdapter counts the read budget after the request
    FLAGGED FOR REVIEW: the HAL contract decision is still open. This commit
    stands alone so it can be reverted alone.
    pe_ctrl is half-duplex on the host bus, but TTAdapter counted the
    request's own words inside read_words. Its docstring and VvpTTAdapter
    both count them after the request. With the bridge's 21-word LOAD
    budget, every real-board LOAD of 8 or more words failed: 8-10 came back
    truncated, and 11+ found no frame. The adapter now discards what MISO
    carried during the request and clocks read_words words after it. The
    fake SPI is now half-duplex like the chip, and a 1..40-word LOAD sweep
    through the real bridge pins th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
    [main.py, tt_adapter.py]
2026-10-04 test(docs): select the triage TABLE row, not the first r2_read_* mention
    Reviewer ruling applied: fix the test selector; do NOT touch the runbook.
    The test took the FIRST line containing r2_read_* - the prose
    "Consequence for you" line (bringup line 44) - and asserted the current
    step total was in it. It now filters for the markdown table row that
    names the pattern and asserts exactly one such row, which is the triage
    row (line 138). docs/host-bridge-bringup.md is untouched.
    Measured: test_docs 38/38 OK; tools/host_gui/run_host_tests.sh exits 0
    (11/11 [ok], host gate PASS). Task 7 Step 3 green. Plan progress
    checkpoint updated in the same commit.
    [test_docs.py]
2026-10-04 test(host_gui): select the r2_read_* triage row by both markers; correct the read_imem reason
    Reviewer ruling applied (scope: these four files only; doc untouched).
    Item 1: test_docs.py's stale-step-count guard now selects the triage
    TABLE row by requiring BOTH "r2_read_*" and "FAIL" (collected to a
    list, asserted exactly one with a message naming the guard) instead of
    the first mention, which was the prose "Consequence for you" line. Every
    other assertion is byte-identical.
    Item 2 (red-green proof): single test PASS; mutating bringup line 138's
    count 22->99 made it FAIL; git checkout restored the doc byte-identical
    (git status clean); PASS again.
    Item 3 (strings only): the golden report'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
    [test_docs.py]
2026-10-06 fix(rtl): host IMEM reads answer their own address - pe_soc presents the macro output in the valid cycle
    The R2 host read port captured imem_rdata on the REQUEST edge, but pe_imem's
    read is registered (one cycle), so every host READ_IMEM answered the PREVIOUS
    address's word: after LOADing 0x0041 0x1001 0x4002, READ_IMEM(1,2) returned
    (0x0041, 0x1001). Invisible until now because every other pe_soc TB ties
    dbg_rd_req to 0, and tb_pe_ctrl_r2/r3 serve the read port from a TB-side image
    combinationally - the macro's registered read latency was in no gate.
    pe_soc presents imem_rdata directly in the dbg_rd_valid cycle: imem_addr is
    still the host's then (dbg_reading covers dbg_rd_req | dbg_rd_val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
    [pe_soc.v, tb_pe_soc_dbgread.v]
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
